eSpark-Backup/patrizio-moi-pcb-fixes/Design_Files/10 - Manley VS-MU - 21-June-2025/Deliverables/Renderings/2D_Top_Vieew.PNG

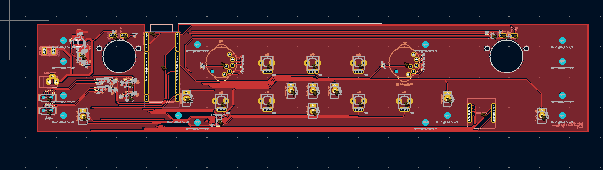
Design_Files/10 - Manley VS-MU - 21-June-2025/Deliverables/Renderings/2D_Top_Vieew.PNG
