eSpark-Backup/patrizio-moi-pcb-fixes/Client-Files/04 - UREI_V3 - 30-July-2025/Production Files/Bills of Materials/BOM.xlsx

Comment | Designator | Footprint | LCSC Part Number | Quantity
D1 | BAT54SW | Diode_SMD:D_SOD-323 | C27636114 | 1
AudioIn1 | AudioIn | Connector_Audio:Jack_3.5mm_PJ320D_Horizontal | C22459515 | 1
MUX1 | CD4067BMT/TR | Package_SO:TSSOP-24_4.4x7.8mm_P0.65mm | C7432333 | 1
U1 | MP2307DN-LF-Z | Package_SO:SOIC-8-1EP_3.9x4.9mm_P1.27mm_EP2.29x3mm_ThermalVias | C2928813 | 1
R19 | 43â€¯kÎ© | Resistor_SMD:R_0402_1005Metric | C2906943 | 1
C6,C10,C11 | 22uF | Capacitor_SMD:C_0603_1608Metric | C59461 | 3
L1 | 10ÂµH | Inductor_SMD:L_Bourns-SRN8040_8x8.15mm | C37429 | 1
R1 | 4.7KÎ© | Resistor_SMD:R_0402_1005Metric | C25900 | 1
R23 | 3.3KÎ© | Resistor_SMD:R_0402_1005Metric | C25890 | 1
R3,R4,R5,R6,R7,R8,R10,R11,R12,R13,R14,R15 | 2.2KÎ© | Resistor_SMD:R_0402_1005Metric | C25879 | 12
R25 | 47KÎ© | Resistor_SMD:R_0402_1005Metric | C25792 | 1
R21,R22,R24 | 10KÎ© | Resistor_SMD:R_0402_1005Metric | C25744 | 3
R20 | 10â€¯kÎ© | Resistor_SMD:R_0402_1005Metric | C25744 | 1
R17 | 10K | Resistor_SMD:R_0603_1608Metric | C25744 | 1
R2,R9 | 100Î© | Resistor_SMD:R_0402_1005Metric | C25076 | 2
C12,C13,C14,C16 | 4.7uF | Capacitor_SMD:C_0402_1005Metric | C23733 | 4
C8 | 4.7â€¯ÂµF | Capacitor_SMD:C_0402_1005Metric | C23733 | 1
C1 | 0.1uF | Capacitor_SMD:C_0402_1005Metric | C14663 | 1
C2,C3 | 2.2uF | Capacitor_SMD:C_0402_1005Metric | C12530 | 2
R16 | 1kÎ© | Resistor_SMD:R_0402_1005Metric | C11702 | 1
OpAmp1 | MCP6002- | Package_SO:SOIC-8_3.9x4.9mm_P1.27mm | C7377 | 1
NPN_Transistor1 | 2N2219 | Package_TO_SOT_SMD:SOT-23 | C2150 | 1
C5 | 2.2nF | Capacitor_SMD:C_0603_1608Metric | C1604 | 1
C17 | 0.1uF | Capacitor_SMD:C_0402_1005Metric | C1525 | 1
C4,C7,C9 | 0.1â€¯ÂµF | Capacitor_SMD:C_0402_1005Metric | C1525 | 3
VU73_Lamp-1 | VU73_Lamp | Connector_PinSocket_2.54mm:PinSocket_1x02_P2.54mm_Vertical | NILL | 1
VU73-1 | VU73 | Connector_PinSocket_2.54mm:PinSocket_1x02_P2.54mm_Vertical | NILL | 1
USR-ES1 | USR-ES1 | RF:USRES1 | NILL | 1
toggle_sw1,toggle_sw2,toggle_sw3,toggle_sw4,toggle_sw5,toggle_sw6,toggle_sw7,toggle_sw8 | button | Button_Switch_THT:SW_PB21E09471-465 | NILL | 8
SW1,SW2 | SW_Rotary_1x7_MP | SW_Rotary:SW_Rotary_RS25-7P | NILL | 2
R26 | 92R | Resistor_SMD:R_0402_1005Metric | NILL | 1
R18 | 100kÎ© | Resistor_SMD:R_0603_1608Metric | NILL | 1
Power_jack1 | Jack-DC | Connector_BarrelJack:BarrelJack_Horizontal | NILL | 1
pot1,pot2 | b10k | Potentiometer_THT:Potentiometer_Alps_RK09K_Single_Vertical | NILL | 2
JST_XH-1,JST_XH-2 | JST_XH_2_Pin | Connector_JST:JST_XH_B2B-XH-A_1x02_P2.50mm_Vertical | NILL | 2
ESP32-S3-1 | ESP32-S3-DevKitC | Espressif:ESP32-S3-DEVKITC-1-N8R2-2 | NILL | 1
C15 | 0.1uF | Capacitor_SMD:C_0402_1005Metric | NILL | 1
