eSpark-Backup/patrizio-moi-pcb-fixes/Client-Files/17 - Summit EQP200B 30-JUL-2025/Production Files/Bills of Materials/BOM.xlsx

Comment | Designator | Footprint | LCSC Part Number | Quantity
CD4067BMT/TR | MUX1,MUX2 | Package_SO:TSSOP-24_4.4x7.8mm_P0.65mm | C7432333 | 2
MP2307DN-LF-Z | U1 | Package_SO:SOIC-8-1EP_3.9x4.9mm_P1.27mm_EP2.29x3mm_ThermalVias | C2928813 | 1
43â€¯kÎ© | R36 | Resistor_SMD:R_0402_1005Metric | C2906943 | 1
22uF | C11,C15,C16 | Capacitor_SMD:C_0603_1608Metric | C59461 | 3
10ÂµH | L1 | Inductor_SMD:L_Bourns-SRN8040_8x8.15mm | C37429 | 1
2.2KÎ© | R3,R4,R5,R6,R9,R10,R11,R12,R13,R14,R15,R16,R19,R20,R21,R22,R23,R24,R25,R26,R27,R28,R29,R30,R31,R32 | Resistor_SMD:R_0402_1005Metric | C25879 | 26
10â€¯kÎ© | R37 | Resistor_SMD:R_0402_1005Metric | C25744 | 1
10KÎ© | R34 | Resistor_SMD:R_0603_1608Metric | C25744 | 1
100Î© | R1,R2,R7,R8,R17,R18 | Resistor_SMD:R_0402_1005Metric | C25076 | 6
4.7â€¯ÂµF | C13 | Capacitor_SMD:C_0402_1005Metric | C23733 | 1
100kÎ© | R35 | Resistor_SMD:R_0603_1608Metric | C23212 | 1
2.2uF | C3,C4,C5,C6,C7,C8 | Capacitor_SMD:C_0402_1005Metric | C12530 | 6
1kÎ© | R33 | Resistor_SMD:R_0402_1005Metric | C11702 | 1
2N2219 | NPN_Transistor1 | Package_TO_SOT_SMD:SOT-23 | C2150 | 1
2.2nF | C10 | Capacitor_SMD:C_0603_1608Metric | C1604 | 1
0.1â€¯ÂµF | C9,C12,C14 | Capacitor_SMD:C_0402_1005Metric | C1525 | 3
0.1uF | C1,C2 | Capacitor_SMD:C_0402_1005Metric | C1525 | 2
USR-ES1 | USR-ES1 | RF:USRES1 | NILL | 1
toggle_sw_3p | toggle_sw_3p-1,toggle_sw_3p-2 | digikey-footprints:Toggle_Switch-3-pins | NILL | 2
toggle_sw_2p | toggle_sw_2p-1 | digikey-footprints:Toggle_Switch-2-pins | NILL | 1
SW_Rotary_1x8_MP | SW5,SW6 | SW_Rotary:SW_Rotary_RS25-8P | NILL | 2
SW_Rotary_1x5_MP | SW3,SW4 | SW_Rotary:SW_Rotary_RS25-5P | NILL | 2
SW_Rotary_1x3_MP | SW1,SW2 | SW_Rotary:SW_Rotary_RS25-3P | NILL | 2
Jack-DC | Power_jack1 | Connector_BarrelJack:BarrelJack_Horizontal | NILL | 1
b10k | pot1,pot2,pot3,pot4,pot5,pot6,pot7,pot8,pot9,pot10 | Potentiometer_THT:Potentiometer_Alps_RK09K_Single_Vertical | NILL | 10
JST_XH_2_Pin | JST_XH-1,JST_XH-2 | Connector_JST:JST_XH_B2B-XH-A_1x02_P2.50mm_Vertical | NILL | 2
ESP32-S3-DevKitC | ESP32-S3-1 | Espressif:ESP32-S3-DEVKITC-1-N8R2-2 | NILL | 1
LED_Pultec EQP1A | D1 | LED_THT:LED_Pultech_1 | NILL | 1
