eSpark-Backup/patrizio-moi-pcb-fixes/Client-Files/04 - UREI_V3 - 30-July-2025/Design Files/DXF/S4 For PCB Adeel (2).dxf

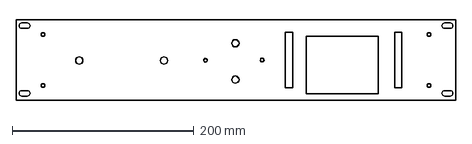
[picture p2: CAD file, 2025-07-31]
Client-Files/04 - UREI_V3 - 30-July-2025/Design Files/DXF/S4 For PCB Adeel (2).dxf
482.6 x 88.9 mm
