eSpark-Backup/patrizio-moi-pcb-fixes/Client-Files/04 - UREI_V3 - 30-July-2025/Production Files/Step/Step.step

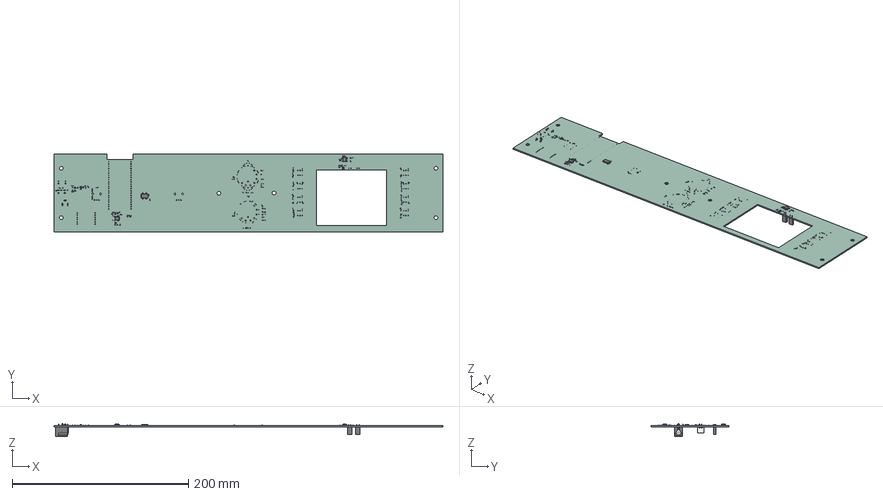
[picture p4: CAD file, 2025-07-31]
Client-Files/04 - UREI_V3 - 30-July-2025/Production Files/Step/Step.step
440.9 x 88.8 x 14.6 mm
SOT-23
R_0402_1005Metric x 24
C_0402_1005Metric x 13
SOIC-8_3.9x4.9mm_P1.27mm
C_0603_1608Metric x 4
R_0603_1608Metric x 2
TSSOP-24_4.4x7.8mm_P0.65mm
SOIC-8-1EP_3.9x4.9mm_P1.27mm_EP2.29x3mm
D_SOD-323
JST_XH_B2B-XH-A_1x02_P2.50mm_Vertical x 2
PinSocket_1x02_P2.54mm_Vertical x 2
BarrelJack_Horizontal
UREI 1176_silkscreen
UREI 1176_PCB
