eSpark-Backup/patrizio-moi-pcb-fixes/Client-Files/06  - TubeTech CL1B - 3-July-2025/DXF/S6 For PCB Adeel (1).dxf

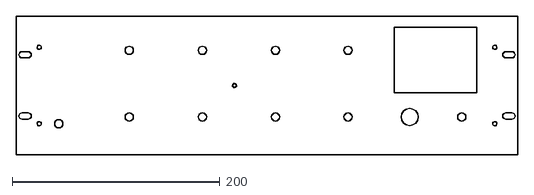
[picture p5: CAD file, 2025-07-31]
Client-Files/06 - TubeTech CL1B - 3-July-2025/DXF/S6 For PCB Adeel (1).dxf
482.6 x 133.3
