eSpark-Backup/patrizio-moi-pcb-fixes/Client-Files/06  - TubeTech CL1B - 3-July-2025/Graphics/6  - TubeTech CL1B.dxf

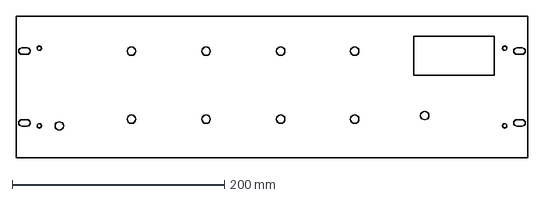
[picture p6: CAD file, 2025-07-31]
Client-Files/06 - TubeTech CL1B - 3-July-2025/Graphics/6 - TubeTech CL1B.dxf
482.6 x 133.4 mm
