eSpark-Backup/patrizio-moi-pcb-fixes/Client-Files/06  - TubeTech CL1B - 3-July-2025/Step/TubeTech_CL1.step

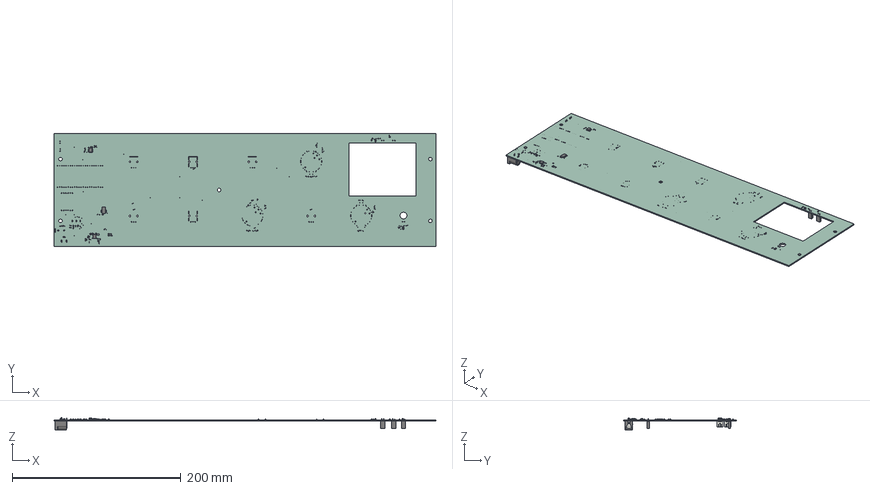
[picture p7: CAD file, 2025-07-31]
Client-Files/06 - TubeTech CL1B - 3-July-2025/Step/TubeTech_CL1.step
452.9 x 133.4 x 14.6 mm
R_0603_1608Metric x 3
C_0402_1005Metric x 14
R_0402_1005Metric x 18
C_0603_1608Metric x 4
TSSOP-24_4.4x7.8mm_P0.65mm
SOIC-8-1EP_3.9x4.9mm_P1.27mm_EP2.29x3mm
D_SOD-323
SOT-23 x 2
SOIC-8_3.9x4.9mm_P1.27mm
BarrelJack_Horizontal
JST_XH_B2B-XH-A_1x02_P2.50mm_Vertical x 2
PinSocket_1x02_P2.54mm_Vertical x 3
TubeTech_CL1_silkscreen
TubeTech_CL1_PCB
