eSpark-Backup/patrizio-moi-pcb-fixes/Client-Files/16 - Fairchild - 22-June-2025/DXF/S16 For PCB Adeel.DXF

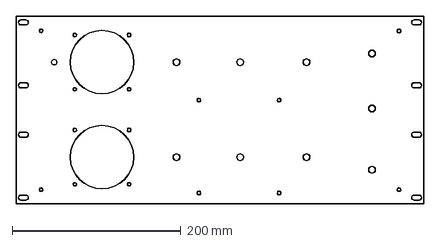
[picture p8: CAD file, 2025-07-31]
Client-Files/16 - Fairchild - 22-June-2025/DXF/S16 For PCB Adeel.DXF
482.6 x 222.5 mm
