eSpark-Backup/patrizio-moi-pcb-fixes/Client-Files/16 - Fairchild - 22-June-2025/Graphics/16 - Fairchild 670 -2.dxf

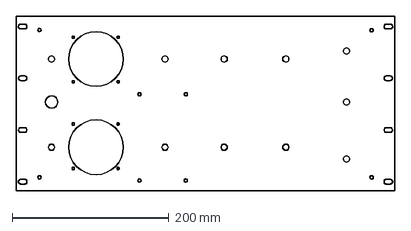
[picture p9: CAD file, 2025-07-31]
Client-Files/16 - Fairchild - 22-June-2025/Graphics/16 - Fairchild 670 -2.dxf
482.6 x 222.2 mm
