eSpark-Backup/patrizio-moi-pcb-fixes/Client-Files/17 - Summit EQP200B 30-JUL-2025/Design Files/Graphics/17 - Summit EQP 200B.dxf

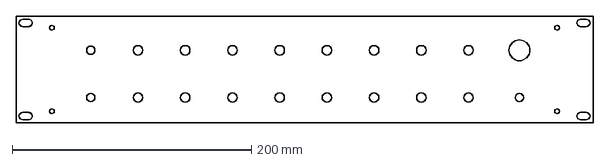
[picture p11: CAD file, 2025-07-31]
Client-Files/17 - Summit EQP200B 30-JUL-2025/Design Files/Graphics/17 - Summit EQP 200B.dxf
482.6 x 88.9 mm
