eSpark-Backup/patrizio-moi-pcb-fixes/Client-Files/17 - Summit EQP200B 30-JUL-2025/Production Files/Step/step.step

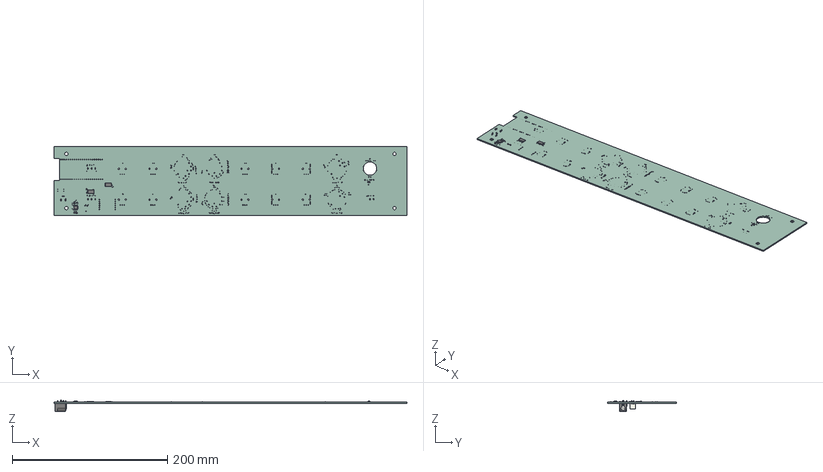
[picture p12: CAD file, 2025-07-31]
Client-Files/17 - Summit EQP200B 30-JUL-2025/Production Files/Step/step.step
454.6 x 88.7 x 14.6 mm
C_0402_1005Metric x 12
R_0402_1005Metric x 35
R_0603_1608Metric x 2
SOT-23
C_0603_1608Metric x 4
TSSOP-24_4.4x7.8mm_P0.65mm x 2
SOIC-8-1EP_3.9x4.9mm_P1.27mm_EP2.29x3mm
JST_XH_B2B-XH-A_1x02_P2.50mm_Vertical x 2
BarrelJack_Horizontal
Summit-EQP200B_silkscreen
Summit-EQP200B_PCB
