eSpark-Backup/patrizio-moi-pcb-fixes/Client-Files/19 - SSL FXG384 - 19-June-2025/DXF/S19 for PCB Adeel.DXF

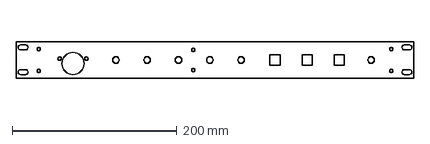
[picture p13: CAD file, 2025-07-31]
Client-Files/19 - SSL FXG384 - 19-June-2025/DXF/S19 for PCB Adeel.DXF
482.6 x 44.4 mm
