eSpark-Backup/patrizio-moi-pcb-fixes/Client-Files/19 - SSL FXG384 - 19-June-2025/Graphics/19 - SSL FXG384.dxf

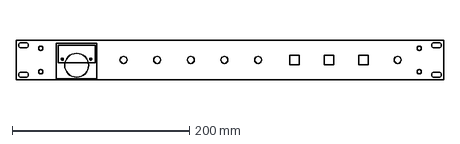
[picture p14: CAD file, 2025-07-31]
Client-Files/19 - SSL FXG384 - 19-June-2025/Graphics/19 - SSL FXG384.dxf
482.6 x 44.4 mm
