eSpark-Backup/patrizio-moi-pcb-fixes/Client-Files/20 - Telektronix LA3A - 3-July-2025/Graphics/Teletronix-LA-2A-2.dxf

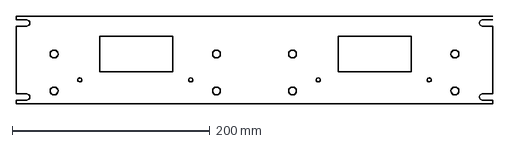
[picture p16: CAD file, 2025-07-31]
Client-Files/20 - Telektronix LA3A - 3-July-2025/Graphics/Teletronix-LA-2A-2.dxf
482.6 x 88.8 mm
