eSpark-Backup/patrizio-moi-pcb-fixes/Client-Files/20 - Telektronix LA3A - 3-July-2025/Step/Teletronix_LA3A.step

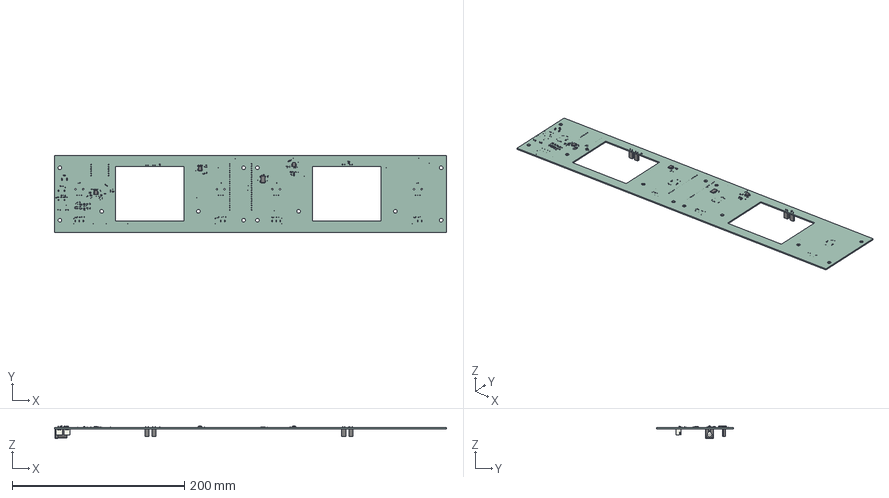
[picture p17: CAD file, 2025-07-31]
Client-Files/20 - Telektronix LA3A - 3-July-2025/Step/Teletronix_LA3A.step
455.0 x 88.8 x 14.6 mm
C_0402_1005Metric x 17
R_0603_1608Metric x 4
SOIC-8-1EP_3.9x4.9mm_P1.27mm_EP2.29x3mm
R_0402_1005Metric x 15
SOIC-8_3.9x4.9mm_P1.27mm x 2
SOT-23
C_0603_1608Metric x 4
TSSOP-24_4.4x7.8mm_P0.65mm
D_SOD-323 x 2
PinSocket_1x02_P2.54mm_Vertical x 4
JST_XH_B2B-XH-A_1x02_P2.50mm_Vertical x 2
BarrelJack_Horizontal
Teletronix_LA3A_silkscreen
Teletronix_LA3A_PCB
