eSpark-Backup/patrizio-moi-pcb-fixes/Design_Files/10 - Manley VS-MU - 21-June-2025/Deliverables/Step/Manley-VS-MU.step

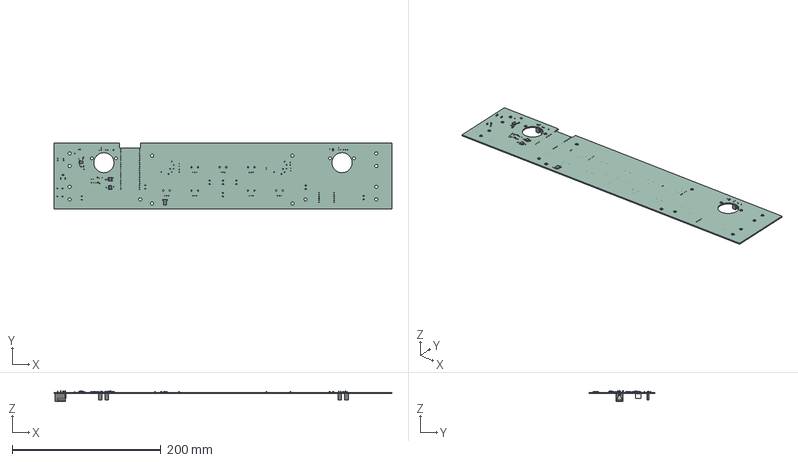
[picture p18: CAD file, 2025-08-05]
Design_Files/10 - Manley VS-MU - 21-June-2025/Deliverables/Step/Manley-VS-MU.step
455.0 x 89.1 x 14.6 mm
R_0402_1005Metric x 27
C_0402_1005Metric x 19
R_0603_1608Metric x 4
SOT-23
D_SOD-323 x 2
C_0603_1608Metric x 4
SOIC-8-1EP_3.9x4.9mm_P1.27mm_EP2.29x3mm
TSSOP-24_4.4x7.8mm_P0.65mm
SOIC-8_3.9x4.9mm_P1.27mm x 2
JST_XH_B2B-XH-A_1x02_P2.50mm_Vertical x 2
PinSocket_1x02_P2.54mm_Vertical x 4
BarrelJack_Horizontal
Manley-VS-MU_PCB
