eSpark-Backup/patrizio-moi-pcb-fixes/Design_Files/14 - Drawmer DS-201 - 7-June-2025/Graphics/14 - Drawmer DS-201.dxf

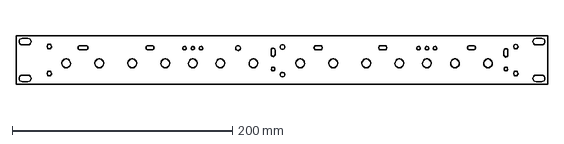
[picture p19: CAD file, 2025-07-31]
Design_Files/14 - Drawmer DS-201 - 7-June-2025/Graphics/14 - Drawmer DS-201.dxf
482.6 x 44.5 mm
