eSpark-Backup/patrizio-moi-pcb-fixes/Design_Files/16 - Fairchild - 22-June-2025/Step/Fairchild.step

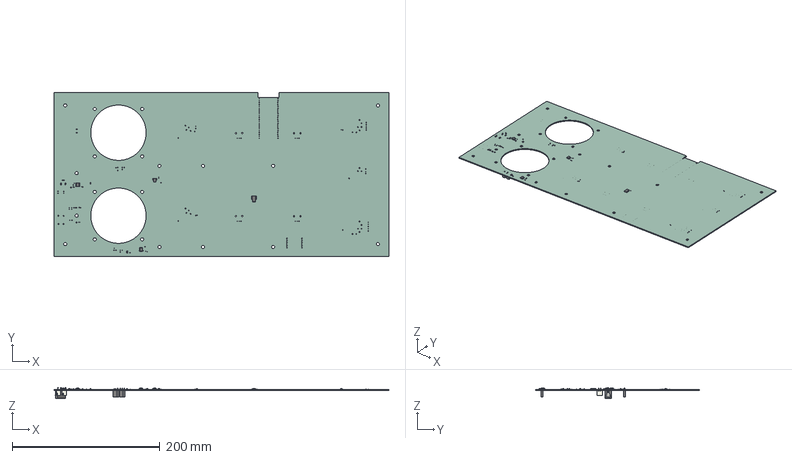
[picture p20: CAD file, 2025-08-06]
Design_Files/16 - Fairchild - 22-June-2025/Step/Fairchild.step
454.1 x 222.2 x 14.6 mm
C_0603_1608Metric x 4
C_0402_1005Metric x 34
TSSOP-24_4.4x7.8mm_P0.65mm
R_0402_1005Metric x 27
SOIC-8_3.9x4.9mm_P1.27mm x 2
D_SOD-323 x 2
R_0603_1608Metric x 2
SOIC-8-1EP_3.9x4.9mm_P1.27mm_EP2.29x3mm
SOT-23
BarrelJack_Horizontal
PinSocket_1x02_P2.54mm_Vertical x 4
JST_XH_B2B-XH-A_1x02_P2.50mm_Vertical x 2
Fairchild_PCB
