eSpark-Backup/patrizio-moi-pcb-fixes/Design_Files/24 - SSL EQ Rack - 6-June-2025/SSL-EQ-Rack.step

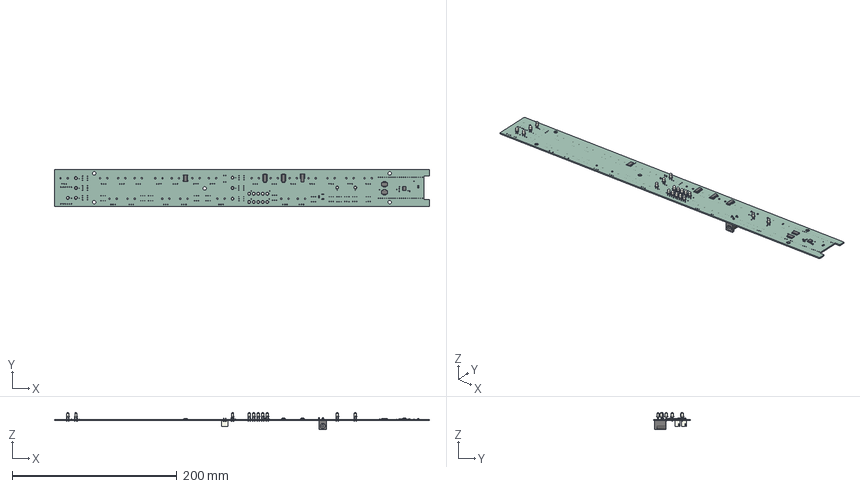
[picture p21: CAD file, 2025-08-07]
Design_Files/24 - SSL EQ Rack - 6-June-2025/SSL-EQ-Rack.step
455.1 x 44.4 x 20.7 mm
LED_D3.0mm_Clear x 19
R_0402_1005Metric x 21
SOIC-16_3.9x9.9mm_P1.27mm x 3
C_0603_1608Metric x 4
C_0402_1005Metric x 7
R_0603_1608Metric x 2
TSSOP-24_4.4x7.8mm_P0.65mm x 3
SOIC-8-1EP_3.9x4.9mm_P1.27mm_EP2.29x3mm
JST_XH_B2B-XH-A_1x02_P2.50mm_Vertical x 2
BarrelJack_Horizontal
SSL-EQ-Rack_PCB
