eSpark-Backup/patrizio-moi-pcb-fixes/Client-Files/04 - UREI_V3 - 30-July-2025/PDF/Schematic.pdf

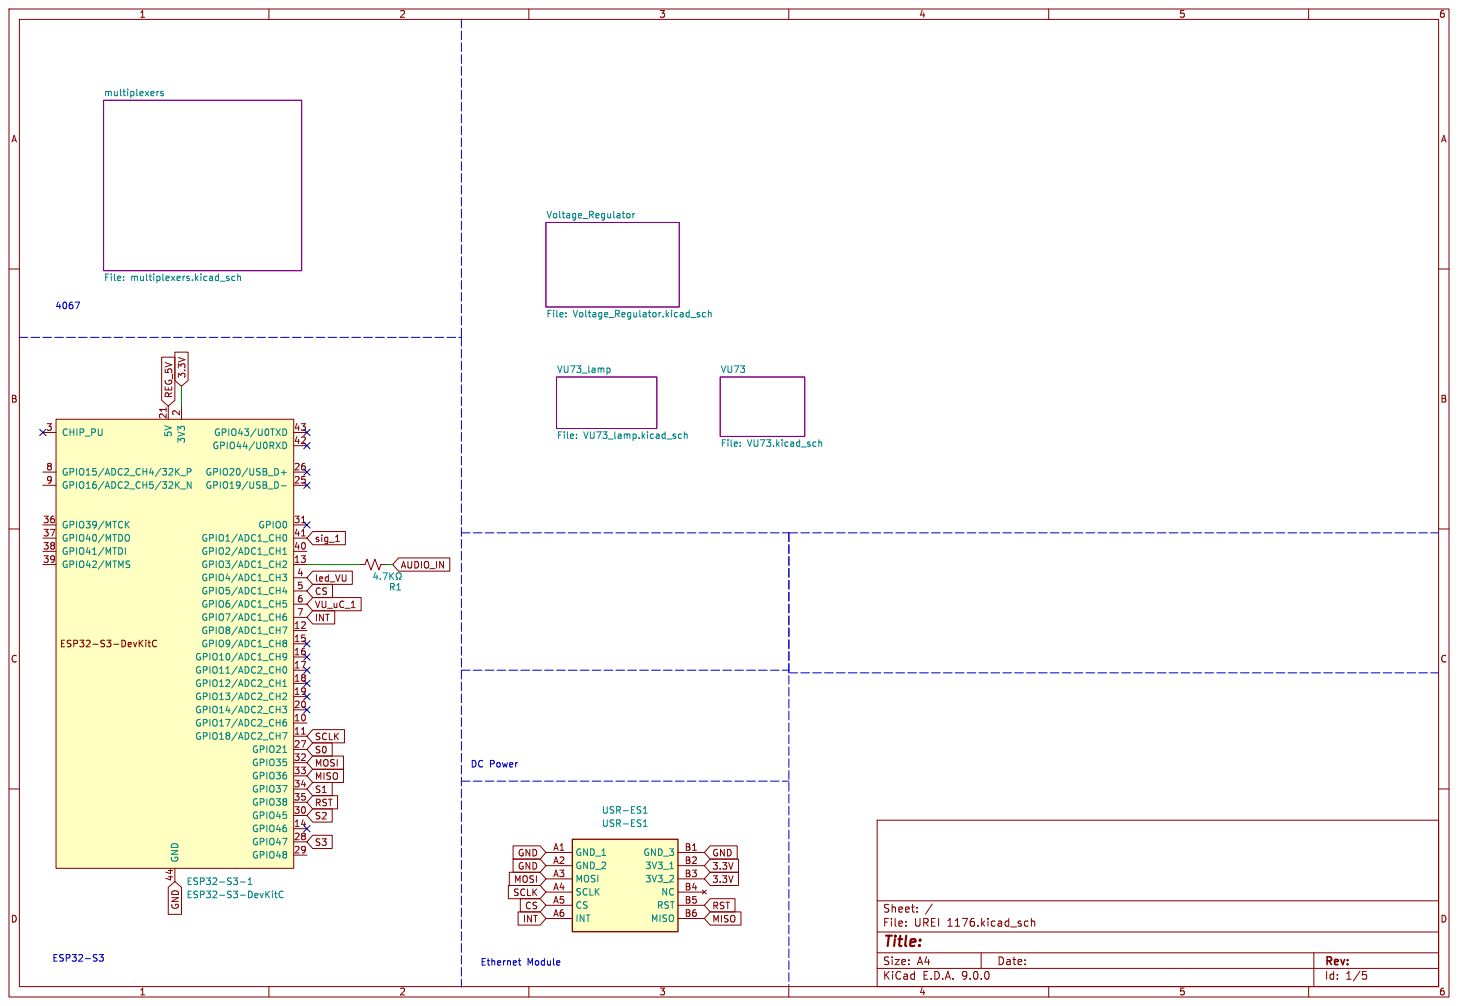
[picture p27: page 1]

led_VU
3V3_2 B3 NC B4 RST B5 MISO B6 USR-ES1 USR-ES1 CS
Ethernet Module DC Power

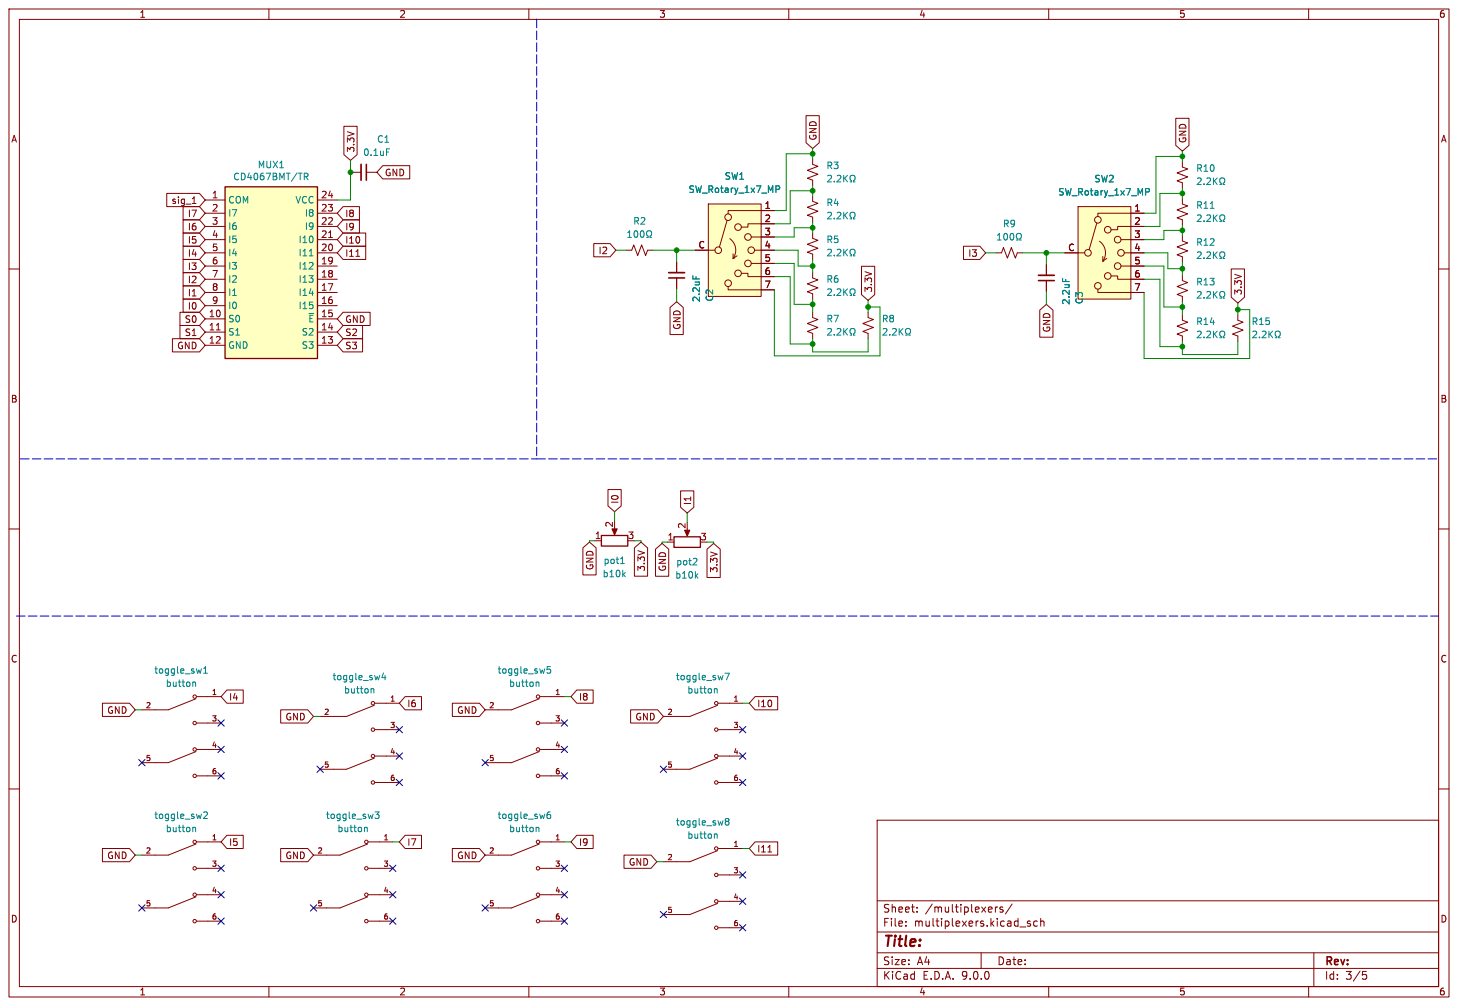
[picture p28: page 2]

Id: 3/5 Title: File: multiplexers.kicad_sch Sheet: /multiplexers/

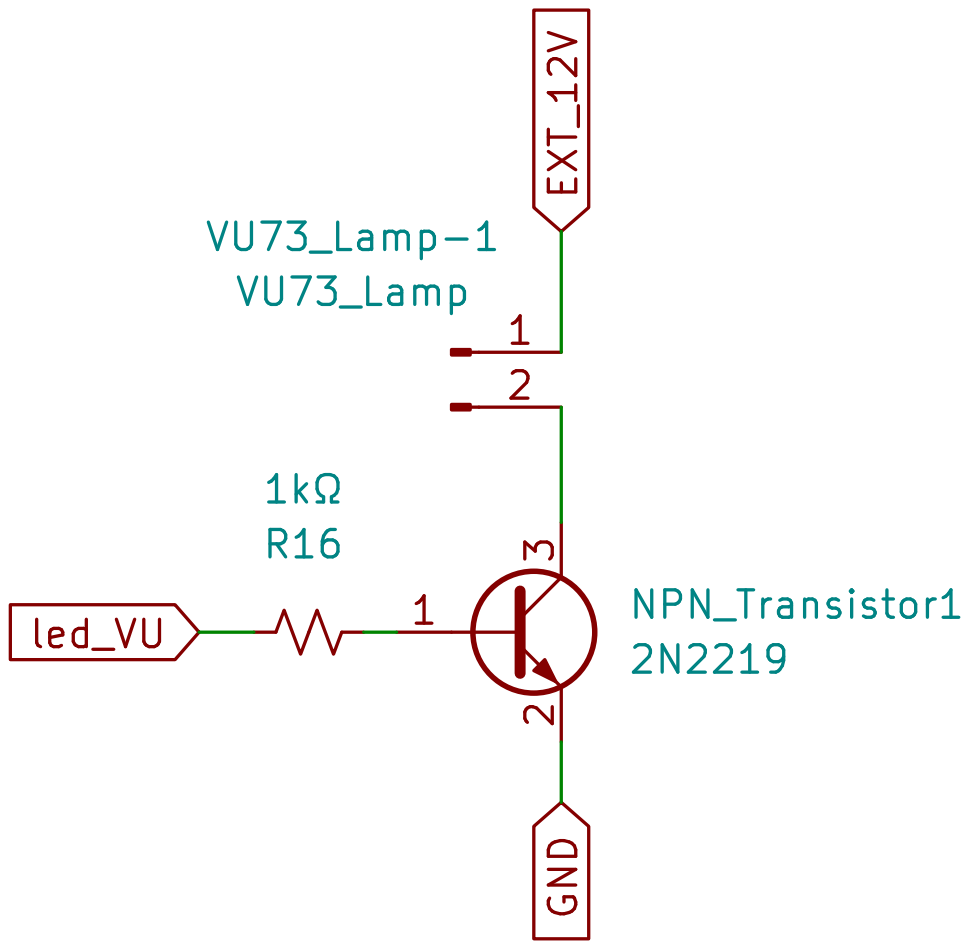
[picture p29: page 3]

Id: 4/5 Title: File: VU73_lamp.kicad_sch Sheet: /VU73_lamp/

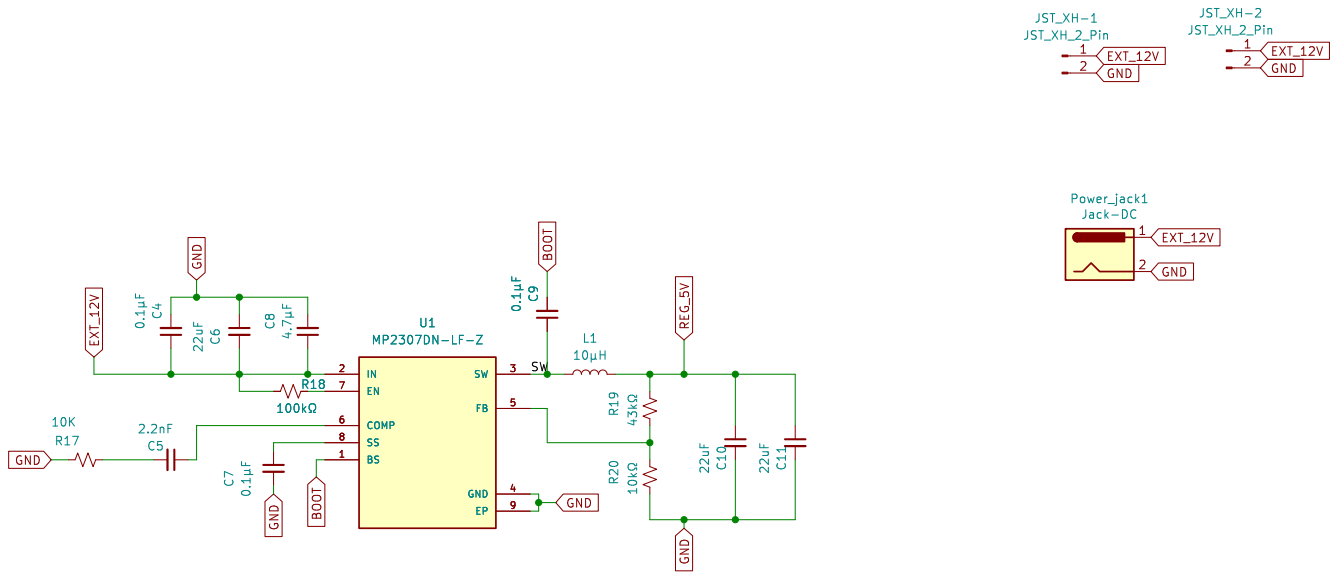
[picture p30: page 4]

Id: 5/5 Title: File: Voltage_Regulator.kicad_sch Sheet: /Voltage_Regulator/ R18

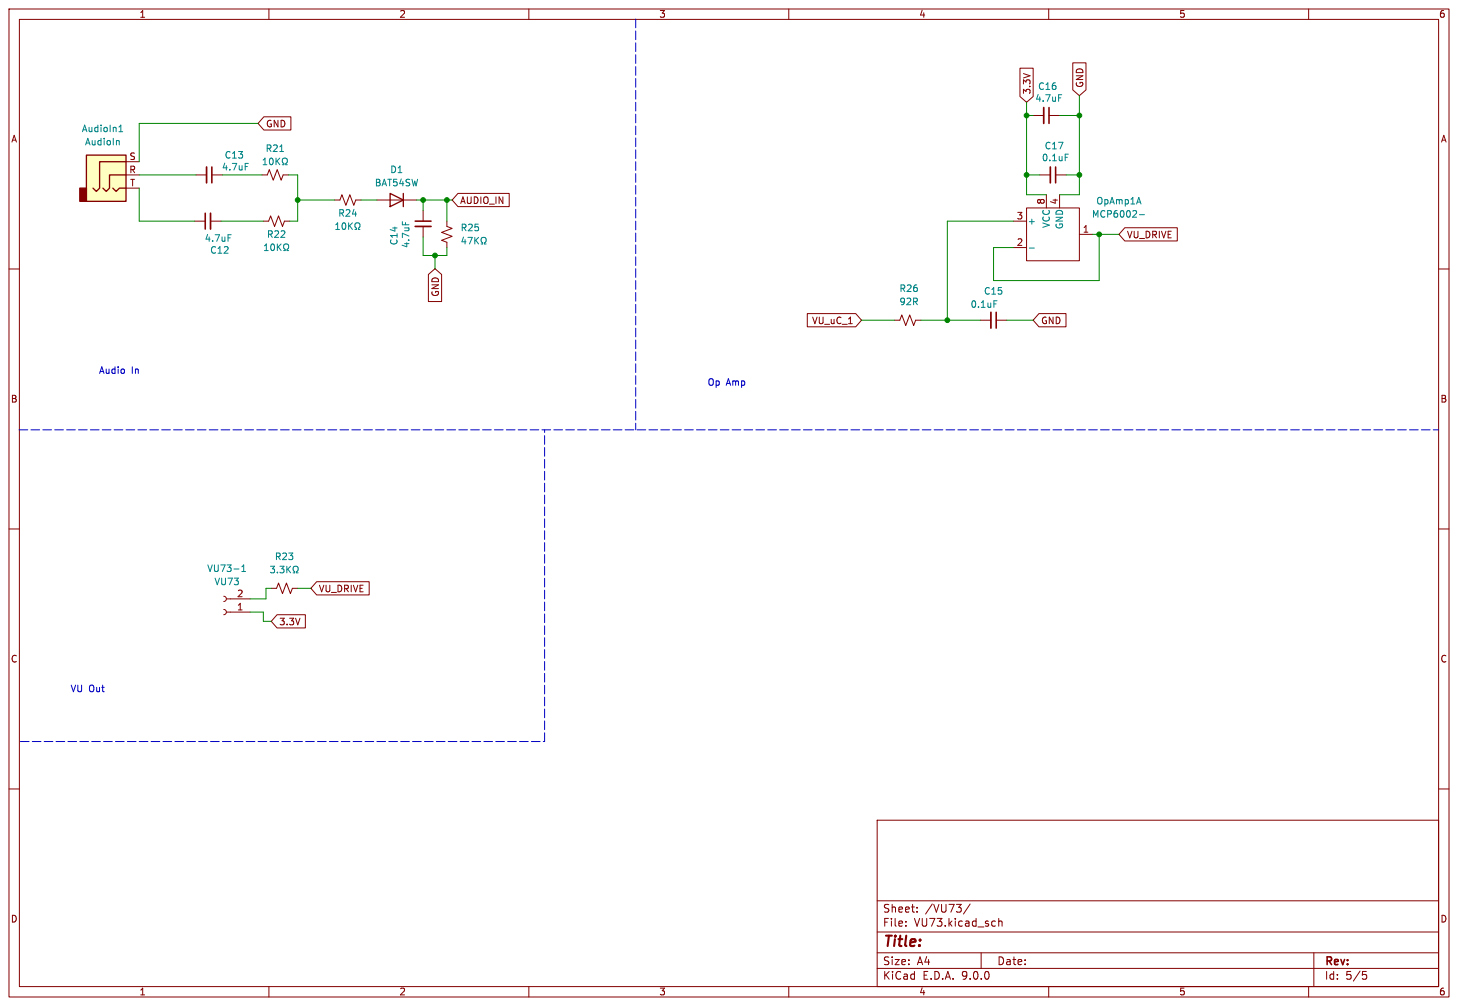
[picture p31: page 5]

Id: 5/5 Title: File: VU73.kicad_sch Sheet: /VU73/
