eSpark-Backup/patrizio-moi-pcb-fixes/Design_Files/10 - Manley VS-MU - 21-June-2025/Deliverables/Schematic/Manley-VS-MU.pdf

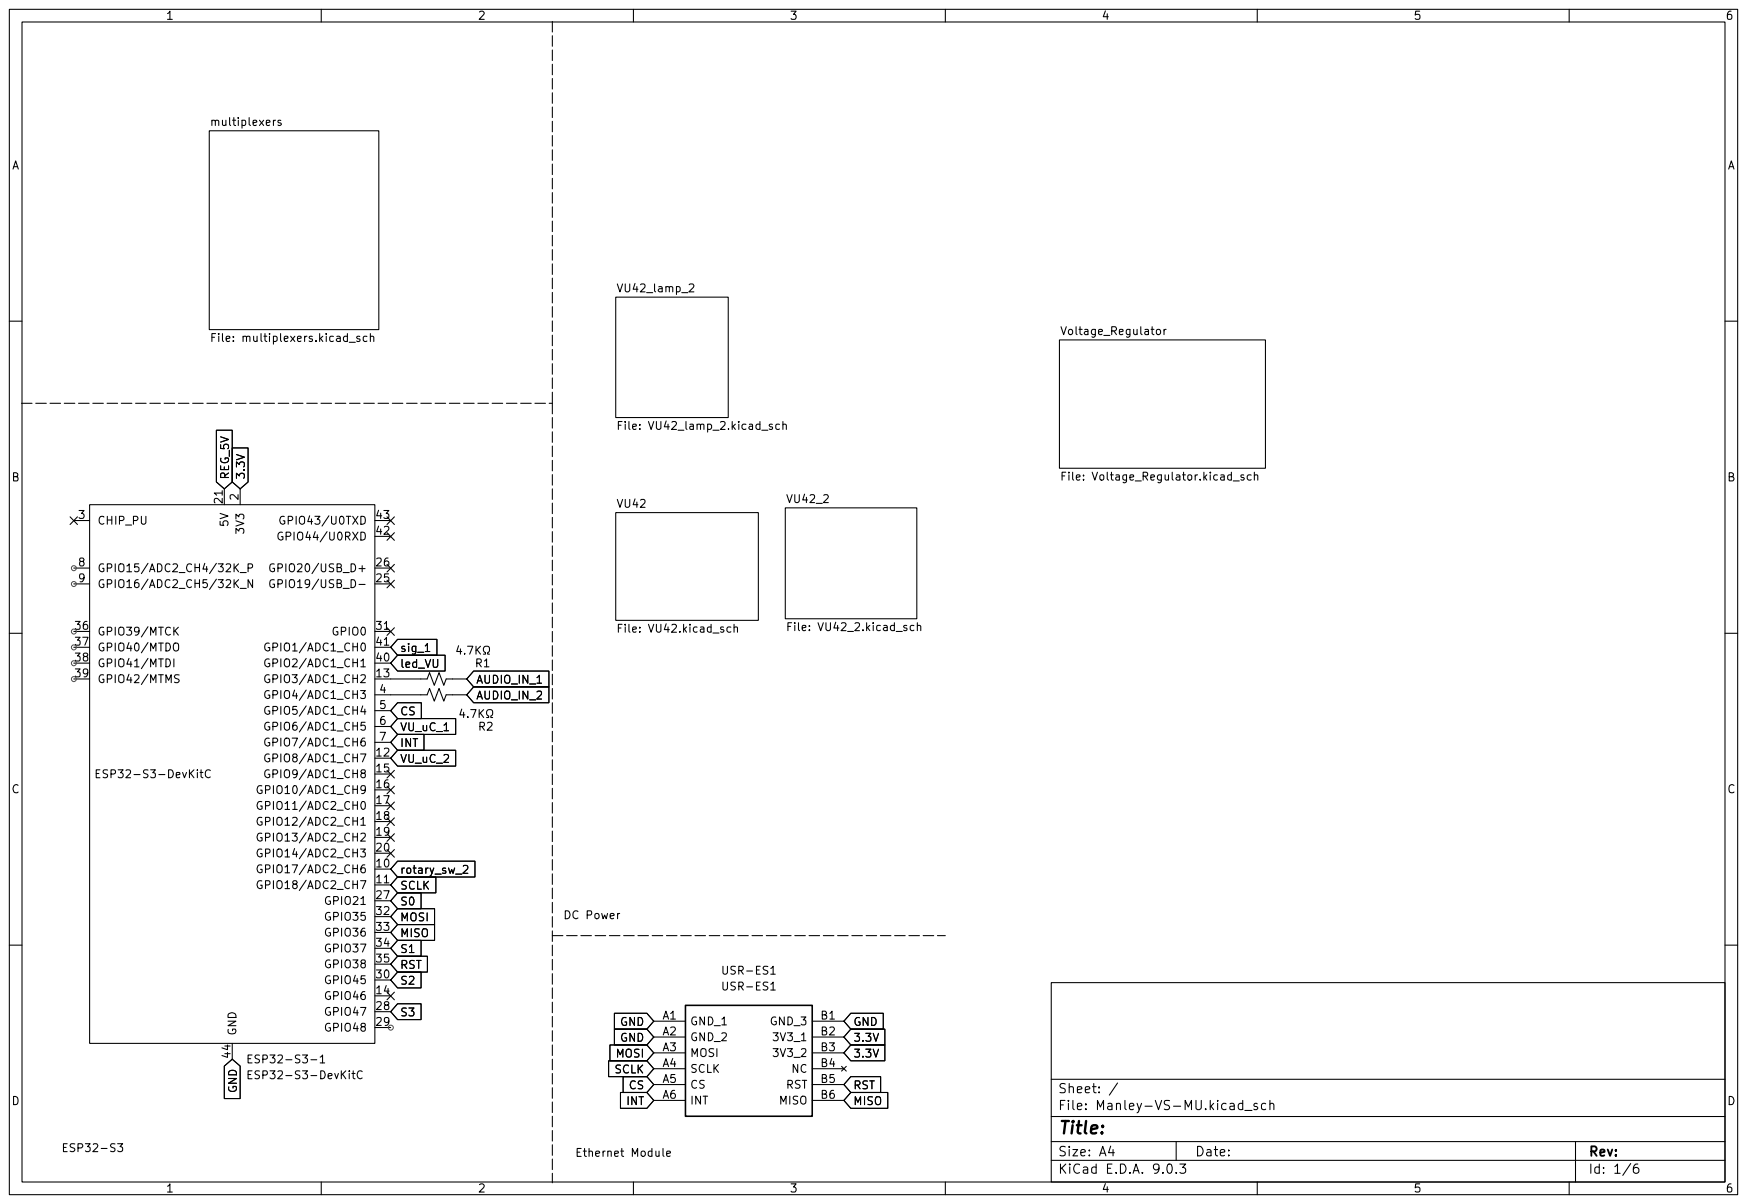
[picture p32: page 1]

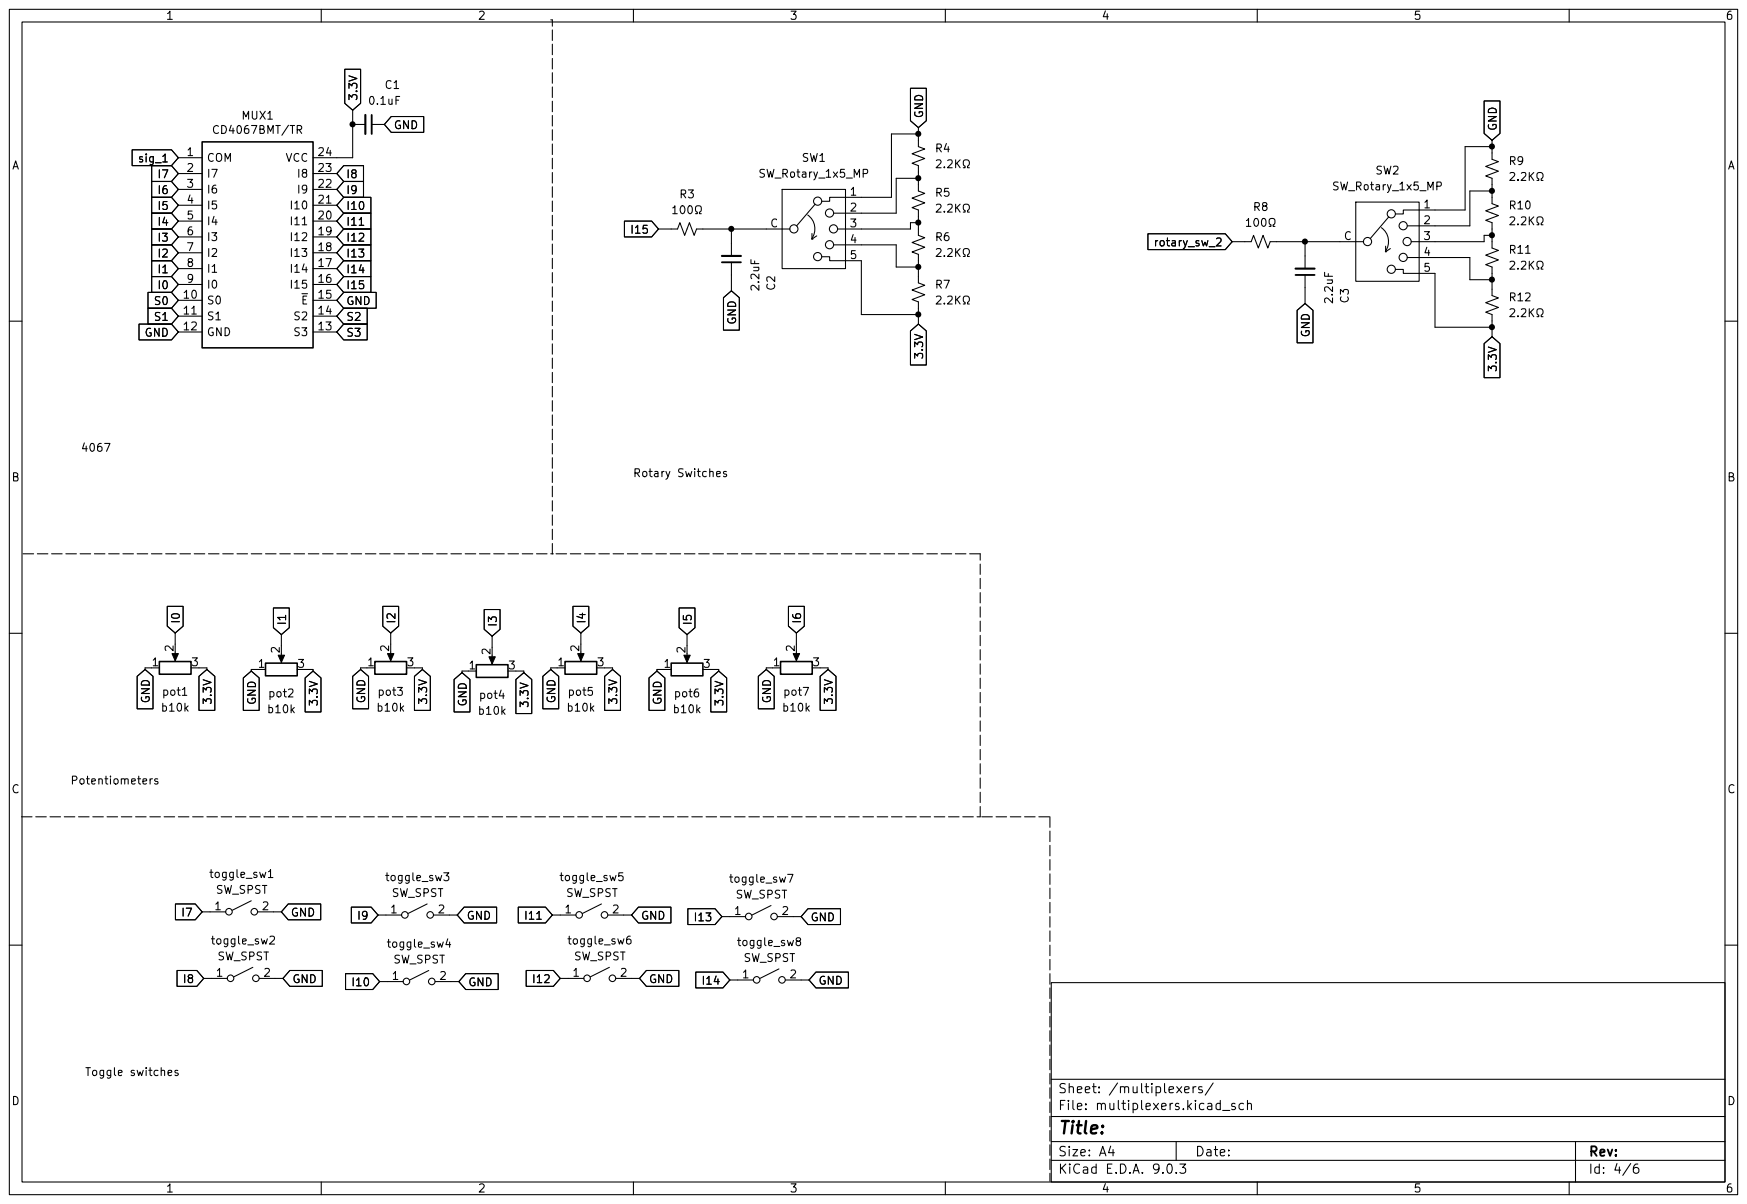
[picture p33: page 2]

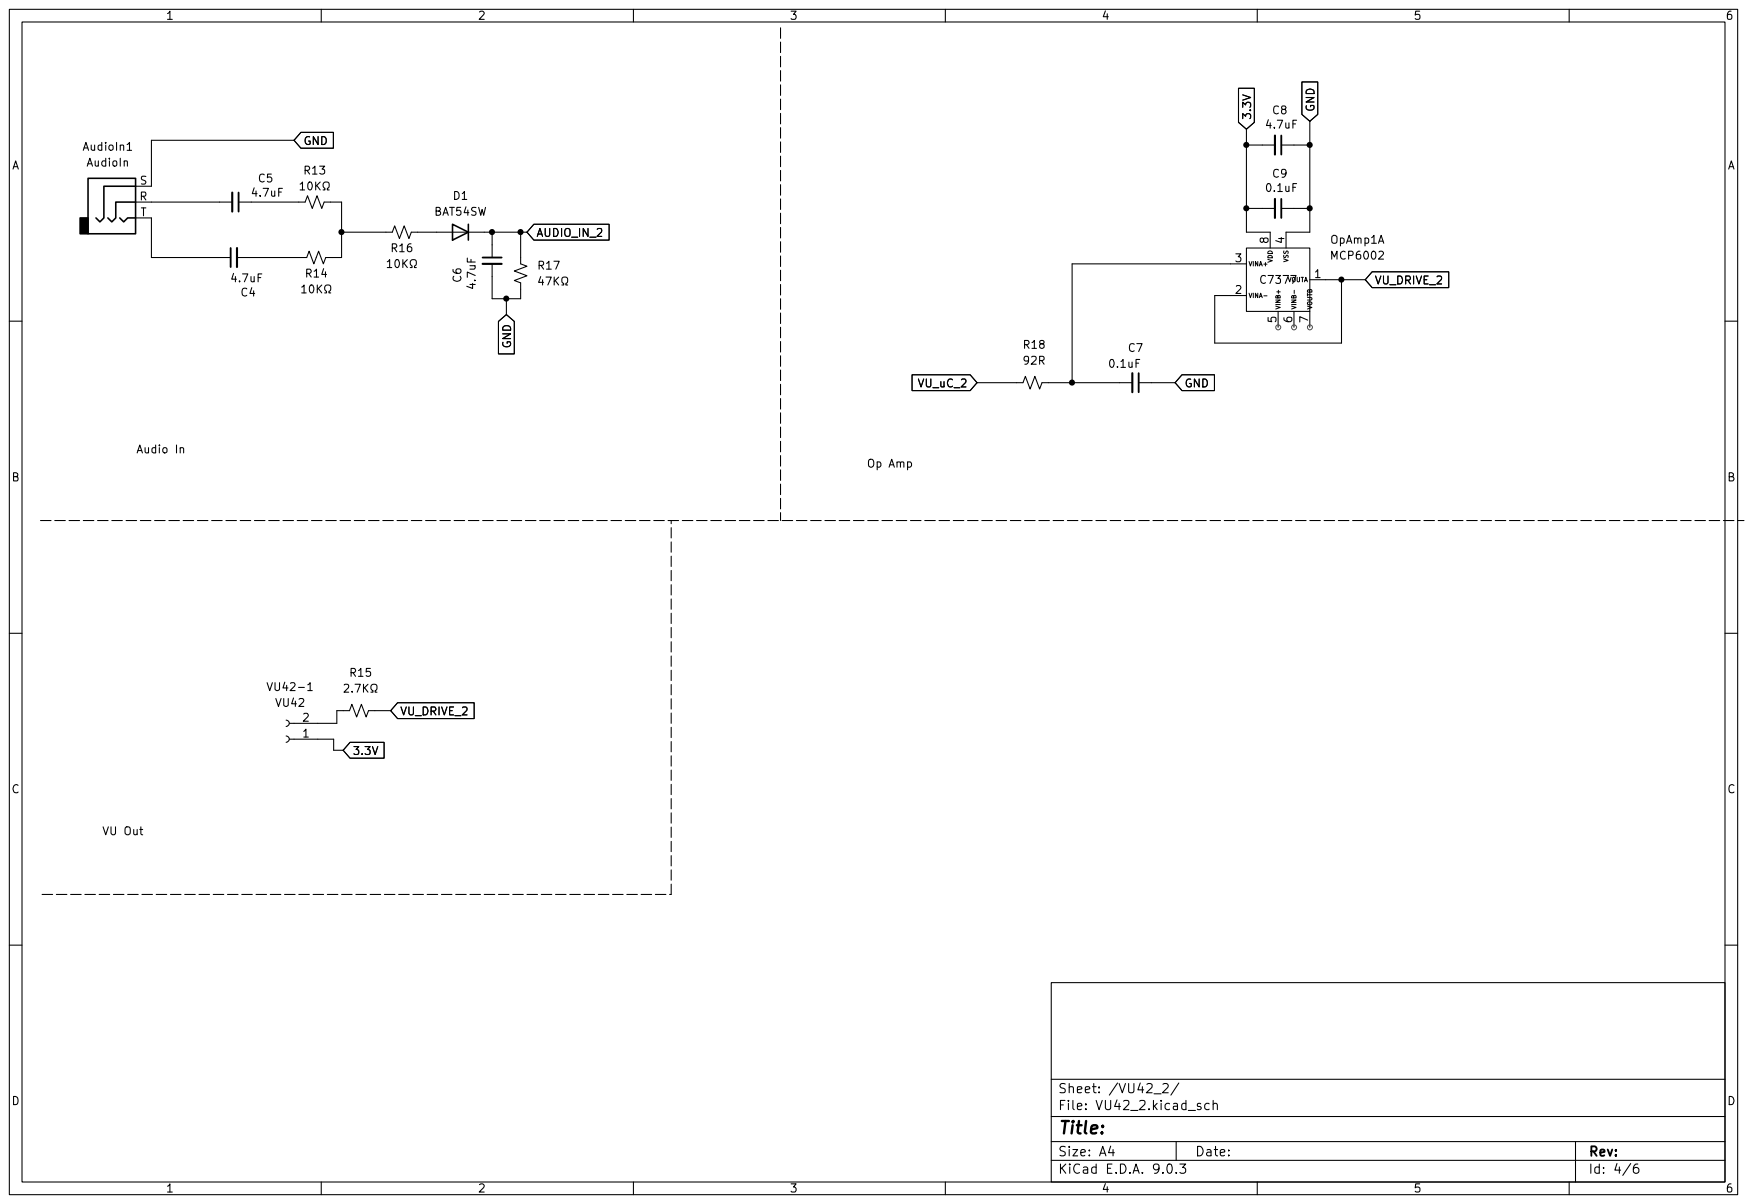
[picture p34: page 3]

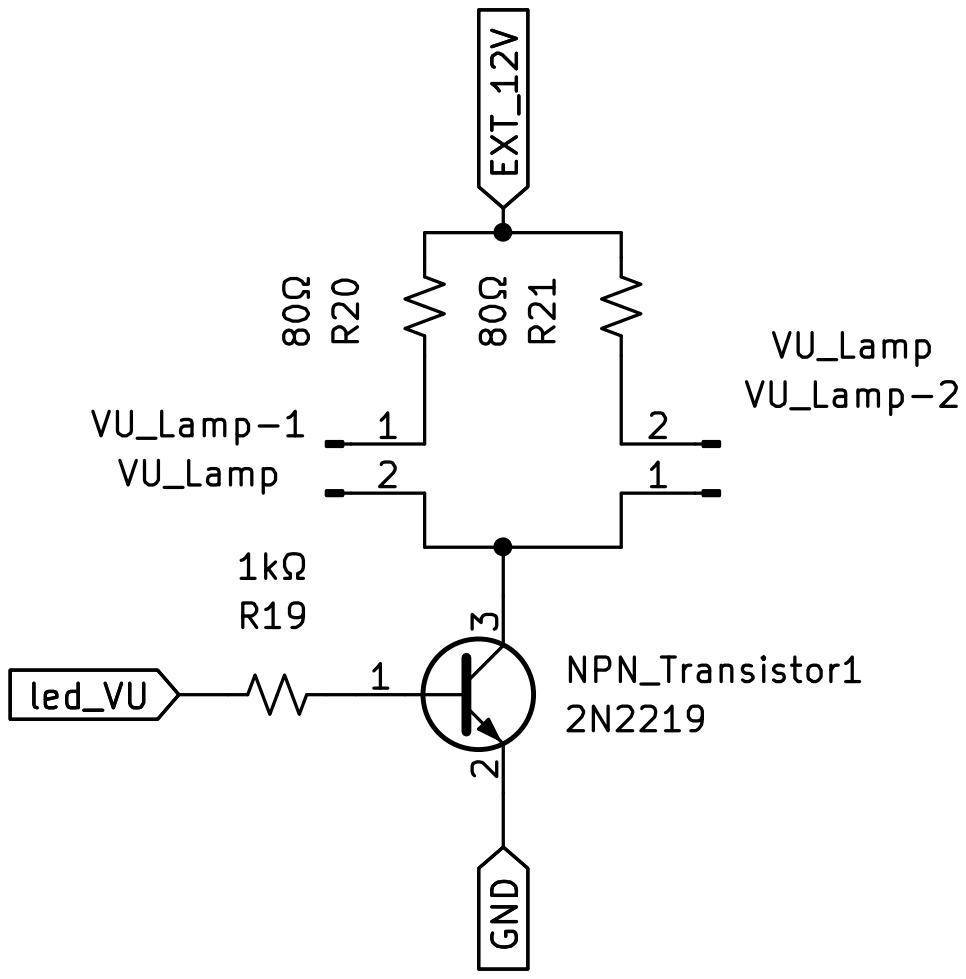
[picture p35: page 4]

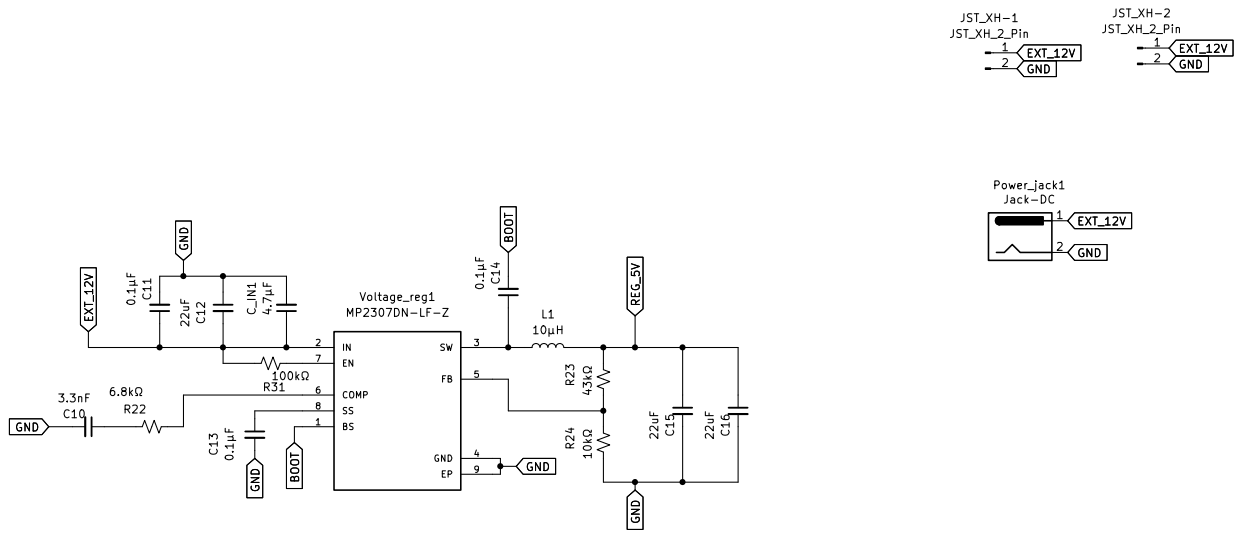
[picture p36: page 5]

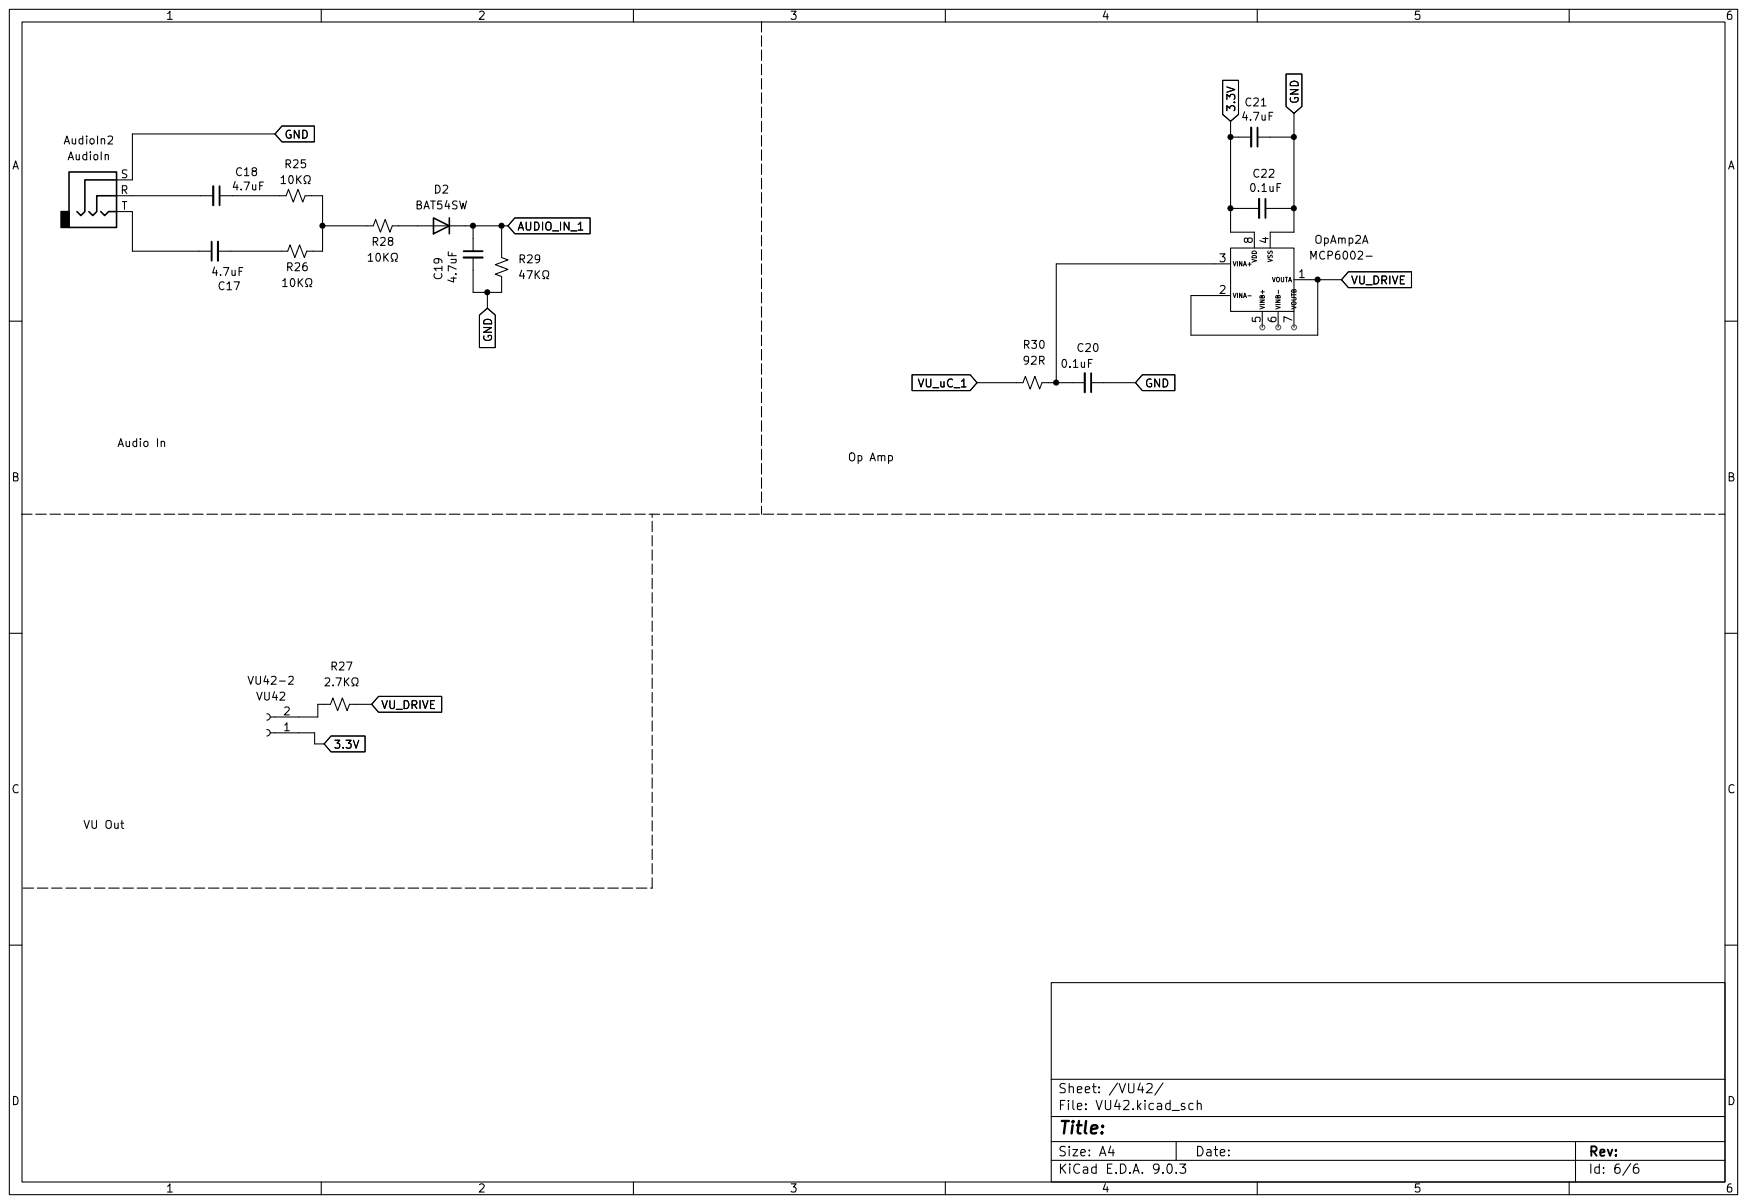
[picture p37: page 6]
