eSpark-Backup/patrizio-moi-pcb-fixes/Client-Files/04 - UREI_V3 - 30-July-2025/PDF/PCB Layout.pdf

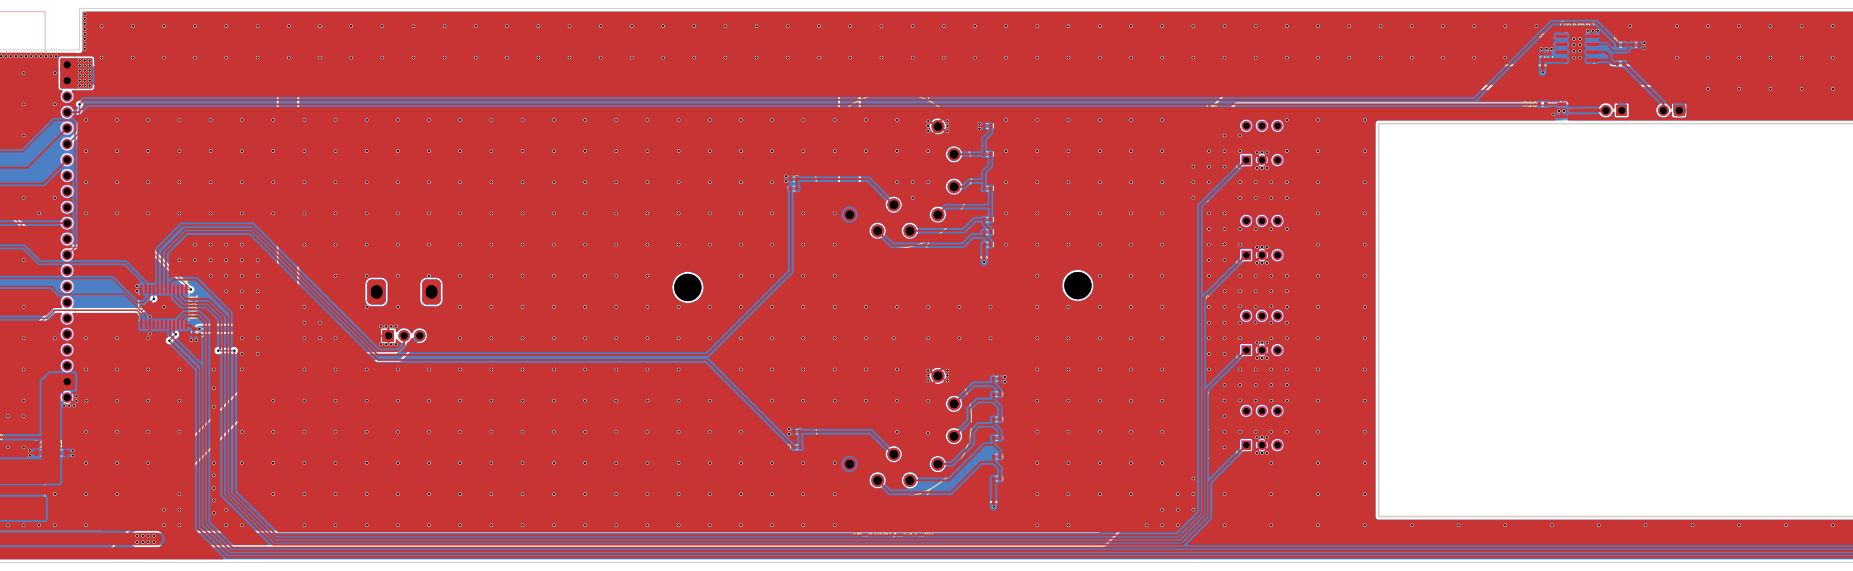
[picture p38: page 1]
