eSpark-Backup/patrizio-moi-pcb-fixes/Client-Files/17 - Summit EQP200B 30-JUL-2025/PDF/PCB Layout.pdf

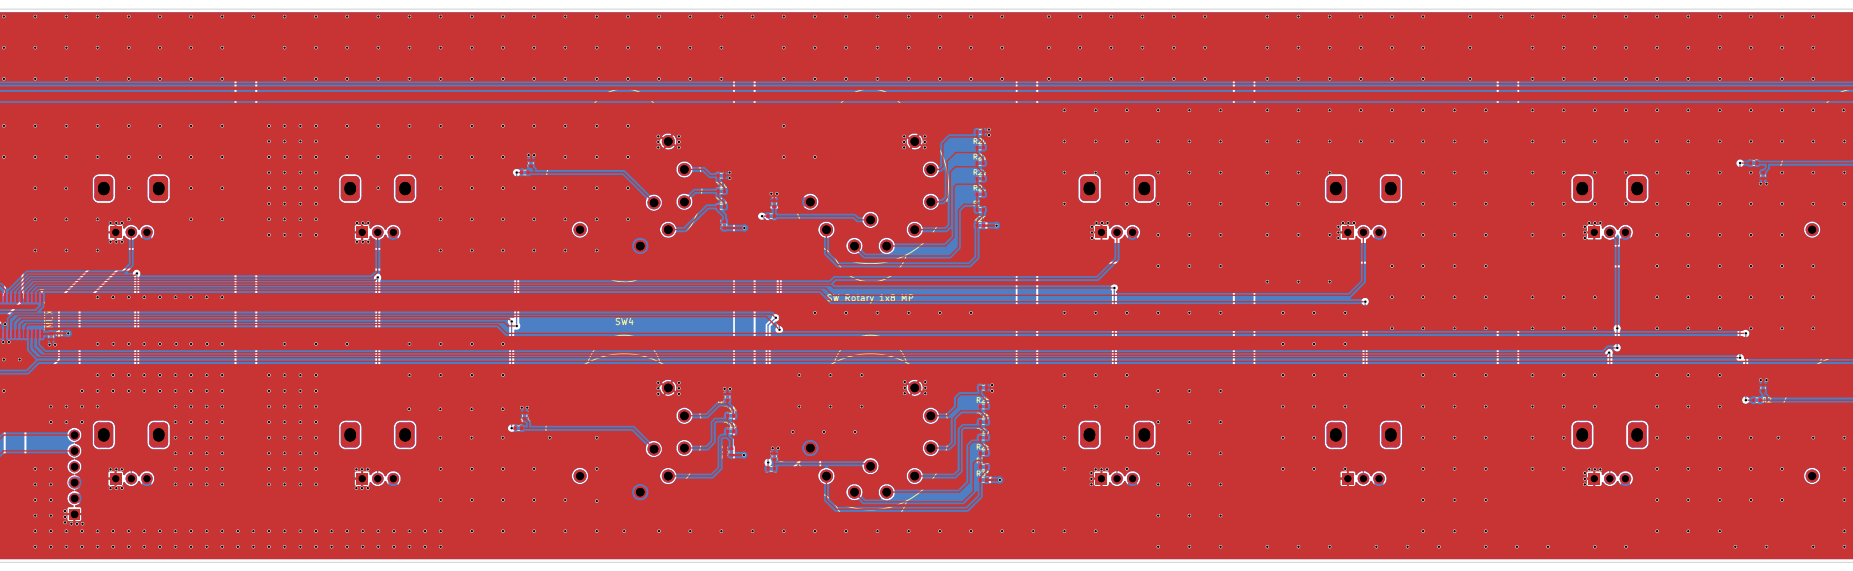
[picture p39: page 1]
