eSpark-Backup/patrizio-moi-pcb-fixes/Design_Files/24 - SSL EQ Rack - 6-June-2025/SSL-EQ-Rack.kicad_pcb

## KiCad design Design_Files/24 - SSL EQ Rack - 6-June-2025/SSL-EQ-Rack.kicad_pcb (2025-08-07)

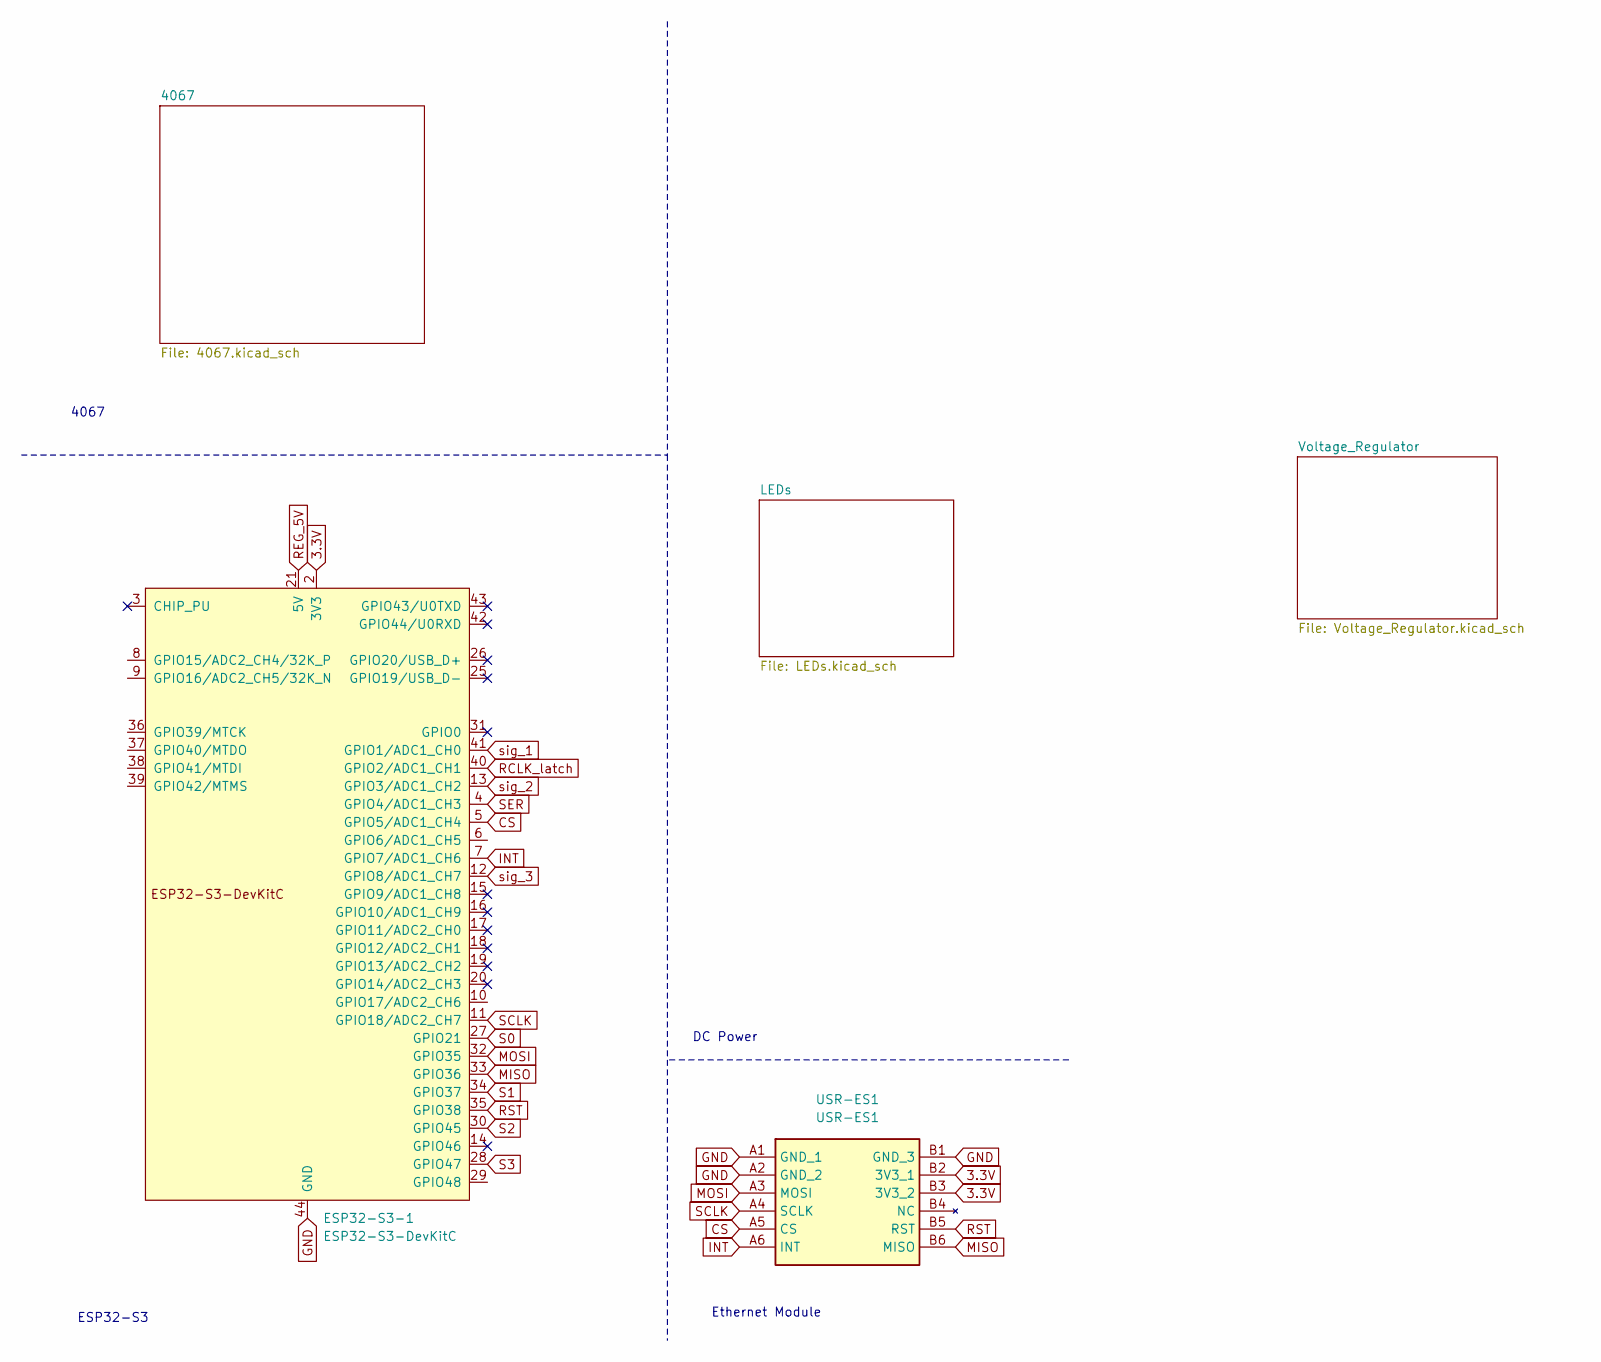
[picture p40: schematic SSL-EQ-Rack.kicad_sch]

Parts:
ESP32-S3-1: ESP32-S3-DevKitC; ESP32-S3-DEVKITC-1-N8R2-2
USR-ES1: USR-ES1; USRES1; Manufacturer_Part_Number USR-ES1

Connections:
3.3V: ESP32-S3-1.1 (3V3), ESP32-S3-1.2 (3V3), USR-ES1.B2 (3V3_1), USR-ES1.B3 (3V3_2); also elsewhere on the board
CS: ESP32-S3-1.5 (GPIO5/ADC1_CH4), USR-ES1.A5 (CS)
GND: ESP32-S3-1.22 (GND), ESP32-S3-1.23 (GND), ESP32-S3-1.24 (GND), ESP32-S3-1.44 (GND), USR-ES1.A1 (GND_1), USR-ES1.A2 (GND_2), USR-ES1.B1 (GND_3); also elsewhere on the board
INT: ESP32-S3-1.7 (GPIO7/ADC1_CH6), USR-ES1.A6 (INT)
MISO: ESP32-S3-1.33 (GPIO36), USR-ES1.B6 (MISO)
MOSI: ESP32-S3-1.32 (GPIO35), USR-ES1.A3 (MOSI)
RCLK_latch: ESP32-S3-1.40 (GPIO2/ADC1_CH1); also elsewhere on the board
REG_5V: ESP32-S3-1.21 (5V); also elsewhere on the board
RST: ESP32-S3-1.35 (GPIO38), USR-ES1.B5 (RST)
S0: ESP32-S3-1.27 (GPIO21); also elsewhere on the board
S1: ESP32-S3-1.34 (GPIO37); also elsewhere on the board
S2: ESP32-S3-1.30 (GPIO45); also elsewhere on the board
S3: ESP32-S3-1.28 (GPIO47); also elsewhere on the board
SCLK: ESP32-S3-1.11 (GPIO18/ADC2_CH7), USR-ES1.A4 (SCLK); also elsewhere on the board
SER: ESP32-S3-1.4 (GPIO4/ADC1_CH3); also elsewhere on the board
sig_1: ESP32-S3-1.41 (GPIO1/ADC1_CH0); also elsewhere on the board
sig_2: ESP32-S3-1.13 (GPIO3/ADC1_CH2); also elsewhere on the board
sig_3: ESP32-S3-1.12 (GPIO8/ADC1_CH7); also elsewhere on the board

Notes on the sheet:
Ethernet Module
ESP32-S3
DC Power
4067

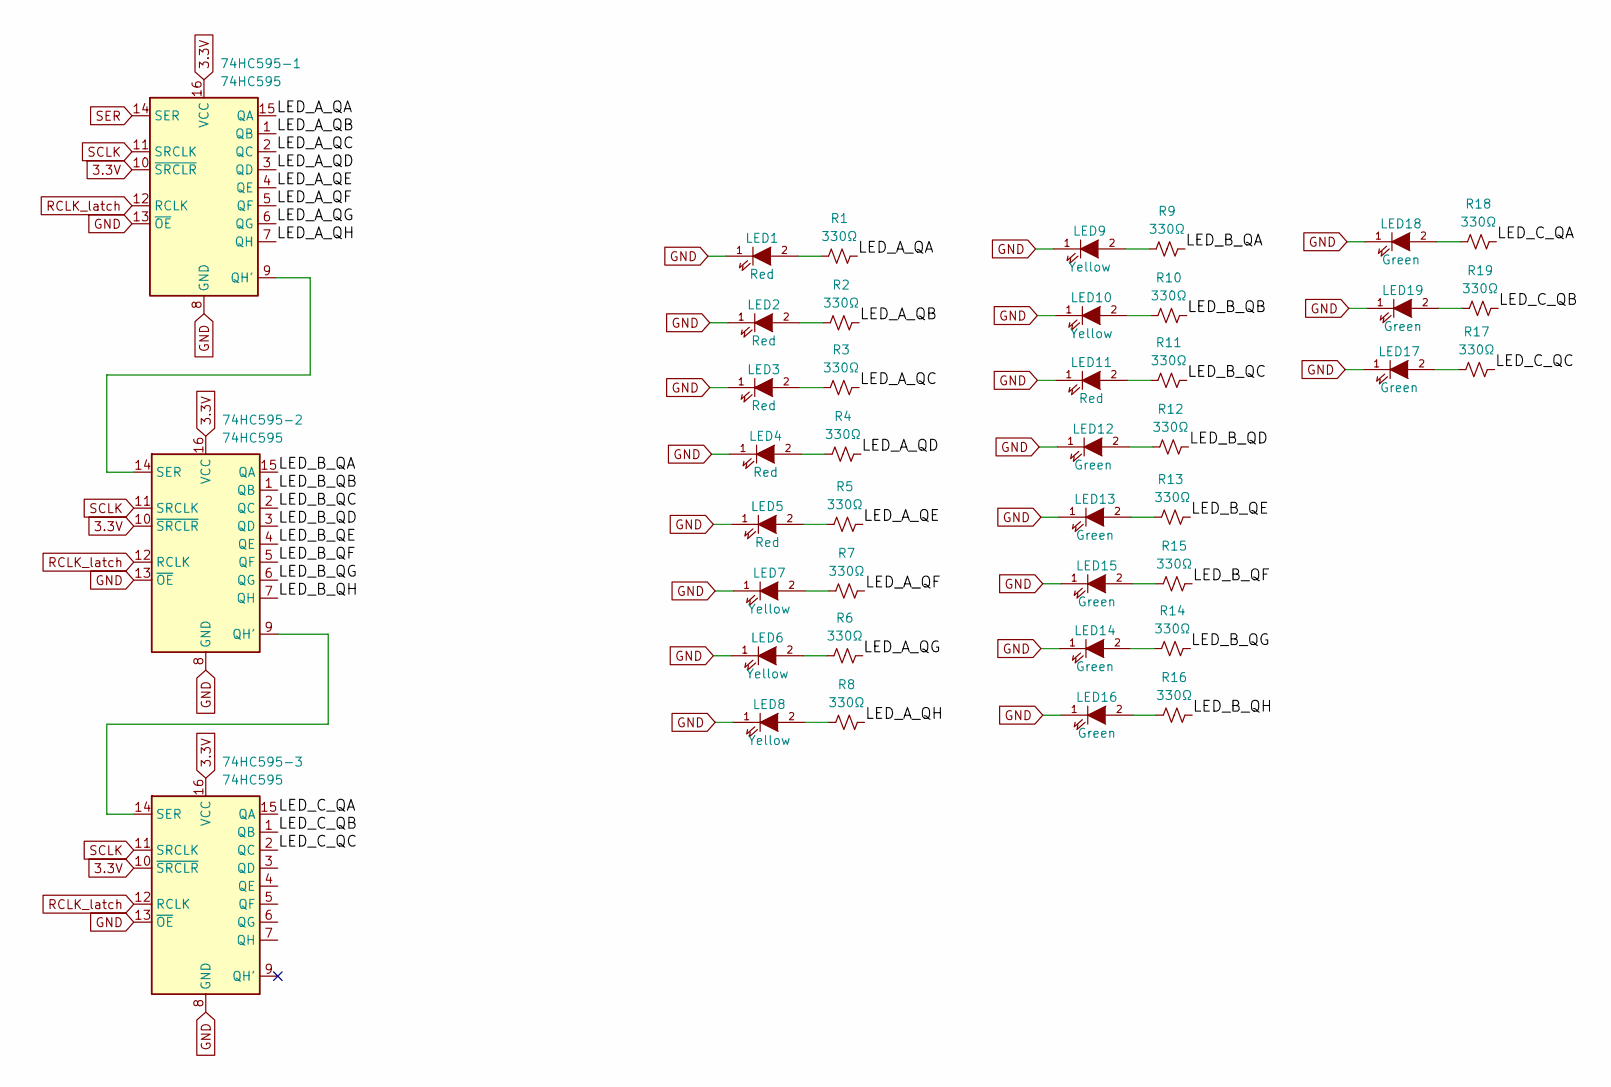
[picture p41: schematic LEDs.kicad_sch]

Parts:
74HC595-1, 74HC595-2, 74HC595-3: 74HC595; SOIC-16_3.9x9.9mm_P1.27mm; LCSC Part Number C5947
LED1, LED2, LED3, LED4, LED5, LED11: Red; LED_D3.0mm_Clear-2
LED6, LED7, LED8, LED9, LED10: Yellow; LED_D3.0mm_Clear-2
LED12, LED13, LED14, LED15, LED16, LED17, LED18, LED19: Green; LED_D3.0mm_Clear-2
R1, R2, R3, R4, R5, R6, R7, R8, R9, R10, R11, R12, R13, R14, R15, R16, R17, R18, R19: 330Ω; R_0402_1005Metric; LCSC Part Number C25104

Connections:
3.3V: 74HC595-1.10 (~SRCLR), 74HC595-1.16 (VCC), 74HC595-2.10 (~SRCLR), 74HC595-2.16 (VCC), 74HC595-3.10 (~SRCLR), 74HC595-3.16 (VCC); also elsewhere on the board
/LEDs/LED_A_QA: 74HC595-1.15 (QA), R1.2
/LEDs/LED_A_QB: 74HC595-1.1 (QB), R2.2
/LEDs/LED_A_QC: 74HC595-1.2 (QC), R3.2
/LEDs/LED_A_QD: 74HC595-1.3 (QD), R4.2
/LEDs/LED_A_QE: 74HC595-1.4 (QE), R5.2
/LEDs/LED_A_QF: 74HC595-1.5 (QF), R7.2
/LEDs/LED_A_QG: 74HC595-1.6 (QG), R6.2
/LEDs/LED_A_QH: 74HC595-1.7 (QH), R8.2
/LEDs/LED_B_QA: 74HC595-2.15 (QA), R9.2
/LEDs/LED_B_QB: 74HC595-2.1 (QB), R10.2
/LEDs/LED_B_QC: 74HC595-2.2 (QC), R11.2
/LEDs/LED_B_QD: 74HC595-2.3 (QD), R12.2
/LEDs/LED_B_QE: 74HC595-2.4 (QE), R13.2
/LEDs/LED_B_QF: 74HC595-2.5 (QF), R15.2
/LEDs/LED_B_QG: 74HC595-2.6 (QG), R14.2
/LEDs/LED_B_QH: 74HC595-2.7 (QH), R16.2
/LEDs/LED_C_QA: 74HC595-3.15 (QA), R18.2
/LEDs/LED_C_QB: 74HC595-3.1 (QB), R19.2
/LEDs/LED_C_QC: 74HC595-3.2 (QC), R17.2
GND: 74HC595-1.8 (GND), 74HC595-1.13 (~OE), 74HC595-2.8 (GND), 74HC595-2.13 (~OE), 74HC595-3.8 (GND), 74HC595-3.13 (~OE), LED1.1 (K), LED2.1 (K), LED3.1 (K), LED4.1 (K), LED5.1 (K), LED6.1 (K), LED7.1 (K), LED8.1 (K), LED9.1 (K), LED10.1 (K), LED11.1 (K), LED12.1 (K), LED13.1 (K), LED14.1 (K), LED15.1 (K), LED16.1 (K), LED17.1 (K), LED18.1 (K), LED19.1 (K); also elsewhere on the board
unnamed: 74HC595-1.9 (QH'), 74HC595-2.14 (SER)
unnamed: 74HC595-2.9 (QH'), 74HC595-3.14 (SER)
unnamed: LED1.2 (A), R1.1
unnamed: LED2.2 (A), R2.1
unnamed: LED3.2 (A), R3.1
unnamed: LED4.2 (A), R4.1
unnamed: LED5.2 (A), R5.1
unnamed: LED6.2 (A), R6.1
unnamed: LED7.2 (A), R7.1
unnamed: LED8.2 (A), R8.1
unnamed: LED9.2 (A), R9.1
unnamed: LED10.2 (A), R10.1
unnamed: LED11.2 (A), R11.1
unnamed: LED12.2 (A), R12.1
unnamed: LED13.2 (A), R13.1
unnamed: LED14.2 (A), R14.1
unnamed: LED15.2 (A), R15.1
unnamed: LED16.2 (A), R16.1
unnamed: LED17.2 (A), R17.1
unnamed: LED18.2 (A), R18.1
unnamed: LED19.2 (A), R19.1
RCLK_latch: 74HC595-1.12 (RCLK), 74HC595-2.12 (RCLK), 74HC595-3.12 (RCLK); also elsewhere on the board
SCLK: 74HC595-1.11 (SRCLK), 74HC595-2.11 (SRCLK), 74HC595-3.11 (SRCLK); also elsewhere on the board
SER: 74HC595-1.14 (SER); also elsewhere on the board

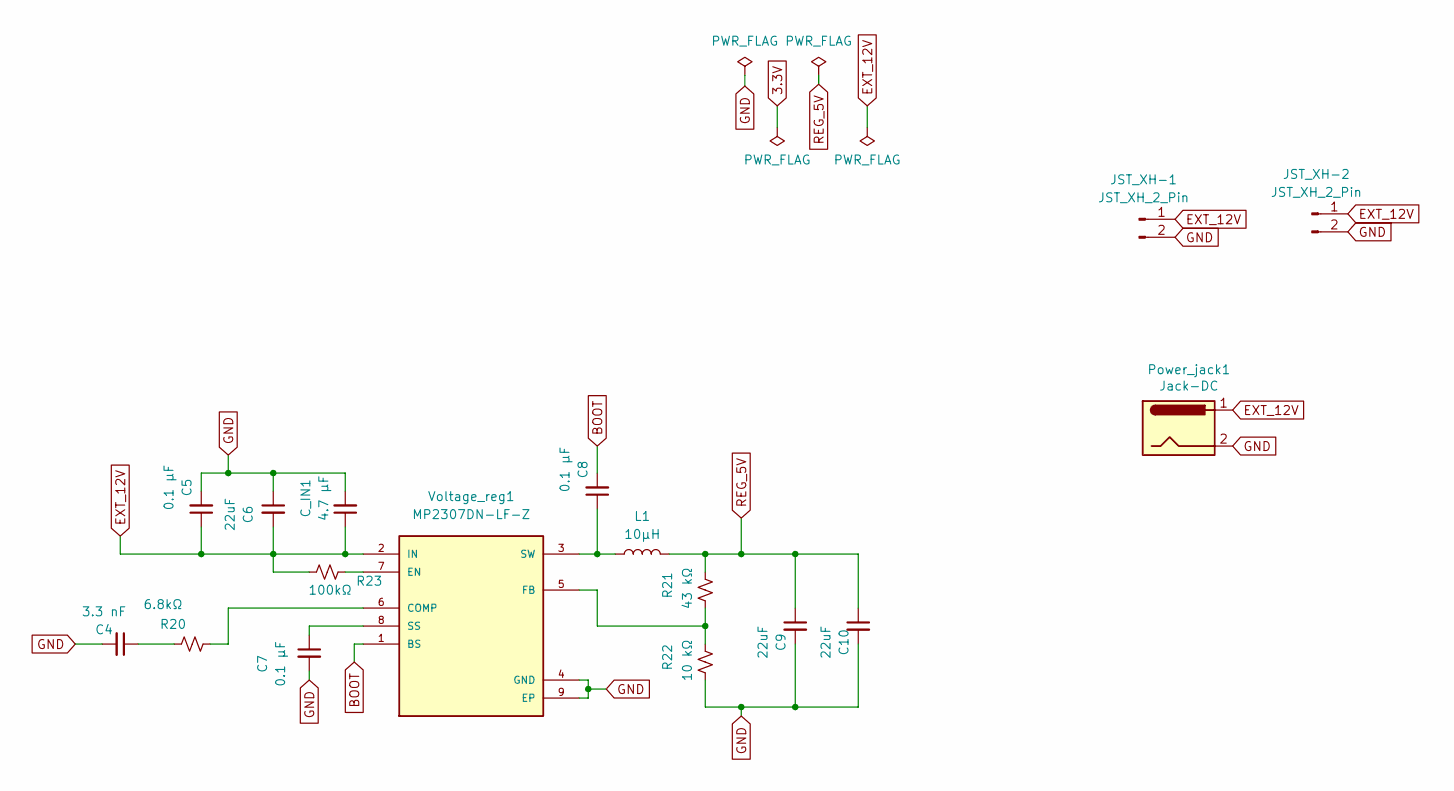
[picture p42: schematic Voltage_Regulator.kicad_sch]

Parts:
C4: 3.3 nF; C_0603_1608Metric; LCSC Part Number C1613
C5, C7, C8: 0.1 µF; C_0402_1005Metric; LCSC Part Number C1525
C6, C9, C10: 22uF; C_0603_1608Metric; LCSC Part Number C59461
C_IN1: 4.7 µF; C_0402_1005Metric; LCSC Part Number C23733
JST_XH-1, JST_XH-2: JST_XH_2_Pin; JST_XH_B2B-XH-A_1x02_P2.50mm_Vertical
L1: 10µH; L_Bourns-SRN8040_8x8.15mm; LCSC Part Number C37429
Power_jack1: Jack-DC; BarrelJack_Horizontal
R20: 6.8kΩ; R_0603_1608Metric; LCSC Part Number C23212
R21: 43 kΩ; R_0402_1005Metric; LCSC Part Number C2906943
R22: 10 kΩ; R_0402_1005Metric; LCSC Part Number C25744
R23: 100kΩ; R_0603_1608Metric; LCSC Part Number C23212
Voltage_reg1: MP2307DN-LF-Z; SOIC-8-1EP_3.9x4.9mm_P1.27mm_EP2.29x3mm_ThermalVias; PARTREV 1.9; LCSC Part Number C2928813

Connections:
BOOT: C8.2, Voltage_reg1.1 (BS)
EXT_12V: C5.1, C6.2, C_IN1.1, JST_XH-1.1, JST_XH-2.1, Power_jack1.1, R23.1, Voltage_reg1.2 (IN)
GND: C4.2, C5.2, C6.1, C7.2, C9.2, C10.2, C_IN1.2, JST_XH-1.2, JST_XH-2.2, Power_jack1.2, R22.2, Voltage_reg1.4 (GND), Voltage_reg1.9 (EP); also elsewhere on the board
unnamed: C4.1, R20.1
unnamed: R20.2, Voltage_reg1.6 (COMP)
unnamed: R23.2, Voltage_reg1.7 (EN)
unnamed: R21.2, R22.1, Voltage_reg1.5 (FB)
unnamed: C7.1, Voltage_reg1.8 (SS)
unnamed: C8.1, L1.1, Voltage_reg1.3 (SW)
REG_5V: C9.1, C10.1, L1.2, R21.1; also elsewhere on the board

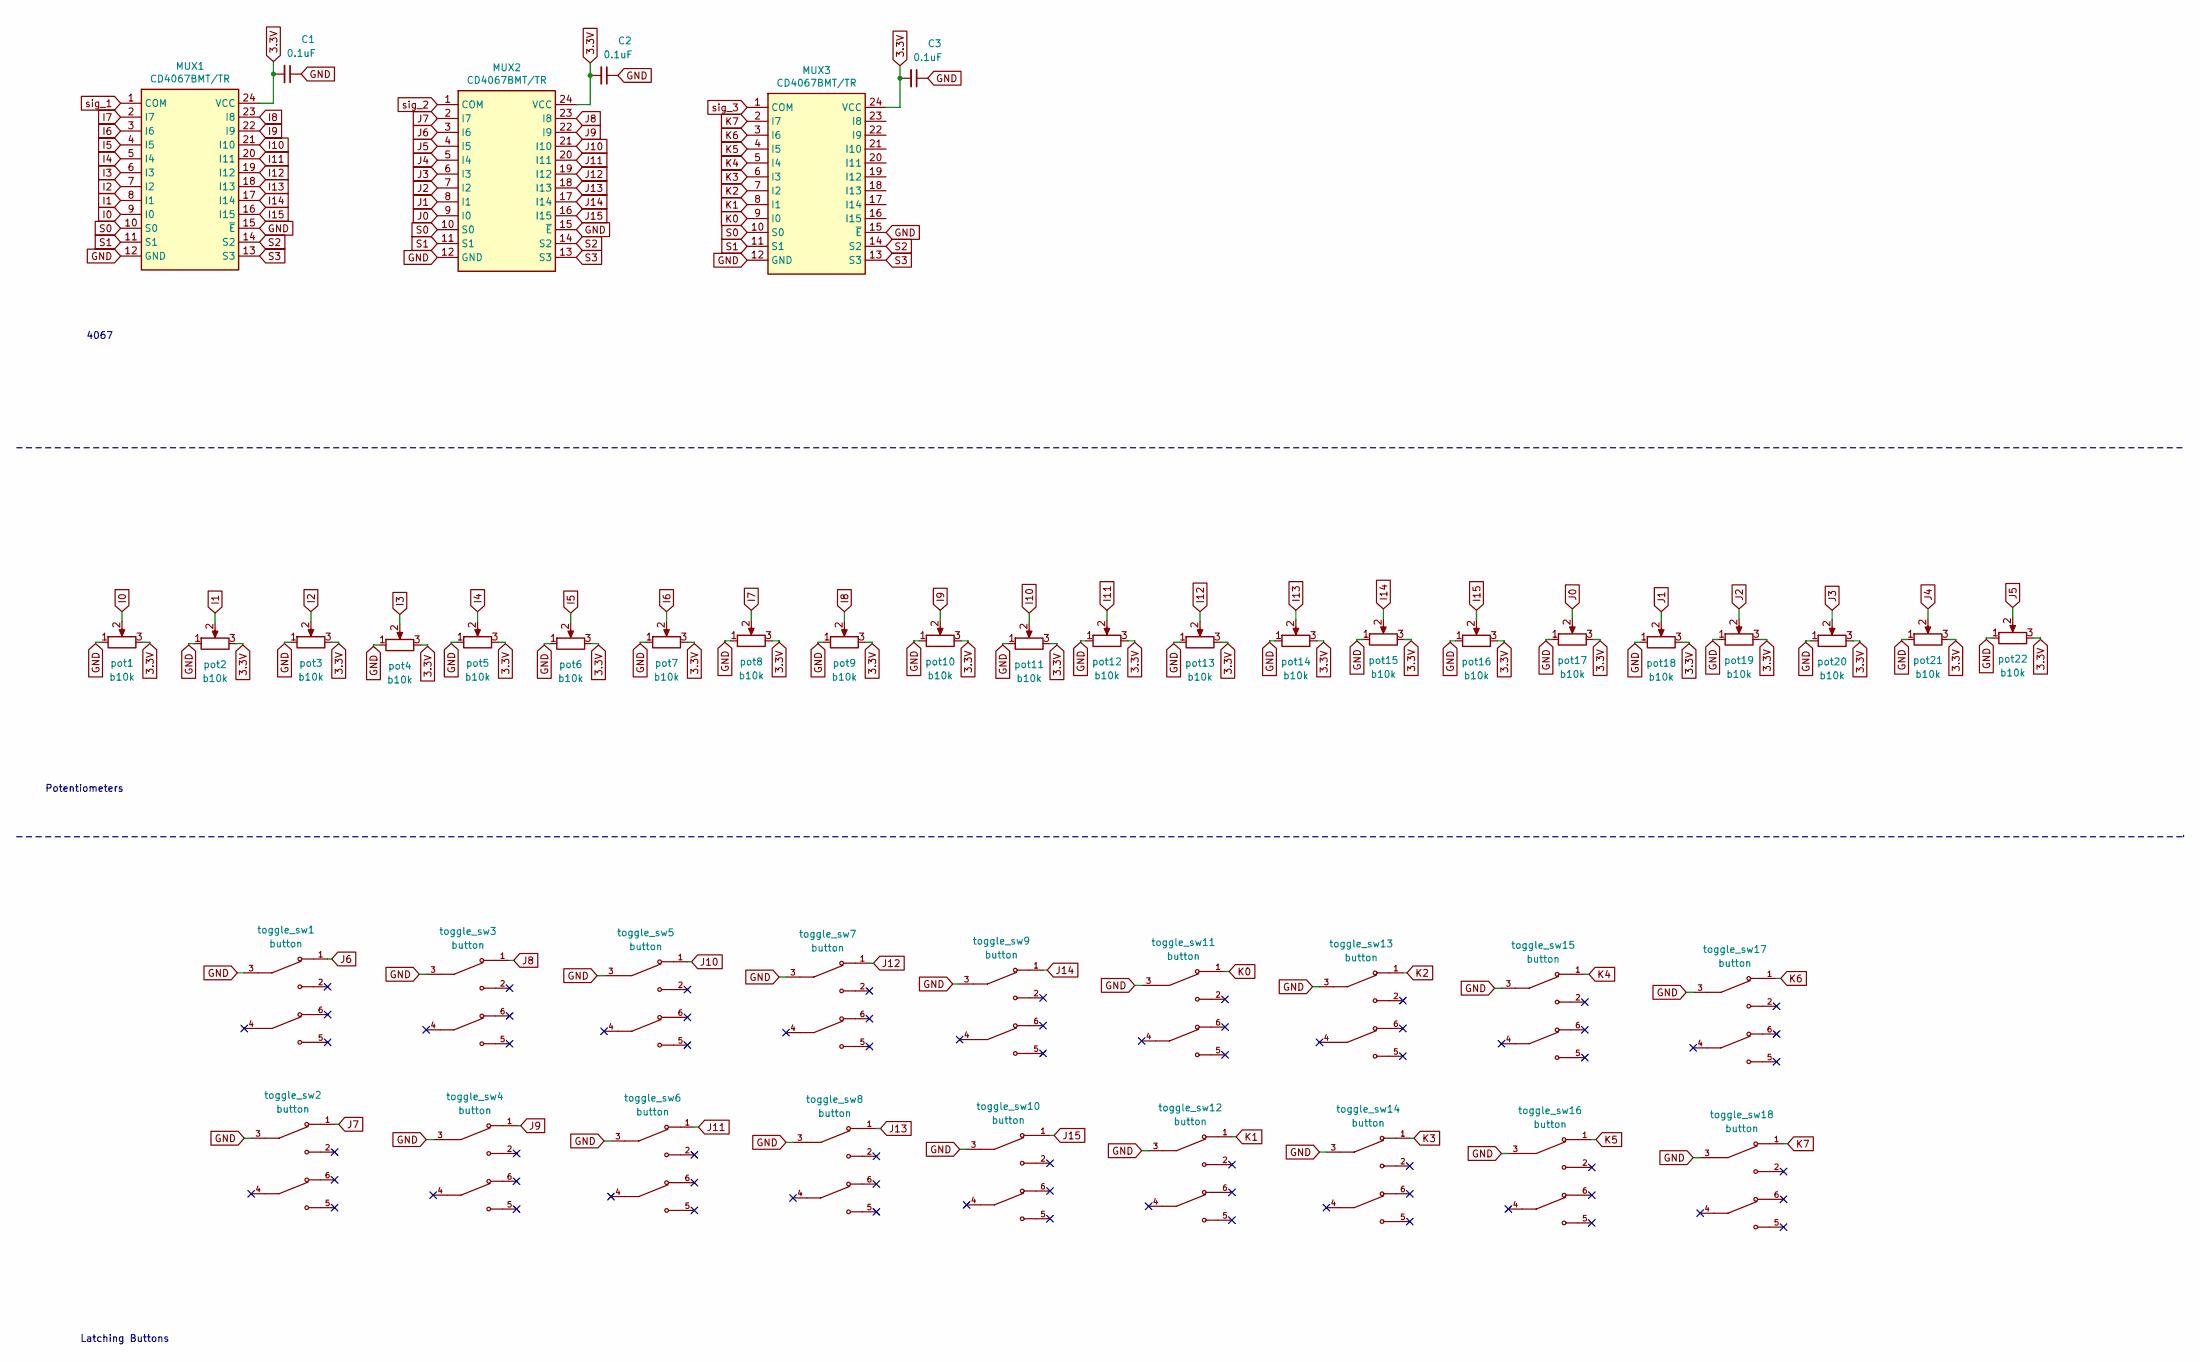
[picture p43: schematic 4067.kicad_sch]

Parts:
C1, C2, C3: 0.1uF; C_0402_1005Metric; LCSC Part Number C1525
MUX1, MUX2, MUX3: CD4067BMT/TR; TSSOP-24_4.4x7.8mm_P0.65mm; LCSC Part Number C7432333
pot1, pot2, pot3, pot4, pot5, pot6, pot7, pot8, pot9, pot10, pot11, pot12, pot13, pot14, pot15, pot16, pot17, pot18, pot19, pot20, pot21, pot22: b10k; Potentiometer_Alps_RK09K_Single_Vertical
toggle_sw1, toggle_sw2, toggle_sw3, toggle_sw4, toggle_sw5, toggle_sw6, toggle_sw7, toggle_sw8, toggle_sw9, toggle_sw10, toggle_sw11, toggle_sw12, toggle_sw13, toggle_sw14, toggle_sw15, toggle_sw16, toggle_sw17, toggle_sw18: button; SW_TL2285EE; PARTREV B

Connections:
3.3V: C1.2, C2.2, C3.2, MUX1.24 (VCC), MUX2.24 (VCC), MUX3.24 (VCC), pot1.3, pot2.3, pot3.3, pot4.3, pot5.3, pot6.3, pot7.3, pot8.3, pot9.3, pot10.3, pot11.3, pot12.3, pot13.3, pot14.3, pot15.3, pot16.3, pot17.3, pot18.3, pot19.3, pot20.3, pot21.3, pot22.3; also elsewhere on the board
GND: C1.1, C2.1, C3.1, MUX1.12 (GND), MUX1.15 (~E), MUX2.12 (GND), MUX2.15 (~E), MUX3.12 (GND), MUX3.15 (~E), pot1.1, pot2.1, pot3.1, pot4.1, pot5.1, pot6.1, pot7.1, pot8.1, pot9.1, pot10.1, pot11.1, pot12.1, pot13.1, pot14.1, pot15.1, pot16.1, pot17.1, pot18.1, pot19.1, pot20.1, pot21.1, pot22.1, toggle_sw1.3, toggle_sw2.3, toggle_sw3.3, toggle_sw4.3, toggle_sw5.3, toggle_sw6.3, toggle_sw7.3, toggle_sw8.3, toggle_sw9.3, toggle_sw10.3, toggle_sw11.3, toggle_sw12.3, toggle_sw13.3, toggle_sw14.3, toggle_sw15.3, toggle_sw16.3, toggle_sw17.3, toggle_sw18.3; also elsewhere on the board
I0: MUX1.9 (I0), pot1.2
I1: MUX1.8 (I1), pot2.2
I2: MUX1.7 (I2), pot3.2
I3: MUX1.6 (I3), pot4.2
I4: MUX1.5 (I4), pot5.2
I5: MUX1.4 (I5), pot6.2
I6: MUX1.3 (I6), pot7.2
I7: MUX1.2 (I7), pot8.2
I8: MUX1.23 (I8), pot9.2
I9: MUX1.22 (I9), pot10.2
I10: MUX1.21 (I10), pot11.2
I11: MUX1.20 (I11), pot12.2
I12: MUX1.19 (I12), pot13.2
I13: MUX1.18 (I13), pot14.2
I14: MUX1.17 (I14), pot15.2
I15: MUX1.16 (I15), pot16.2
J0: MUX2.9 (I0), pot17.2
J1: MUX2.8 (I1), pot18.2
J2: MUX2.7 (I2), pot19.2
J3: MUX2.6 (I3), pot20.2
J4: MUX2.5 (I4), pot21.2
J5: MUX2.4 (I5), pot22.2
J6: MUX2.3 (I6), toggle_sw1.1
J7: MUX2.2 (I7), toggle_sw2.1
J8: MUX2.23 (I8), toggle_sw3.1
J9: MUX2.22 (I9), toggle_sw4.1
J10: MUX2.21 (I10), toggle_sw5.1
J11: MUX2.20 (I11), toggle_sw6.1
J12: MUX2.19 (I12), toggle_sw7.1
J13: MUX2.18 (I13), toggle_sw8.1
J14: MUX2.17 (I14), toggle_sw9.1
J15: MUX2.16 (I15), toggle_sw10.1
K0: MUX3.9 (I0), toggle_sw11.1
K1: MUX3.8 (I1), toggle_sw12.1
K2: MUX3.7 (I2), toggle_sw13.1
K3: MUX3.6 (I3), toggle_sw14.1
K4: MUX3.5 (I4), toggle_sw15.1
K5: MUX3.4 (I5), toggle_sw16.1
K6: MUX3.3 (I6), toggle_sw17.1
K7: MUX3.2 (I7), toggle_sw18.1
S0: MUX1.10 (S0), MUX2.10 (S0), MUX3.10 (S0); also elsewhere on the board
S1: MUX1.11 (S1), MUX2.11 (S1), MUX3.11 (S1); also elsewhere on the board
S2: MUX1.14 (S2), MUX2.14 (S2), MUX3.14 (S2); also elsewhere on the board
S3: MUX1.13 (S3), MUX2.13 (S3), MUX3.13 (S3); also elsewhere on the board
sig_1: MUX1.1 (COM); also elsewhere on the board
sig_2: MUX2.1 (COM); also elsewhere on the board
sig_3: MUX3.1 (COM); also elsewhere on the board

Notes on the sheet:
Latching Buttons
Potentiometers
4067

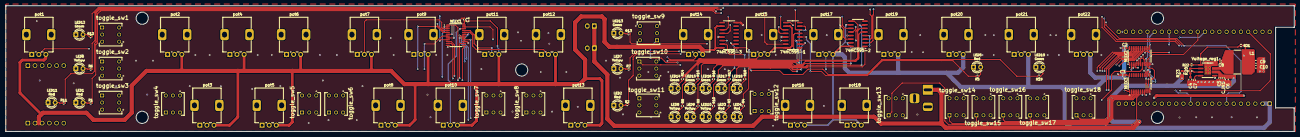
[picture p44: board SSL-EQ-Rack.kicad_pcb from above]

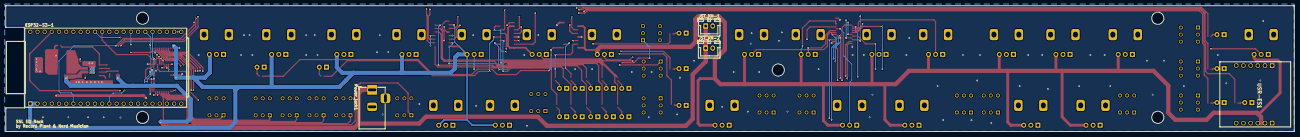
[picture p45: board SSL-EQ-Rack.kicad_pcb from below]

Board: 4 copper layers, 455.1 x 44.4 mm, 106 parts (5 on the bottom side), 106 nets.
