eSpark-Backup/patrizio-moi-pcb-fixes/Design_Files/14 - Drawmer DS-201 - 7-June-2025/Drawmer-DS-201.kicad_pcb

## KiCad design Design_Files/14 - Drawmer DS-201 - 7-June-2025/Drawmer-DS-201.kicad_pcb (2025-08-06)

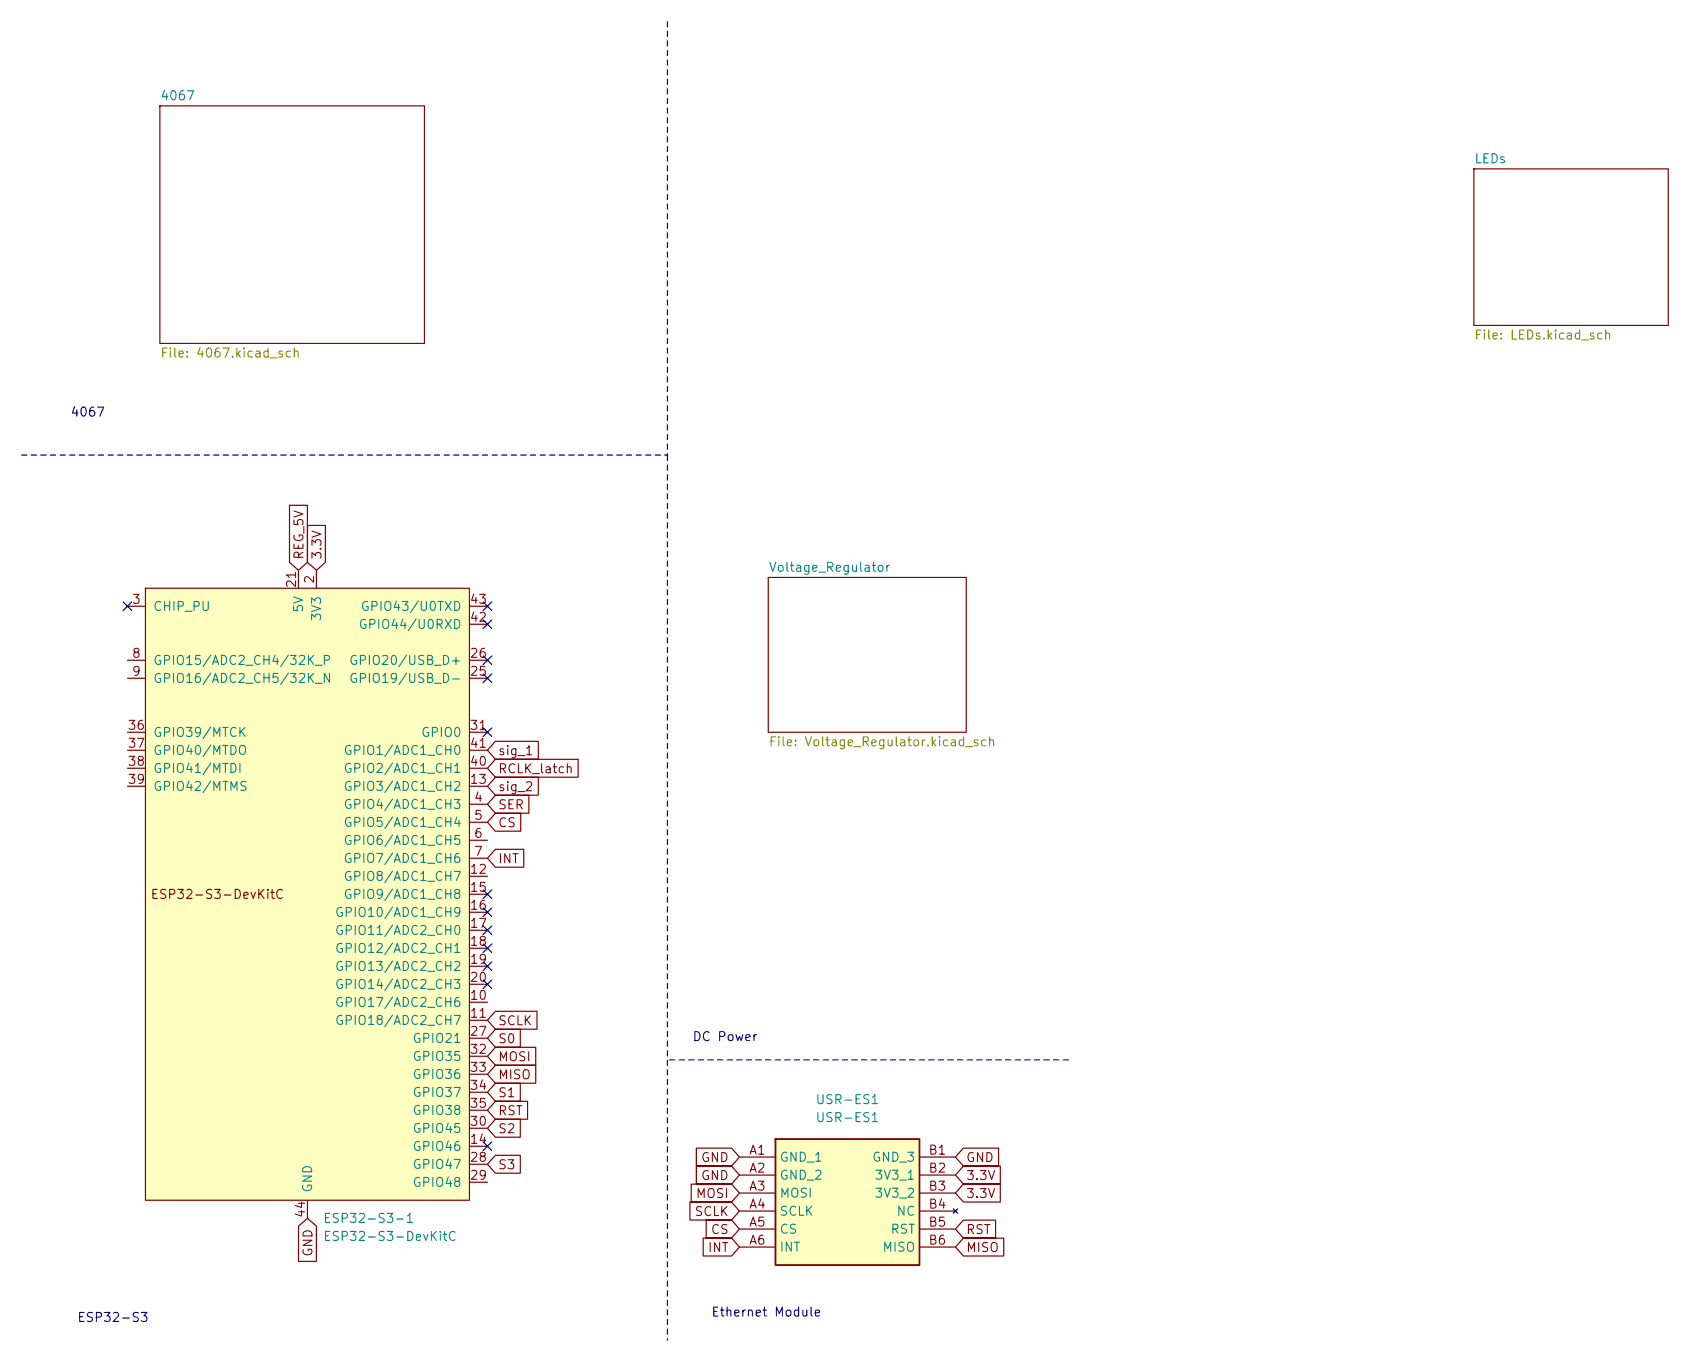
[picture p46: schematic Drawmer-DS-201.kicad_sch]

Parts:
ESP32-S3-1: ESP32-S3-DevKitC; ESP32-S3-DEVKITC-1-N8R2-2
USR-ES1: USR-ES1; USRES1; Manufacturer_Part_Number USR-ES1

Connections:
3.3V: ESP32-S3-1.1 (3V3), ESP32-S3-1.2 (3V3), USR-ES1.B2 (3V3_1), USR-ES1.B3 (3V3_2); also elsewhere on the board
CS: ESP32-S3-1.5 (GPIO5/ADC1_CH4), USR-ES1.A5 (CS)
GND: ESP32-S3-1.22 (GND), ESP32-S3-1.23 (GND), ESP32-S3-1.24 (GND), ESP32-S3-1.44 (GND), USR-ES1.A1 (GND_1), USR-ES1.A2 (GND_2), USR-ES1.B1 (GND_3); also elsewhere on the board
INT: ESP32-S3-1.7 (GPIO7/ADC1_CH6), USR-ES1.A6 (INT)
MISO: ESP32-S3-1.33 (GPIO36), USR-ES1.B6 (MISO)
MOSI: ESP32-S3-1.32 (GPIO35), USR-ES1.A3 (MOSI)
RCLK_latch: ESP32-S3-1.40 (GPIO2/ADC1_CH1); also elsewhere on the board
REG_5V: ESP32-S3-1.21 (5V); also elsewhere on the board
RST: ESP32-S3-1.35 (GPIO38), USR-ES1.B5 (RST)
S0: ESP32-S3-1.27 (GPIO21); also elsewhere on the board
S1: ESP32-S3-1.34 (GPIO37); also elsewhere on the board
S2: ESP32-S3-1.30 (GPIO45); also elsewhere on the board
S3: ESP32-S3-1.28 (GPIO47); also elsewhere on the board
SCLK: ESP32-S3-1.11 (GPIO18/ADC2_CH7), USR-ES1.A4 (SCLK); also elsewhere on the board
SER: ESP32-S3-1.4 (GPIO4/ADC1_CH3); also elsewhere on the board
sig_1: ESP32-S3-1.41 (GPIO1/ADC1_CH0); also elsewhere on the board
sig_2: ESP32-S3-1.13 (GPIO3/ADC1_CH2); also elsewhere on the board

Notes on the sheet:
Ethernet Module
ESP32-S3
DC Power
4067

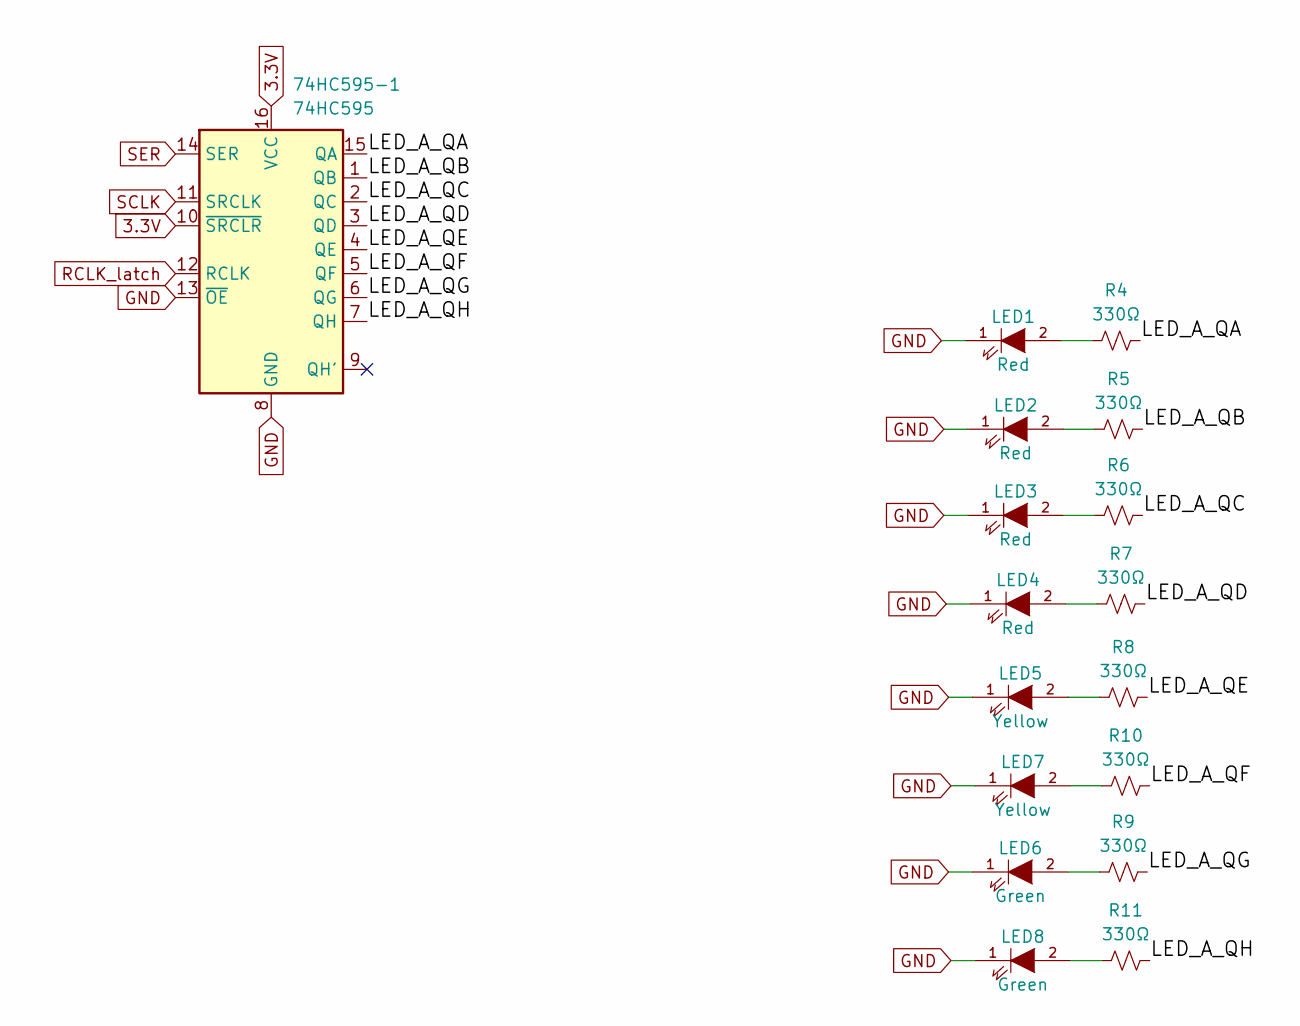
[picture p47: schematic LEDs.kicad_sch]

Parts:
74HC595-1: 74HC595; SOIC-16_3.9x9.9mm_P1.27mm; LCSC Part Number C5947
LED1, LED2, LED3, LED4: Red; LED_D3.0mm_Clear-2
LED5, LED7: Yellow; LED_D3.0mm_Clear-2
LED6, LED8: Green; LED_D3.0mm_Clear-2
R4, R5, R6, R7, R8, R9, R10, R11: 330Ω; R_0402_1005Metric; LCSC Part Number C25104

Connections:
3.3V: 74HC595-1.10 (~SRCLR), 74HC595-1.16 (VCC); also elsewhere on the board
/LEDs/LED_A_QA: 74HC595-1.15 (QA), R4.2
/LEDs/LED_A_QB: 74HC595-1.1 (QB), R5.2
/LEDs/LED_A_QC: 74HC595-1.2 (QC), R6.2
/LEDs/LED_A_QD: 74HC595-1.3 (QD), R7.2
/LEDs/LED_A_QE: 74HC595-1.4 (QE), R8.2
/LEDs/LED_A_QF: 74HC595-1.5 (QF), R10.2
/LEDs/LED_A_QG: 74HC595-1.6 (QG), R9.2
/LEDs/LED_A_QH: 74HC595-1.7 (QH), R11.2
GND: 74HC595-1.8 (GND), 74HC595-1.13 (~OE), LED1.1 (K), LED2.1 (K), LED3.1 (K), LED4.1 (K), LED5.1 (K), LED6.1 (K), LED7.1 (K), LED8.1 (K); also elsewhere on the board
unnamed: LED1.2 (A), R4.1
unnamed: LED2.2 (A), R5.1
unnamed: LED3.2 (A), R6.1
unnamed: LED4.2 (A), R7.1
unnamed: LED5.2 (A), R8.1
unnamed: LED6.2 (A), R9.1
unnamed: LED7.2 (A), R10.1
unnamed: LED8.2 (A), R11.1
RCLK_latch: 74HC595-1.12 (RCLK); also elsewhere on the board
SCLK: 74HC595-1.11 (SRCLK); also elsewhere on the board
SER: 74HC595-1.14 (SER); also elsewhere on the board
