eSpark-Backup/patrizio-moi-pcb-fixes/Design_Files/14 - Drawmer DS-201 - 7-June-2025/Drawmer-DS-201.kicad_pcb

## KiCad design Design_Files/14 - Drawmer DS-201 - 7-June-2025/Drawmer-DS-201.kicad_pcb (continued)

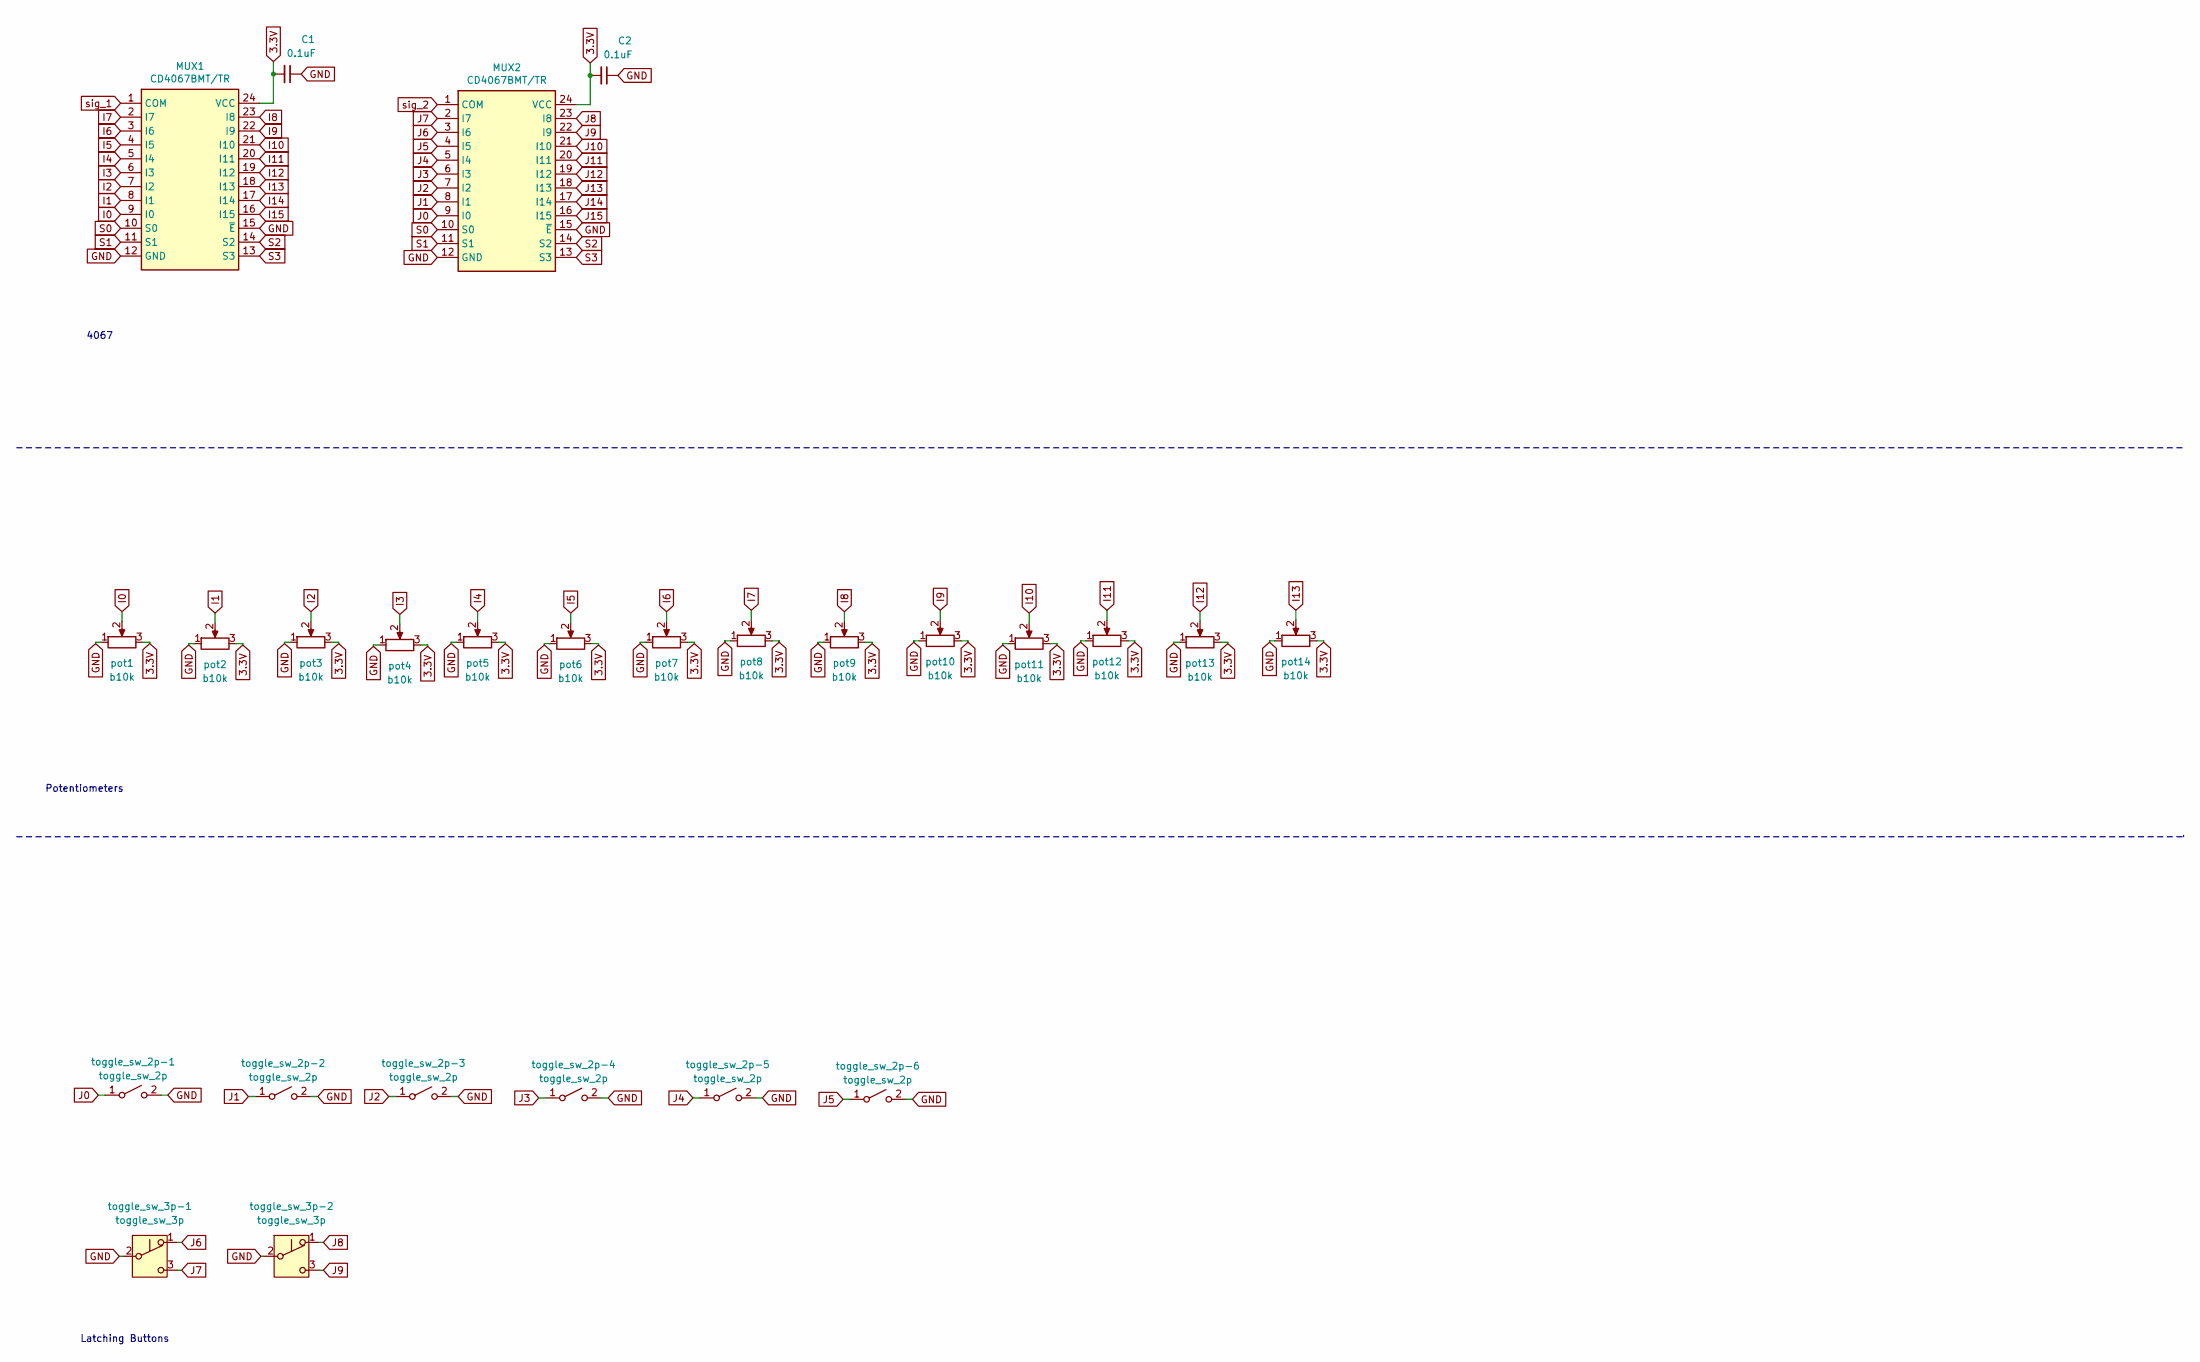
[picture p48: schematic 4067.kicad_sch]

Parts:
C1, C2: 0.1uF; C_0402_1005Metric; LCSC Part Number C1525
MUX1, MUX2: CD4067BMT/TR; TSSOP-24_4.4x7.8mm_P0.65mm; LCSC Part Number C7432333
pot1, pot2, pot3, pot4, pot5, pot6, pot7, pot8, pot9, pot10, pot11, pot12, pot13, pot14: b10k; Potentiometer_Alps_RK09K_Single_Vertical
toggle_sw_2p-1, toggle_sw_2p-2, toggle_sw_2p-3, toggle_sw_2p-4, toggle_sw_2p-5, toggle_sw_2p-6: toggle_sw_2p; Toggle_Switch-2-pins
toggle_sw_3p-1, toggle_sw_3p-2: toggle_sw_3p; Toggle_Switch-3-pins

Connections:
3.3V: C1.2, C2.2, MUX1.24 (VCC), MUX2.24 (VCC), pot1.3, pot2.3, pot3.3, pot4.3, pot5.3, pot6.3, pot7.3, pot8.3, pot9.3, pot10.3, pot11.3, pot12.3, pot13.3, pot14.3; also elsewhere on the board
GND: C1.1, C2.1, MUX1.12 (GND), MUX1.15 (~E), MUX2.12 (GND), MUX2.15 (~E), pot1.1, pot2.1, pot3.1, pot4.1, pot5.1, pot6.1, pot7.1, pot8.1, pot9.1, pot10.1, pot11.1, pot12.1, pot13.1, pot14.1, toggle_sw_2p-1.2 (B), toggle_sw_2p-2.2 (B), toggle_sw_2p-3.2 (B), toggle_sw_2p-4.2 (B), toggle_sw_2p-5.2 (B), toggle_sw_2p-6.2 (B), toggle_sw_3p-1.2 (B), toggle_sw_3p-2.2 (B); also elsewhere on the board
I0: MUX1.9 (I0), pot1.2
I1: MUX1.8 (I1), pot2.2
I2: MUX1.7 (I2), pot3.2
I3: MUX1.6 (I3), pot4.2
I4: MUX1.5 (I4), pot5.2
I5: MUX1.4 (I5), pot6.2
I6: MUX1.3 (I6), pot7.2
I7: MUX1.2 (I7), pot8.2
I8: MUX1.23 (I8), pot9.2
I9: MUX1.22 (I9), pot10.2
I10: MUX1.21 (I10), pot11.2
I11: MUX1.20 (I11), pot12.2
I12: MUX1.19 (I12), pot13.2
I13: MUX1.18 (I13), pot14.2
I14: MUX1.17 (I14)
I15: MUX1.16 (I15)
J0: MUX2.9 (I0), toggle_sw_2p-1.1 (A)
J1: MUX2.8 (I1), toggle_sw_2p-2.1 (A)
J2: MUX2.7 (I2), toggle_sw_2p-3.1 (A)
J3: MUX2.6 (I3), toggle_sw_2p-4.1 (A)
J4: MUX2.5 (I4), toggle_sw_2p-5.1 (A)
J5: MUX2.4 (I5), toggle_sw_2p-6.1 (A)
J6: MUX2.3 (I6), toggle_sw_3p-1.1 (A)
J7: MUX2.2 (I7), toggle_sw_3p-1.3 (C)
J8: MUX2.23 (I8), toggle_sw_3p-2.1 (A)
J9: MUX2.22 (I9), toggle_sw_3p-2.3 (C)
J10: MUX2.21 (I10)
J11: MUX2.20 (I11)
J12: MUX2.19 (I12)
J13: MUX2.18 (I13)
J14: MUX2.17 (I14)
J15: MUX2.16 (I15)
S0: MUX1.10 (S0), MUX2.10 (S0); also elsewhere on the board
S1: MUX1.11 (S1), MUX2.11 (S1); also elsewhere on the board
S2: MUX1.14 (S2), MUX2.14 (S2); also elsewhere on the board
S3: MUX1.13 (S3), MUX2.13 (S3); also elsewhere on the board
sig_1: MUX1.1 (COM); also elsewhere on the board
sig_2: MUX2.1 (COM); also elsewhere on the board

Notes on the sheet:
Latching Buttons
Potentiometers
4067

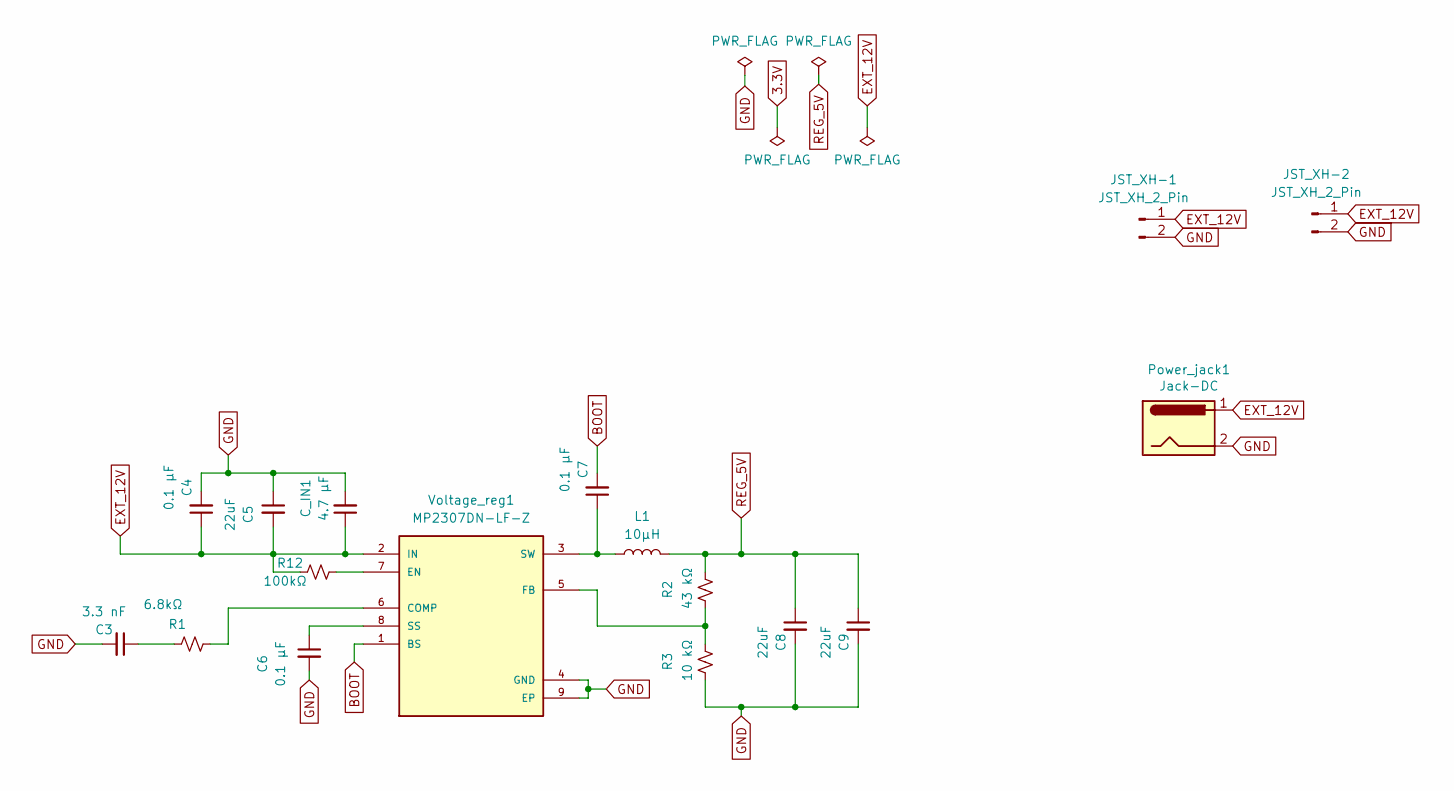
[picture p49: schematic Voltage_Regulator.kicad_sch]

Parts:
C3: 3.3 nF; C_0603_1608Metric; LCSC Part Number C1613
C4, C6, C7: 0.1 µF; C_0402_1005Metric; LCSC Part Number C1525
C5, C8, C9: 22uF; C_0603_1608Metric; LCSC Part Number C59461
C_IN1: 4.7 µF; C_0402_1005Metric; LCSC Part Number C23733
JST_XH-1, JST_XH-2: JST_XH_2_Pin; JST_XH_B2B-XH-A_1x02_P2.50mm_Vertical
L1: 10µH; L_Bourns-SRN8040_8x8.15mm; LCSC Part Number C37429
Power_jack1: Jack-DC; BarrelJack_Horizontal
R1: 6.8kΩ; R_0603_1608Metric; LCSC Part Number C23212
R2: 43 kΩ; R_0402_1005Metric; LCSC Part Number C2906943
R3: 10 kΩ; R_0402_1005Metric; LCSC Part Number C25744
R12: 100kΩ; R_0603_1608Metric; LCSC Part Number C23212
Voltage_reg1: MP2307DN-LF-Z; SOIC-8-1EP_3.9x4.9mm_P1.27mm_EP2.29x3mm_ThermalVias; PARTREV 1.9; LCSC Part Number C2928813

Connections:
BOOT: C7.2, Voltage_reg1.1 (BS)
EXT_12V: C4.1, C5.2, C_IN1.1, JST_XH-1.1, JST_XH-2.1, Power_jack1.1, R12.1, Voltage_reg1.2 (IN)
GND: C3.2, C4.2, C5.1, C6.2, C8.2, C9.2, C_IN1.2, JST_XH-1.2, JST_XH-2.2, Power_jack1.2, R3.2, Voltage_reg1.4 (GND), Voltage_reg1.9 (EP); also elsewhere on the board
unnamed: C3.1, R1.1
unnamed: R1.2, Voltage_reg1.6 (COMP)
unnamed: R12.2, Voltage_reg1.7 (EN)
unnamed: R2.2, R3.1, Voltage_reg1.5 (FB)
unnamed: C6.1, Voltage_reg1.8 (SS)
unnamed: C7.1, L1.1, Voltage_reg1.3 (SW)
REG_5V: C8.1, C9.1, L1.2, R2.1; also elsewhere on the board

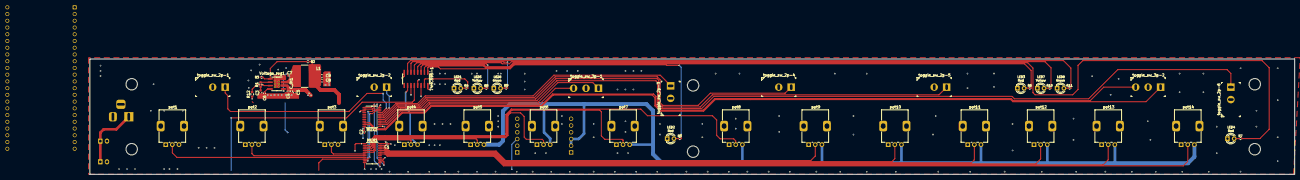
[picture p50: board Drawmer-DS-201.kicad_pcb from above]

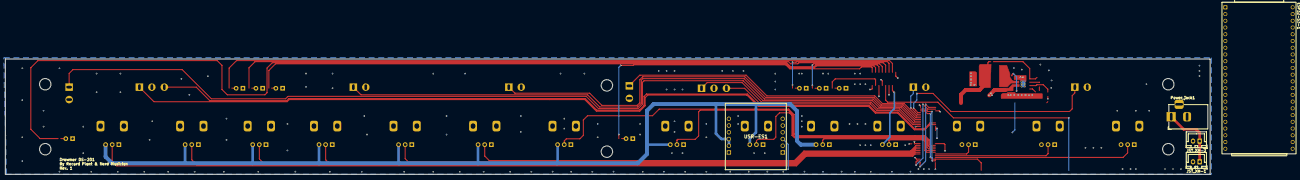
[picture p51: board Drawmer-DS-201.kicad_pcb from below]

Board: 4 copper layers, 454.4 x 43.5 mm, 62 parts (5 on the bottom side), 65 nets.
