eSpark-Backup/patrizio-moi-pcb-fixes/Design_Files/16 - Fairchild - 22-June-2025/Fairchild.kicad_pcb

## KiCad design Design_Files/16 - Fairchild - 22-June-2025/Fairchild.kicad_pcb (2025-08-06)

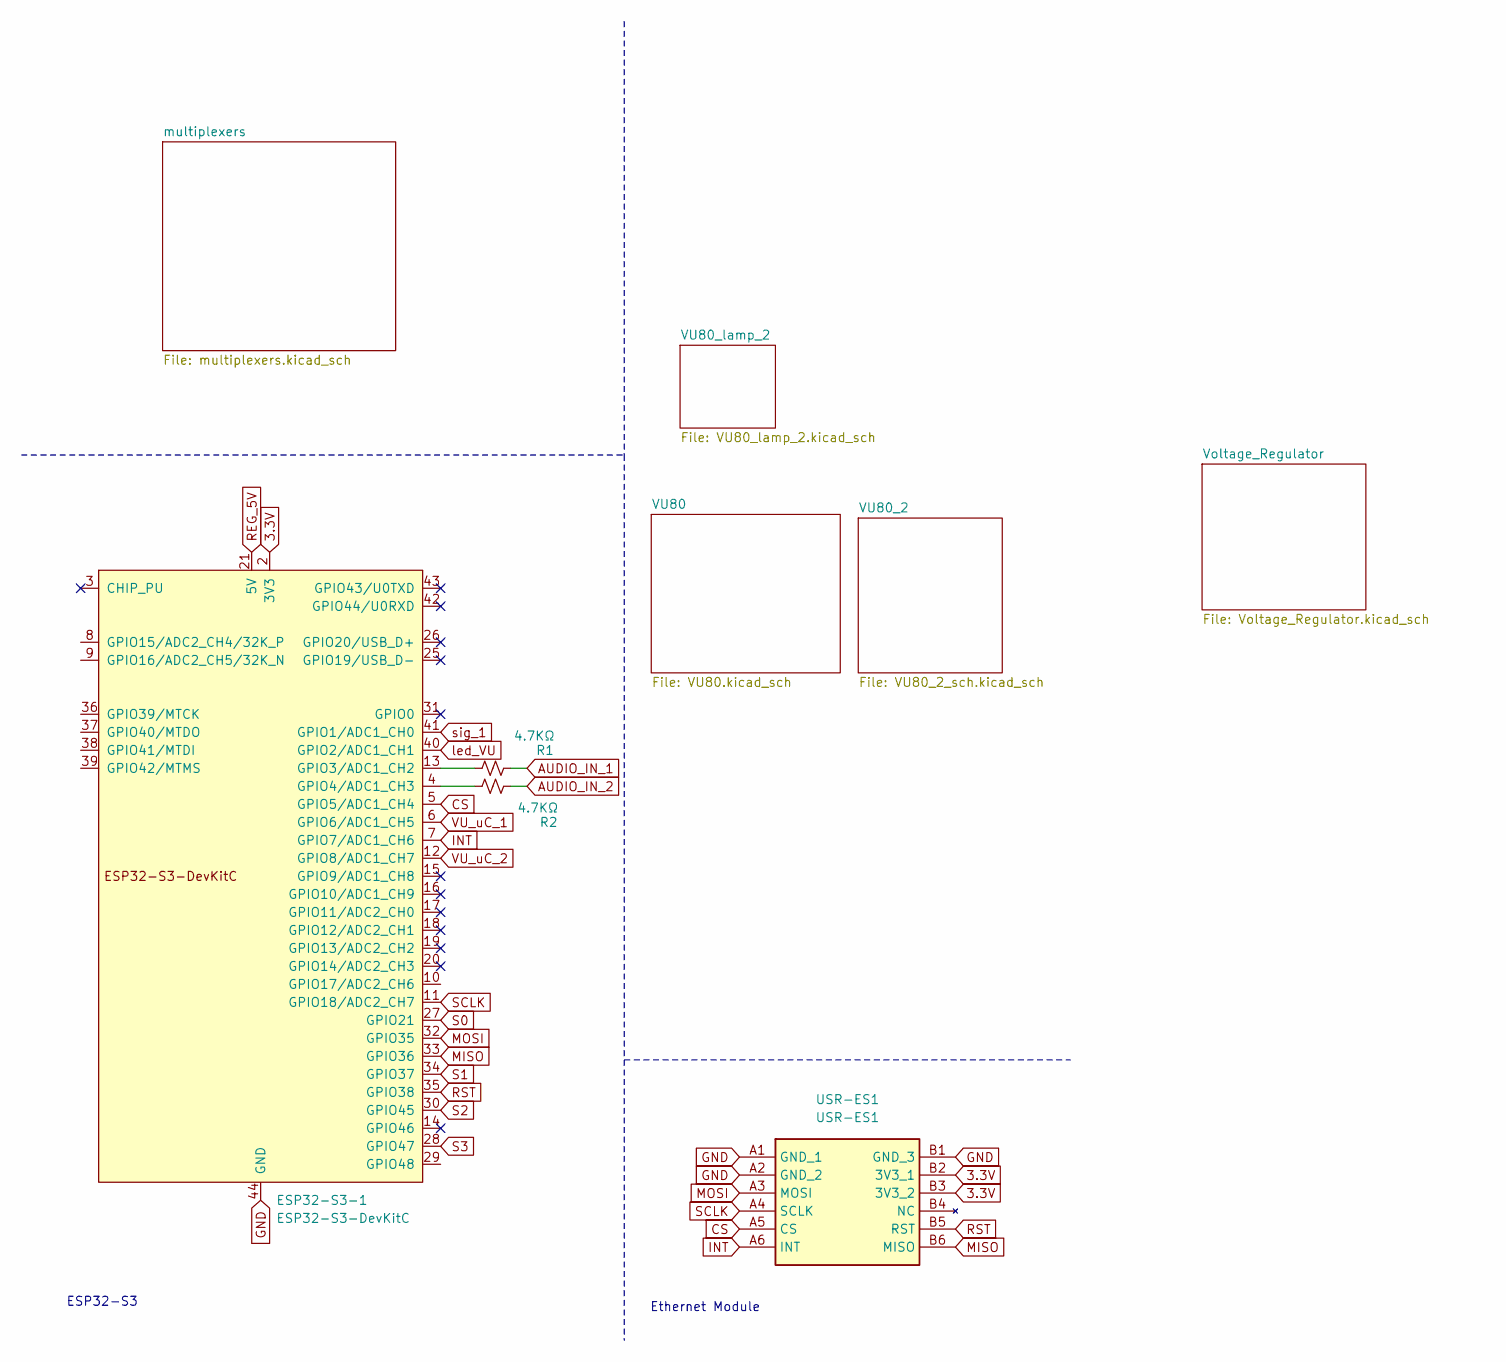
[picture p52: schematic Fairchild.kicad_sch]

Parts:
ESP32-S3-1: ESP32-S3-DevKitC; ESP32-S3-DEVKITC-1-N8R2-2
R1, R2: 4.7KΩ; R_0402_1005Metric; LCSC Part Number C25900
USR-ES1: USR-ES1; USRES1; Manufacturer_Part_Number USR-ES1

Connections:
3.3V: ESP32-S3-1.1 (3V3), ESP32-S3-1.2 (3V3), USR-ES1.B2 (3V3_1), USR-ES1.B3 (3V3_2); also elsewhere on the board
AUDIO_IN_1: R1.1; also elsewhere on the board
AUDIO_IN_2: R2.1; also elsewhere on the board
CS: ESP32-S3-1.5 (GPIO5/ADC1_CH4), USR-ES1.A5 (CS)
GND: ESP32-S3-1.22 (GND), ESP32-S3-1.23 (GND), ESP32-S3-1.24 (GND), ESP32-S3-1.44 (GND), USR-ES1.A1 (GND_1), USR-ES1.A2 (GND_2), USR-ES1.B1 (GND_3); also elsewhere on the board
INT: ESP32-S3-1.7 (GPIO7/ADC1_CH6), USR-ES1.A6 (INT)
MISO: ESP32-S3-1.33 (GPIO36), USR-ES1.B6 (MISO)
MOSI: ESP32-S3-1.32 (GPIO35), USR-ES1.A3 (MOSI)
unnamed: ESP32-S3-1.13 (GPIO3/ADC1_CH2), R1.2
unnamed: ESP32-S3-1.4 (GPIO4/ADC1_CH3), R2.2
REG_5V: ESP32-S3-1.21 (5V); also elsewhere on the board
RST: ESP32-S3-1.35 (GPIO38), USR-ES1.B5 (RST)
S0: ESP32-S3-1.27 (GPIO21); also elsewhere on the board
S1: ESP32-S3-1.34 (GPIO37); also elsewhere on the board
S2: ESP32-S3-1.30 (GPIO45); also elsewhere on the board
S3: ESP32-S3-1.28 (GPIO47); also elsewhere on the board
SCLK: ESP32-S3-1.11 (GPIO18/ADC2_CH7), USR-ES1.A4 (SCLK)
VU_uC_1: ESP32-S3-1.6 (GPIO6/ADC1_CH5); also elsewhere on the board
VU_uC_2: ESP32-S3-1.12 (GPIO8/ADC1_CH7); also elsewhere on the board
led_VU: ESP32-S3-1.40 (GPIO2/ADC1_CH1); also elsewhere on the board
sig_1: ESP32-S3-1.41 (GPIO1/ADC1_CH0); also elsewhere on the board

Notes on the sheet:
Ethernet Module
ESP32-S3

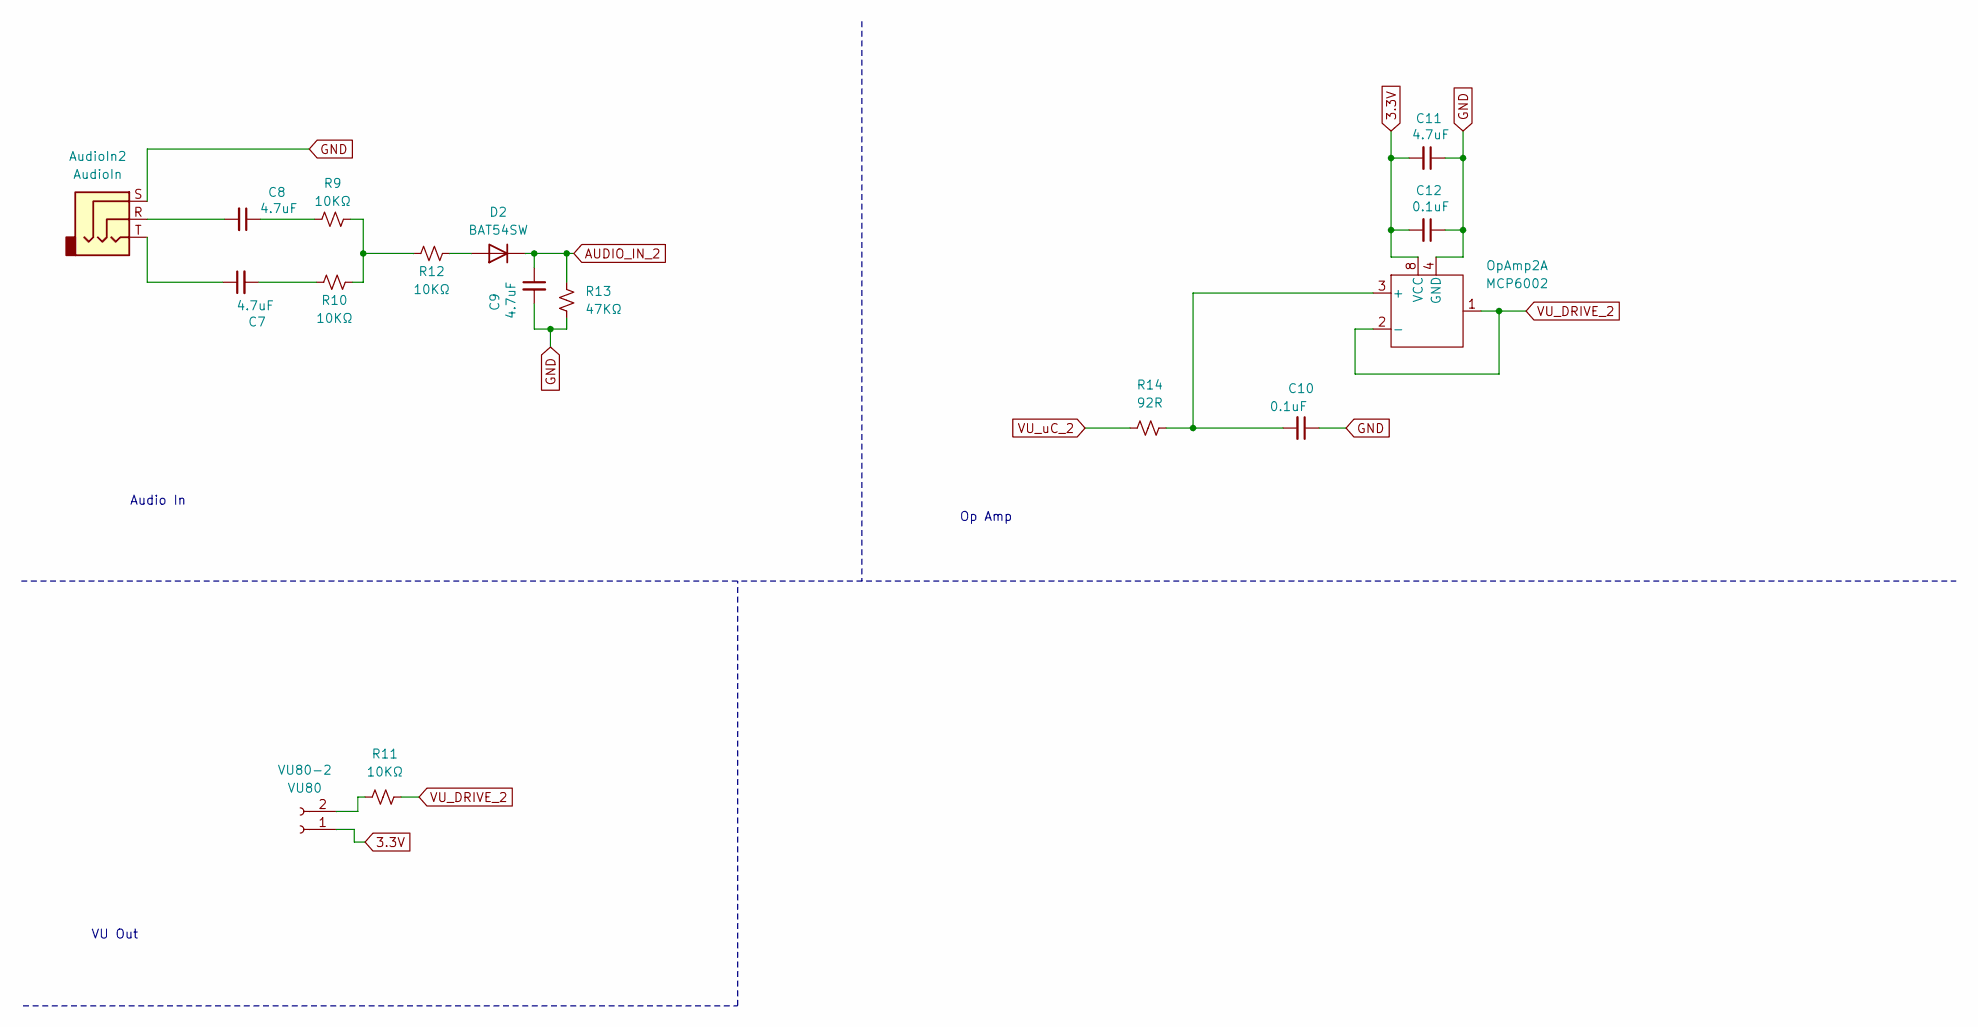
[picture p53: schematic VU80_2_sch.kicad_sch]

Parts:
AudioIn2: AudioIn; Jack_3.5mm_PJ320D_Horizontal
C7, C8, C9, C11: 4.7uF; C_0402_1005Metric; LCSC Part Number C23733
C10: 0.1uF; C_0402_1005Metric
C12: 0.1uF; C_0402_1005Metric; LCSC Part Number C1525
D2: BAT54SW; D_SOD-323; LCSC Part Number C27636114
OpAmp2: MCP6002; SOIC-8_3.9x4.9mm_P1.27mm
R9, R10, R11, R12: 10KΩ; C_0402_1005Metric; LCSC Part Number C25744
R13: 47KΩ; C_0402_1005Metric; LCSC Part Number C25792
R14: 92R; C_0402_1005Metric
VU80-2: VU80; PinSocket_1x02_P2.54mm_Vertical

Connections:
3.3V: C11.2, C12.2, OpAmp2.8 (VCC), VU80-2.1; also elsewhere on the board
AUDIO_IN_2: C9.1, D2.1 (K), R13.2; also elsewhere on the board
GND: AudioIn2.S, C9.2, C10.1, C11.1, C12.1, OpAmp2.4 (GND), R13.1; also elsewhere on the board
unnamed: AudioIn2.R, C8.2
unnamed: AudioIn2.T, C7.1
unnamed: C7.2, R10.2
unnamed: C8.1, R9.2
unnamed: D2.2 (A), R12.1
unnamed: C10.2, OpAmp2.3 (+), R14.1
unnamed: R9.1, R10.1, R12.2
unnamed: R11.2, VU80-2.2
VU_DRIVE_2: OpAmp2.1, OpAmp2.2 (-), R11.1
VU_uC_2: R14.2; also elsewhere on the board

Notes on the sheet:
VU Out
Op Amp
Audio In

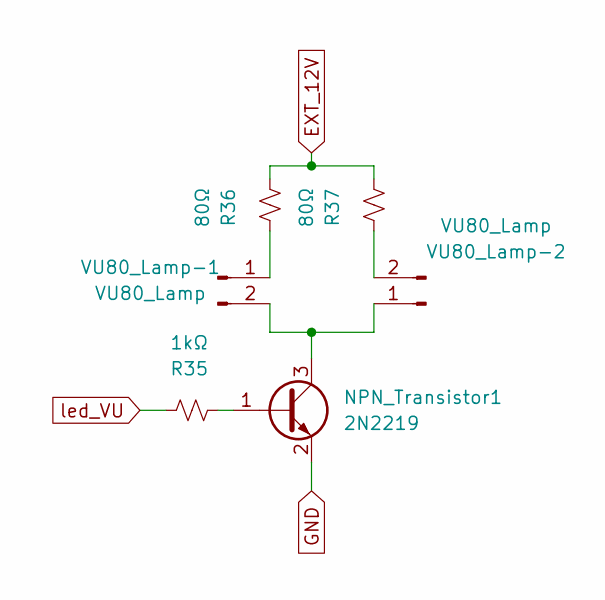
[picture p54: schematic VU80_lamp_2.kicad_sch]

Parts:
NPN_Transistor1: 2N2219; SOT-23; LCSC Part Number C2150
R35: 1kΩ; R_0402_1005Metric; Manufacturer_Part_Number 0402WGF3300TCE; LCSC Part Number C11702
R36, R37: 80Ω; R_0402_1005Metric; Manufacturer_Part_Number RT0402FRE0780RL; LCSC Part Number C854436
VU80_Lamp-1, VU80_Lamp-2: VU80_Lamp; PinSocket_1x02_P2.54mm_Vertical

Connections:
EXT_12V: R36.1, R37.1; also elsewhere on the board
GND: NPN_Transistor1.2 (E); also elsewhere on the board
unnamed: NPN_Transistor1.1 (B), R35.1
unnamed: NPN_Transistor1.3 (C), VU80_Lamp-1.2, VU80_Lamp-2.1
unnamed: R36.2, VU80_Lamp-1.1
unnamed: R37.2, VU80_Lamp-2.2
led_VU: R35.2; also elsewhere on the board

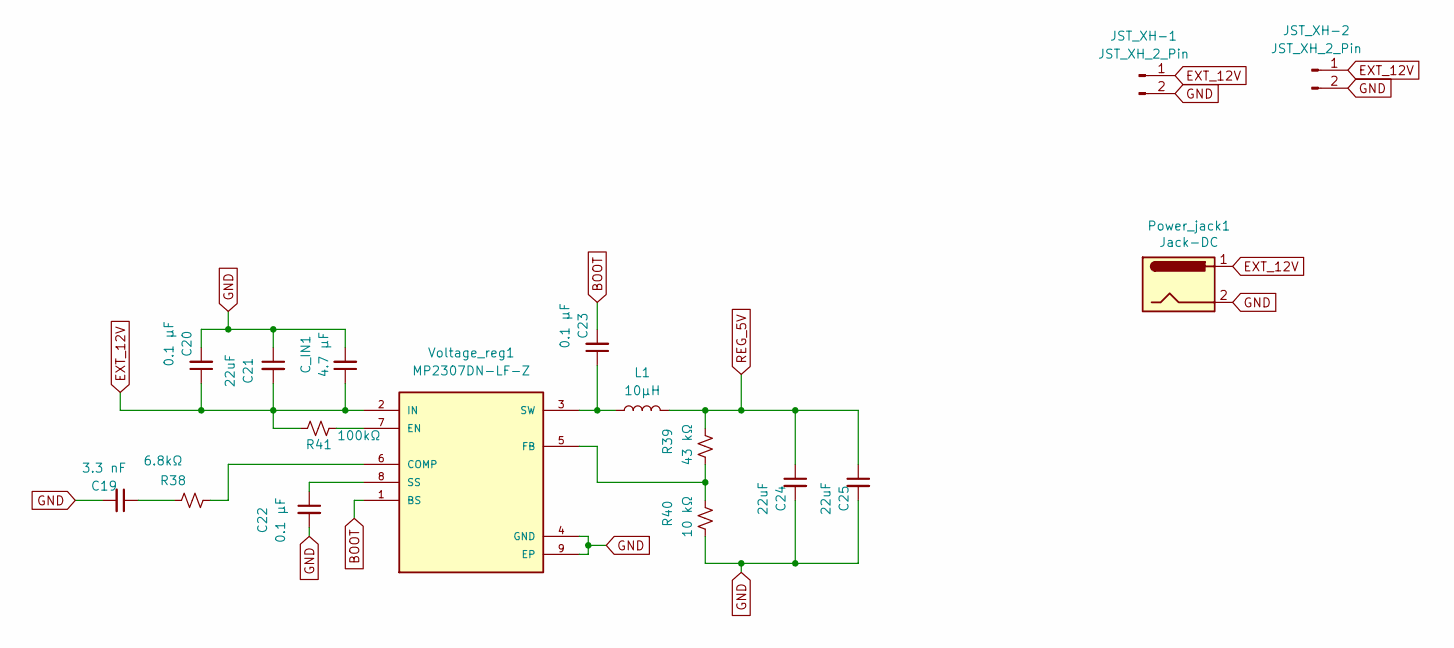
[picture p55: schematic Voltage_Regulator.kicad_sch]

Parts:
C19: 3.3 nF; C_0603_1608Metric; LCSC Part Number C1613
C20, C22, C23: 0.1 µF; C_0402_1005Metric; LCSC Part Number C1525
C21, C24, C25: 22uF; C_0603_1608Metric; LCSC Part Number C59461
C_IN1: 4.7 µF; C_0402_1005Metric; LCSC Part Number C23733
JST_XH-1, JST_XH-2: JST_XH_2_Pin; JST_XH_B2B-XH-A_1x02_P2.50mm_Vertical
L1: 10µH; L_Bourns-SRN8040_8x8.15mm; LCSC Part Number C37429
Power_jack1: Jack-DC; BarrelJack_Horizontal
R38: 6.8kΩ; R_0603_1608Metric; LCSC Part Number C23212
R39: 43 kΩ; R_0402_1005Metric; LCSC Part Number C2906943
R40: 10 kΩ; R_0402_1005Metric; LCSC Part Number C25744
R41: 100kΩ; R_0603_1608Metric
Voltage_reg1: MP2307DN-LF-Z; SOIC-8-1EP_3.9x4.9mm_P1.27mm_EP2.29x3mm_ThermalVias; PARTREV 1.9; LCSC Part Number C2928813

Connections:
BOOT: C23.2, Voltage_reg1.1 (BS)
EXT_12V: C20.1, C21.2, C_IN1.1, JST_XH-1.1, JST_XH-2.1, Power_jack1.1, R41.1, Voltage_reg1.2 (IN); also elsewhere on the board
GND: C19.2, C20.2, C21.1, C22.2, C24.2, C25.2, C_IN1.2, JST_XH-1.2, JST_XH-2.2, Power_jack1.2, R40.2, Voltage_reg1.4 (GND), Voltage_reg1.9 (EP); also elsewhere on the board
unnamed: C19.1, R38.1
unnamed: R38.2, Voltage_reg1.6 (COMP)
unnamed: R41.2, Voltage_reg1.7 (EN)
unnamed: R39.2, R40.1, Voltage_reg1.5 (FB)
unnamed: C22.1, Voltage_reg1.8 (SS)
unnamed: C23.1, L1.1, Voltage_reg1.3 (SW)
REG_5V: C24.1, C25.1, L1.2, R39.1; also elsewhere on the board

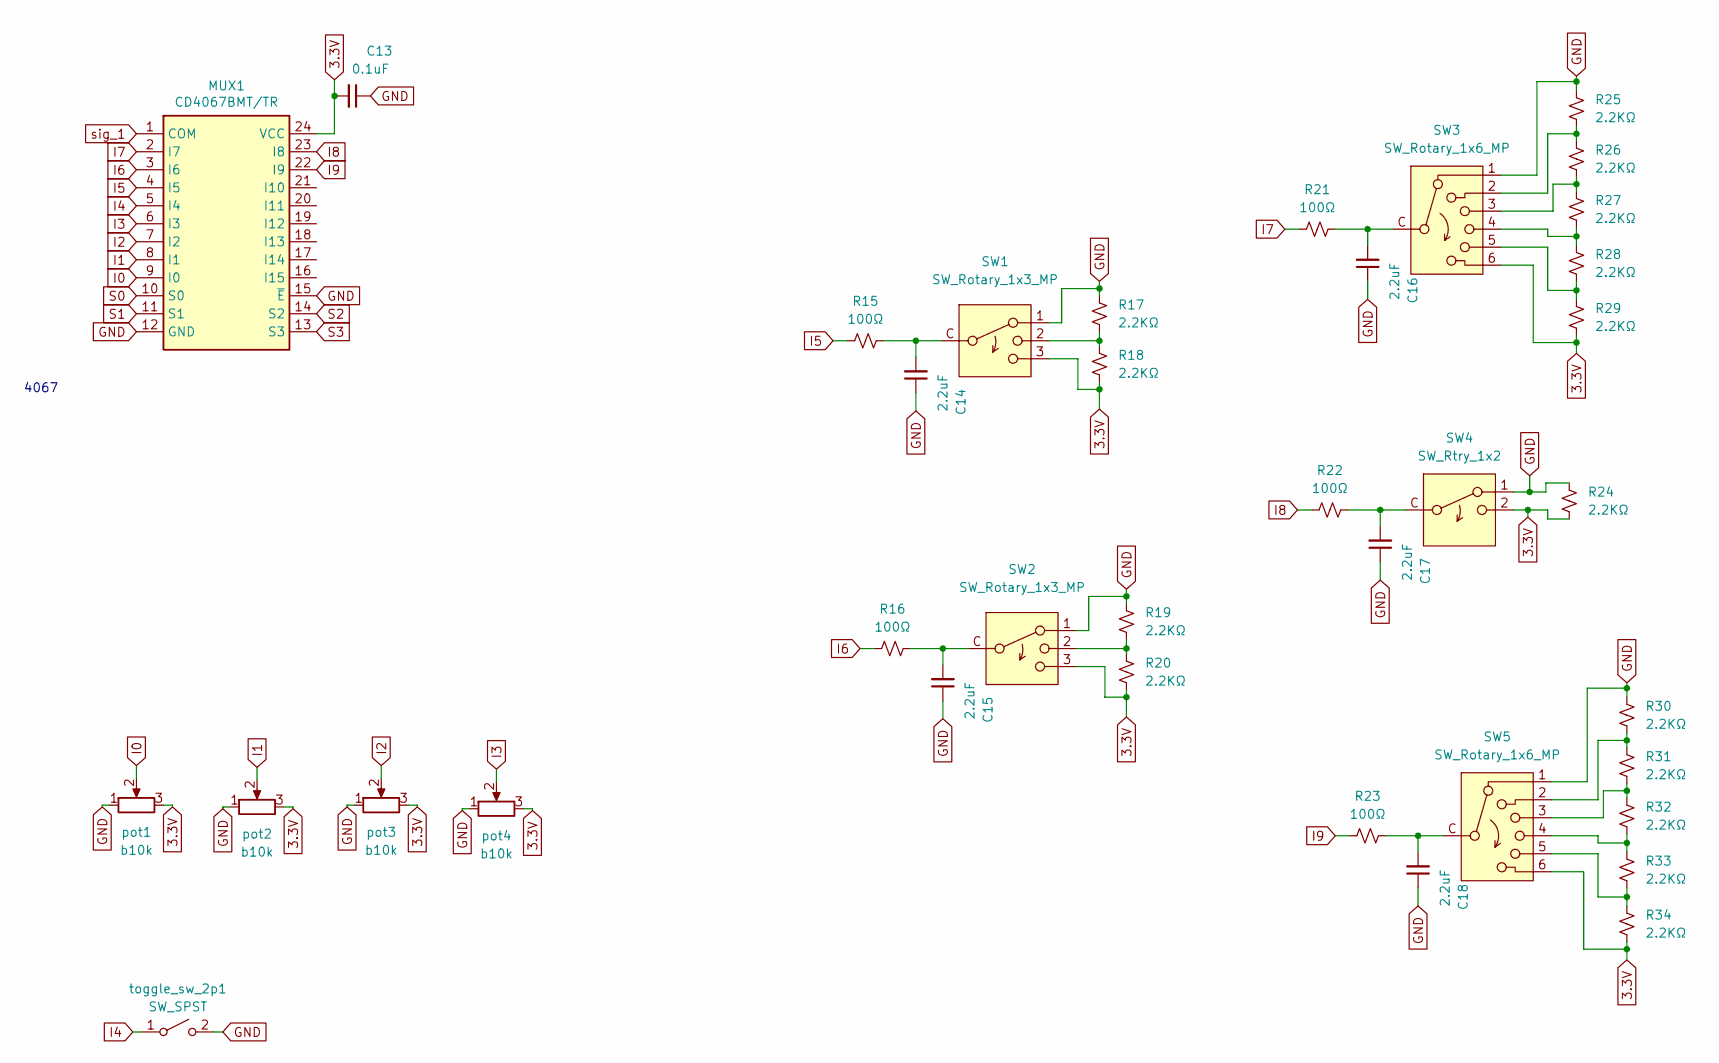
[picture p56: schematic multiplexers.kicad_sch]

Parts:
C13: 0.1uF; C_0402_1005Metric; LCSC Part Number C1525
C14, C15, C16, C17, C18: 2.2uF; C_0402_1005Metric; LCSC Part Number C12530
MUX1: CD4067BMT/TR; TSSOP-24_4.4x7.8mm_P0.65mm; LCSC Part Number C7432333
R15, R16, R21, R22, R23: 100Ω; R_0402_1005Metric; LCSC Part Number C25076
R17, R18, R19, R20, R24, R25, R26, R27, R28, R29, R30, R31, R32, R33, R34: 2.2KΩ; R_0402_1005Metric; LCSC Part Number C25879
SW1, SW2: SW_Rotary_1x3_MP; SW_Rotary_RS25-3P
SW3, SW5: SW_Rotary_1x6_MP; SW_Rotary_RS25-6P
SW4: SW_Rtry_1x2; SW_Rotary_RS25-2P
pot1, pot2, pot3, pot4: b10k; Potentiometer_Alps_RK09K_Single_Vertical
toggle_sw_2p1: SW_SPST; Toggle_Switch-2-pins

Connections:
3.3V: C13.2, MUX1.24 (VCC), R18.1, R20.1, R24.1, R29.1, R34.1, SW1.3, SW2.3, SW3.6, SW4.2, SW5.6, pot1.3, pot2.3, pot3.3, pot4.3; also elsewhere on the board
GND: C13.1, C14.1, C15.1, C16.1, C17.1, C18.1, MUX1.12 (GND), MUX1.15 (~E), R17.2, R19.2, R24.2, R25.2, R30.2, SW1.1, SW2.1, SW3.1, SW4.1, SW5.1, pot1.1, pot2.1, pot3.1, pot4.1, toggle_sw_2p1.2 (B); also elsewhere on the board
I0: MUX1.9 (I0), pot1.2
I1: MUX1.8 (I1), pot2.2
I2: MUX1.7 (I2), pot3.2
I3: MUX1.6 (I3), pot4.2
I4: MUX1.5 (I4), toggle_sw_2p1.1 (A)
I5: MUX1.4 (I5), R15.1
I6: MUX1.3 (I6), R16.1
I7: MUX1.2 (I7), R21.1
I8: MUX1.23 (I8), R22.1
I9: MUX1.22 (I9), R23.1
unnamed: C14.2, R15.2, SW1.C
unnamed: C15.2, R16.2, SW2.C
unnamed: C16.2, R21.2, SW3.C
unnamed: C17.2, R22.2, SW4.C
unnamed: C18.2, R23.2, SW5.C
unnamed: R17.1, R18.2, SW1.2
unnamed: R19.1, R20.2, SW2.2
unnamed: R25.1, R26.2, SW3.2
unnamed: R26.1, R27.2, SW3.3
unnamed: R27.1, R28.2, SW3.4
unnamed: R28.1, R29.2, SW3.5
unnamed: R30.1, R31.2, SW5.2
unnamed: R31.1, R32.2, SW5.3
unnamed: R32.1, R33.2, SW5.4
unnamed: R33.1, R34.2, SW5.5
S0: MUX1.10 (S0); also elsewhere on the board
S1: MUX1.11 (S1); also elsewhere on the board
S2: MUX1.14 (S2); also elsewhere on the board
S3: MUX1.13 (S3); also elsewhere on the board
sig_1: MUX1.1 (COM); also elsewhere on the board

Notes on the sheet:
4067

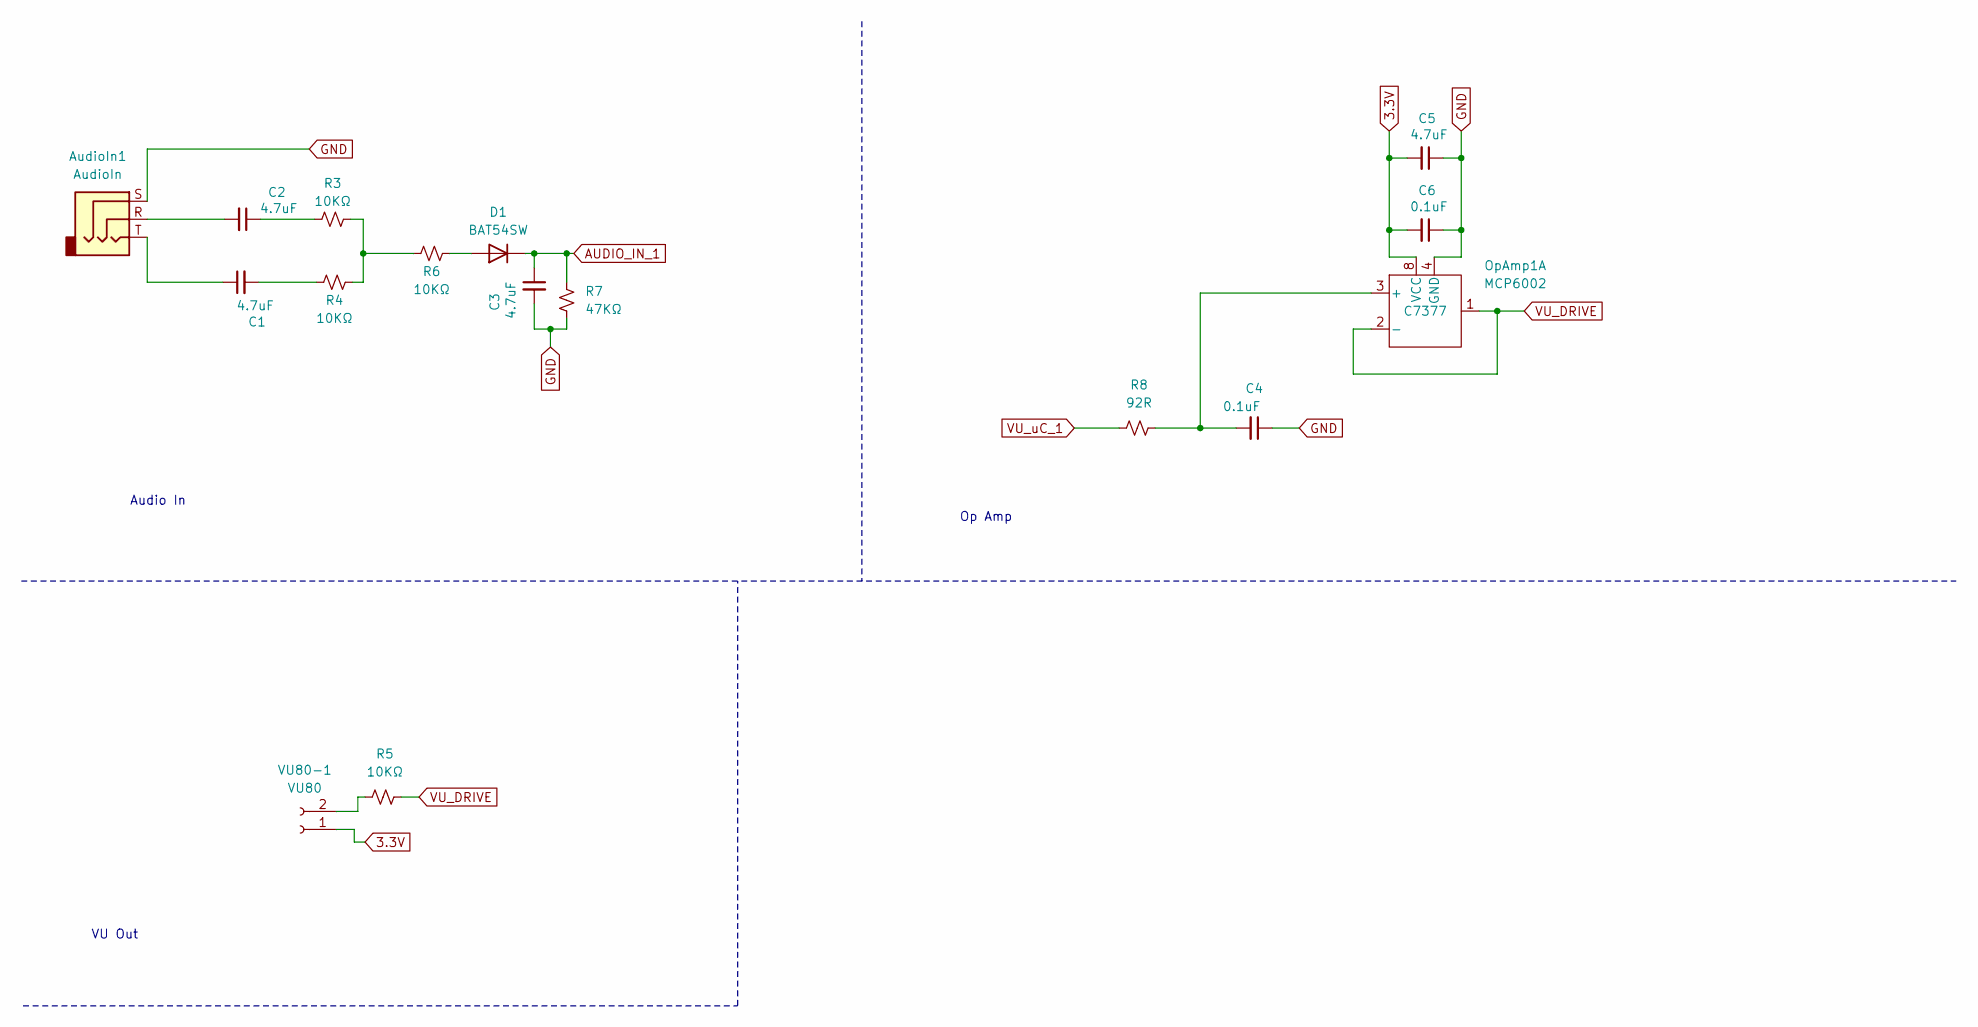
[picture p57: schematic VU80.kicad_sch]

Parts:
AudioIn1: AudioIn; Jack_3.5mm_PJ320D_Horizontal; LCSC Part Number C22459515
C1, C2, C3, C5: 4.7uF; C_0402_1005Metric; LCSC Part Number C23733
C4: 0.1uF; C_0402_1005Metric
C6: 0.1uF; C_0402_1005Metric; LCSC Part Number C1525
D1: BAT54SW; D_SOD-323; LCSC Part Number C27636114
OpAmp1: MCP6002; SOIC-8_3.9x4.9mm_P1.27mm; LCSC Part Number C7377
R3, R4, R5, R6: 10KΩ; C_0402_1005Metric; LCSC Part Number C25744
R7: 47KΩ; C_0402_1005Metric; LCSC Part Number C25792
R8: 92R; C_0402_1005Metric
VU80-1: VU80; PinSocket_1x02_P2.54mm_Vertical

Connections:
3.3V: C5.2, C6.2, OpAmp1.8 (VCC), VU80-1.1; also elsewhere on the board
AUDIO_IN_1: C3.1, D1.1 (K), R7.2; also elsewhere on the board
GND: AudioIn1.S, C3.2, C4.1, C5.1, C6.1, OpAmp1.4 (GND), R7.1; also elsewhere on the board
unnamed: AudioIn1.R, C2.2
unnamed: AudioIn1.T, C1.1
unnamed: C1.2, R4.2
unnamed: C2.1, R3.2
unnamed: D1.2 (A), R6.1
unnamed: C4.2, OpAmp1.3 (+), R8.1
unnamed: R3.1, R4.1, R6.2
unnamed: R5.2, VU80-1.2
VU_DRIVE: OpAmp1.1, OpAmp1.2 (-), R5.1
VU_uC_1: R8.2; also elsewhere on the board

Notes on the sheet:
VU Out
Op Amp
Audio In

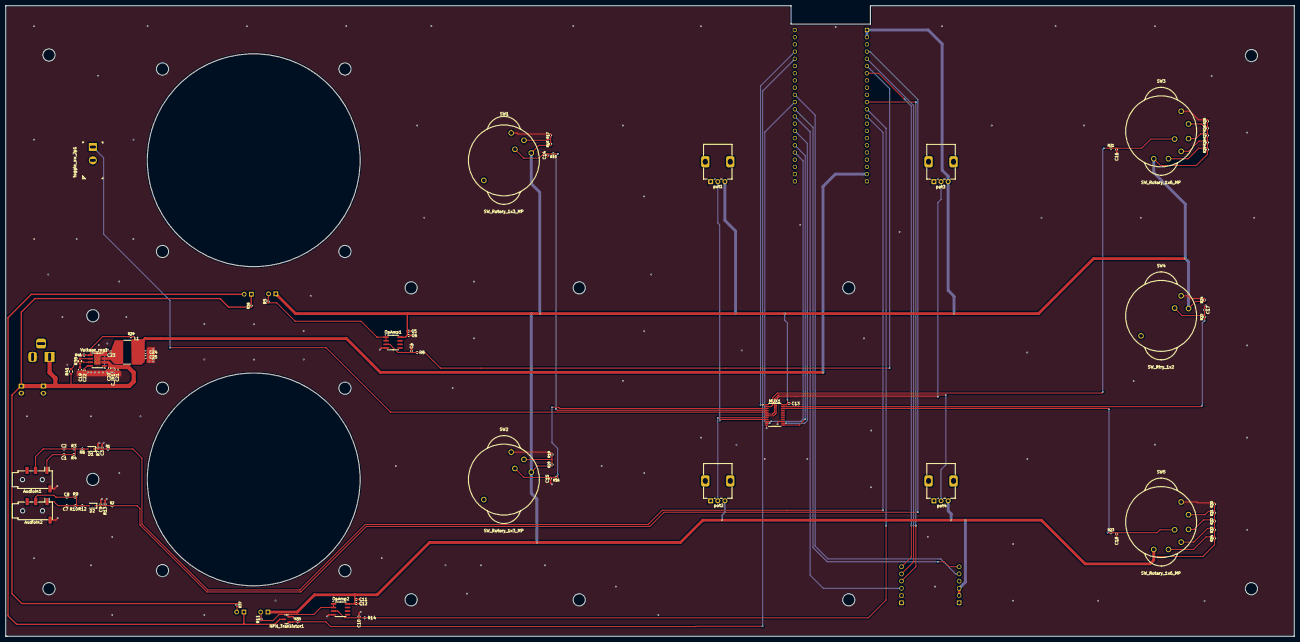
[picture p58: board Fairchild.kicad_pcb from above]

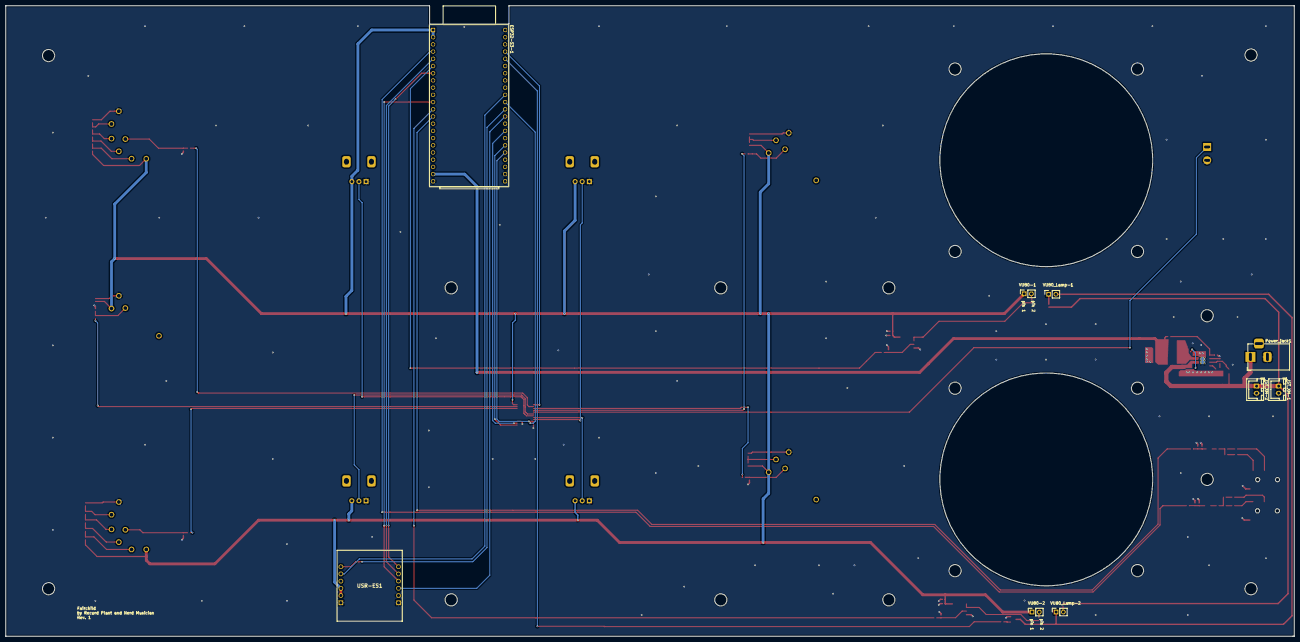
[picture p59: board Fairchild.kicad_pcb from below]

Board: 2 copper layers, 454.1 x 222.2 mm, 96 parts (9 on the bottom side), 76 nets.
