eSpark-Backup/patrizio-moi-pcb-fixes/Design_Files/10 - Manley VS-MU - 21-June-2025/Manley-VS-MU.kicad_pcb

## KiCad design Design_Files/10 - Manley VS-MU - 21-June-2025/Manley-VS-MU.kicad_pcb (2025-08-05)

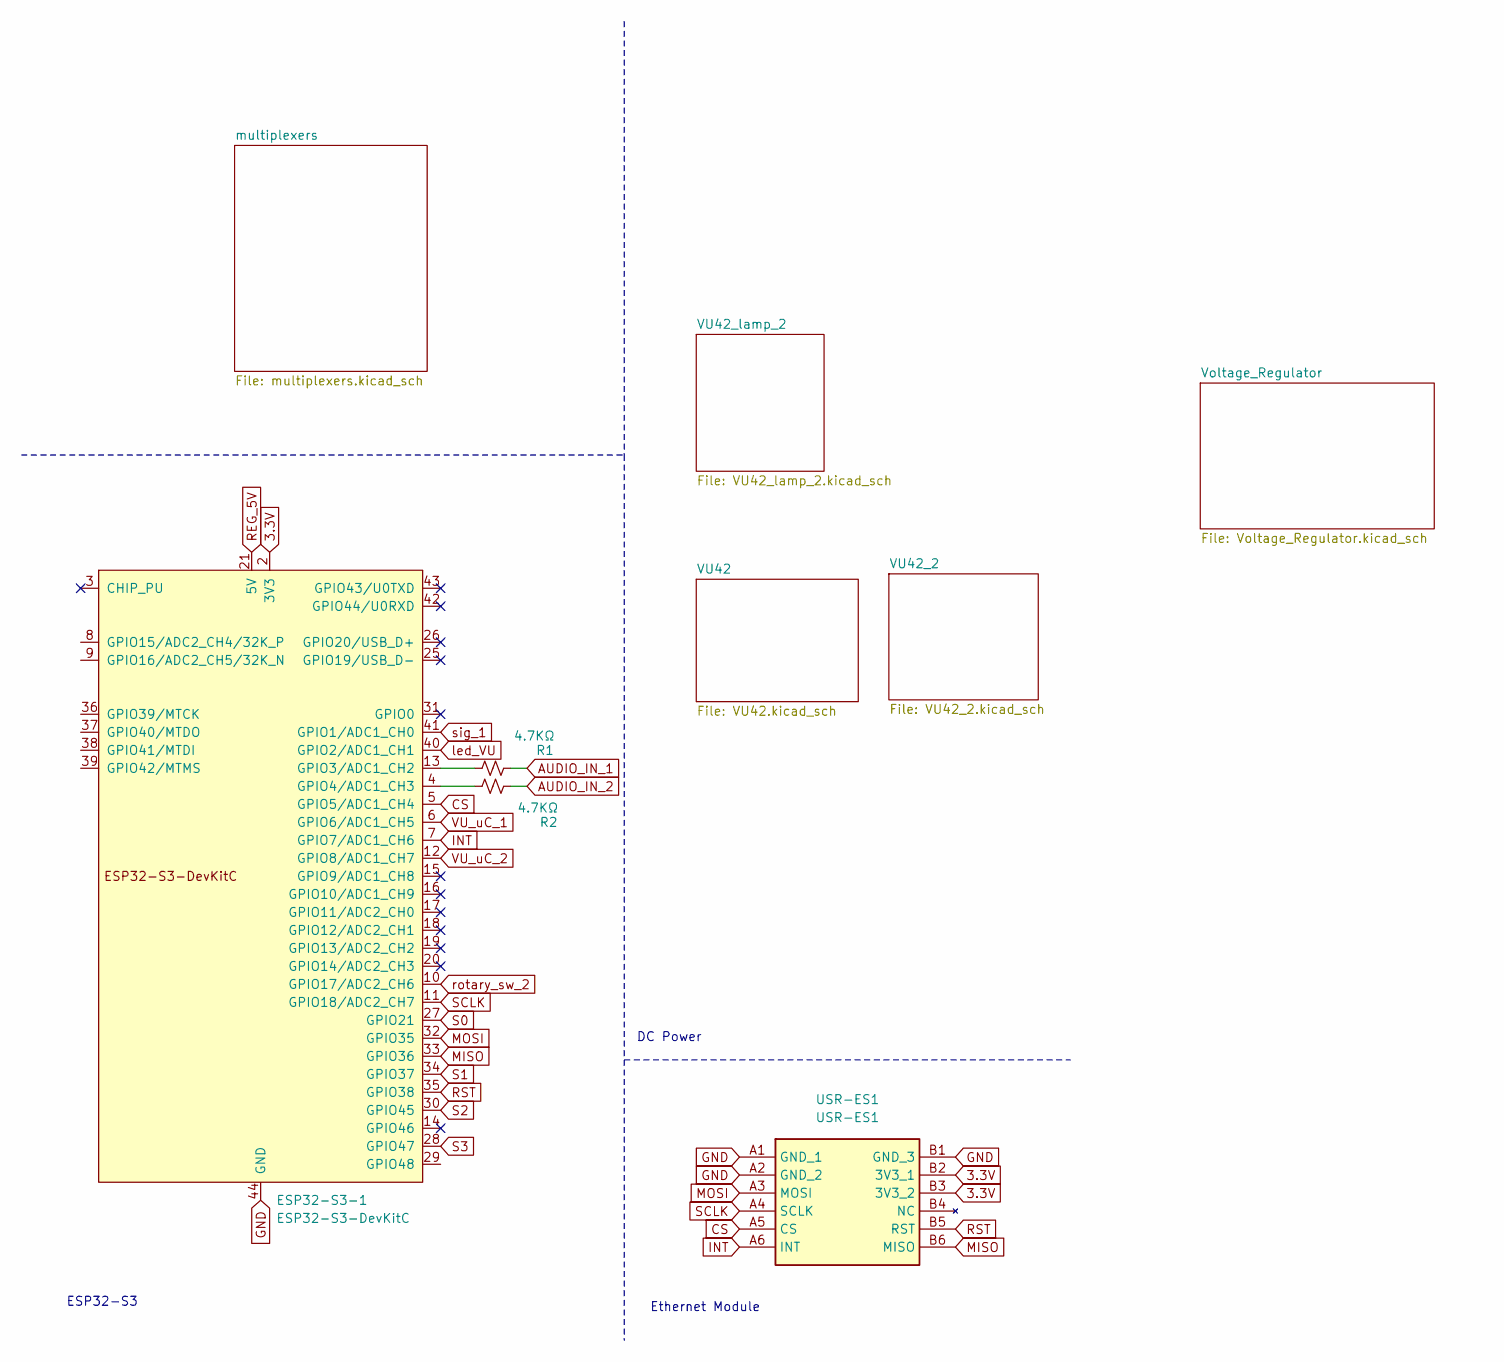
[picture p60: schematic Manley-VS-MU.kicad_sch]

Parts:
ESP32-S3-1: ESP32-S3-DevKitC; ESP32-S3-DEVKITC-1-N8R2-2; PARTREV V1
R1, R2: 4.7KΩ; R_0402_1005Metric; LCSC Part Number C25900
USR-ES1: USR-ES1; USRES1; Manufacturer_Part_Number USR-ES1

Connections:
3.3V: ESP32-S3-1.1 (3V3), ESP32-S3-1.2 (3V3), USR-ES1.B2 (3V3_1), USR-ES1.B3 (3V3_2); also elsewhere on the board
AUDIO_IN_1: R1.1; also elsewhere on the board
AUDIO_IN_2: R2.1; also elsewhere on the board
CS: ESP32-S3-1.5 (GPIO5/ADC1_CH4), USR-ES1.A5 (CS)
GND: ESP32-S3-1.22 (GND), ESP32-S3-1.23 (GND), ESP32-S3-1.24 (GND), ESP32-S3-1.44 (GND), USR-ES1.A1 (GND_1), USR-ES1.A2 (GND_2), USR-ES1.B1 (GND_3); also elsewhere on the board
INT: ESP32-S3-1.7 (GPIO7/ADC1_CH6), USR-ES1.A6 (INT)
MISO: ESP32-S3-1.33 (GPIO36), USR-ES1.B6 (MISO)
MOSI: ESP32-S3-1.32 (GPIO35), USR-ES1.A3 (MOSI)
unnamed: ESP32-S3-1.13 (GPIO3/ADC1_CH2), R1.2
unnamed: ESP32-S3-1.4 (GPIO4/ADC1_CH3), R2.2
REG_5V: ESP32-S3-1.21 (5V); also elsewhere on the board
RST: ESP32-S3-1.35 (GPIO38), USR-ES1.B5 (RST)
S0: ESP32-S3-1.27 (GPIO21); also elsewhere on the board
S1: ESP32-S3-1.34 (GPIO37); also elsewhere on the board
S2: ESP32-S3-1.30 (GPIO45); also elsewhere on the board
S3: ESP32-S3-1.28 (GPIO47); also elsewhere on the board
SCLK: ESP32-S3-1.11 (GPIO18/ADC2_CH7), USR-ES1.A4 (SCLK)
VU_uC_1: ESP32-S3-1.6 (GPIO6/ADC1_CH5); also elsewhere on the board
VU_uC_2: ESP32-S3-1.12 (GPIO8/ADC1_CH7); also elsewhere on the board
led_VU: ESP32-S3-1.40 (GPIO2/ADC1_CH1); also elsewhere on the board
rotary_sw_2: ESP32-S3-1.10 (GPIO17/ADC2_CH6); also elsewhere on the board
sig_1: ESP32-S3-1.41 (GPIO1/ADC1_CH0); also elsewhere on the board

Notes on the sheet:
Ethernet Module
DC Power
ESP32-S3

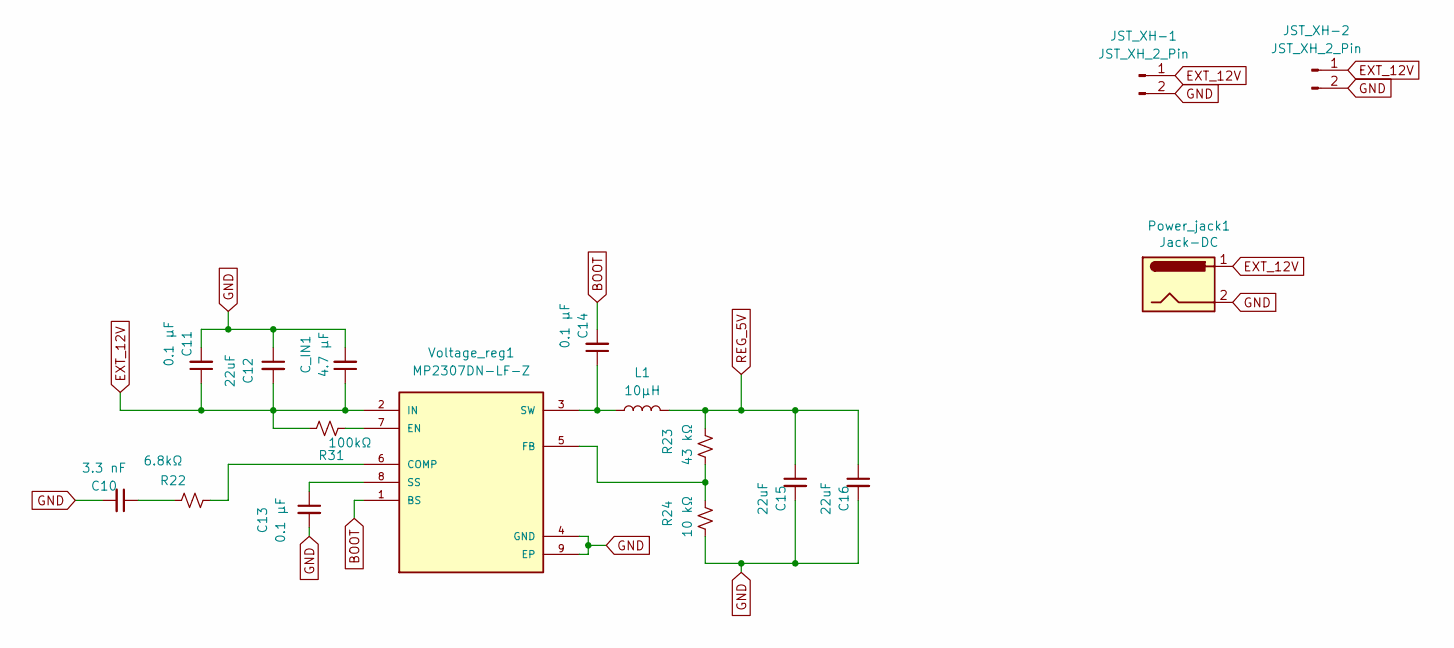
[picture p61: schematic Voltage_Regulator.kicad_sch]

Parts:
C10: 3.3 nF; C_0603_1608Metric; LCSC Part Number C1613
C11, C13, C14: 0.1 µF; C_0402_1005Metric; LCSC Part Number C1525
C12, C15, C16: 22uF; C_0603_1608Metric; LCSC Part Number C59461
C_IN1: 4.7 µF; C_0402_1005Metric; LCSC Part Number C23733
JST_XH-1, JST_XH-2: JST_XH_2_Pin; JST_XH_B2B-XH-A_1x02_P2.50mm_Vertical
L1: 10µH; L_Bourns-SRN8040_8x8.15mm; LCSC Part Number C37429
Power_jack1: Jack-DC; BarrelJack_Horizontal
R22: 6.8kΩ; R_0603_1608Metric; LCSC Part Number C23212
R23: 43 kΩ; R_0402_1005Metric; LCSC Part Number C2906943
R24: 10 kΩ; R_0402_1005Metric; LCSC Part Number C25744
R31: 100kΩ; R_0603_1608Metric
Voltage_reg1: MP2307DN-LF-Z; SOIC-8-1EP_3.9x4.9mm_P1.27mm_EP2.29x3mm_ThermalVias; PARTREV 1.9; LCSC Part Number C2928813

Connections:
BOOT: C14.2, Voltage_reg1.1 (BS)
EXT_12V: C11.1, C12.2, C_IN1.1, JST_XH-1.1, JST_XH-2.1, Power_jack1.1, R31.1, Voltage_reg1.2 (IN); also elsewhere on the board
GND: C10.2, C11.2, C12.1, C13.2, C15.2, C16.2, C_IN1.2, JST_XH-1.2, JST_XH-2.2, Power_jack1.2, R24.2, Voltage_reg1.4 (GND), Voltage_reg1.9 (EP); also elsewhere on the board
unnamed: C10.1, R22.1
unnamed: R22.2, Voltage_reg1.6 (COMP)
unnamed: R31.2, Voltage_reg1.7 (EN)
unnamed: R23.2, R24.1, Voltage_reg1.5 (FB)
unnamed: C13.1, Voltage_reg1.8 (SS)
unnamed: C14.1, L1.1, Voltage_reg1.3 (SW)
REG_5V: C15.1, C16.1, L1.2, R23.1; also elsewhere on the board

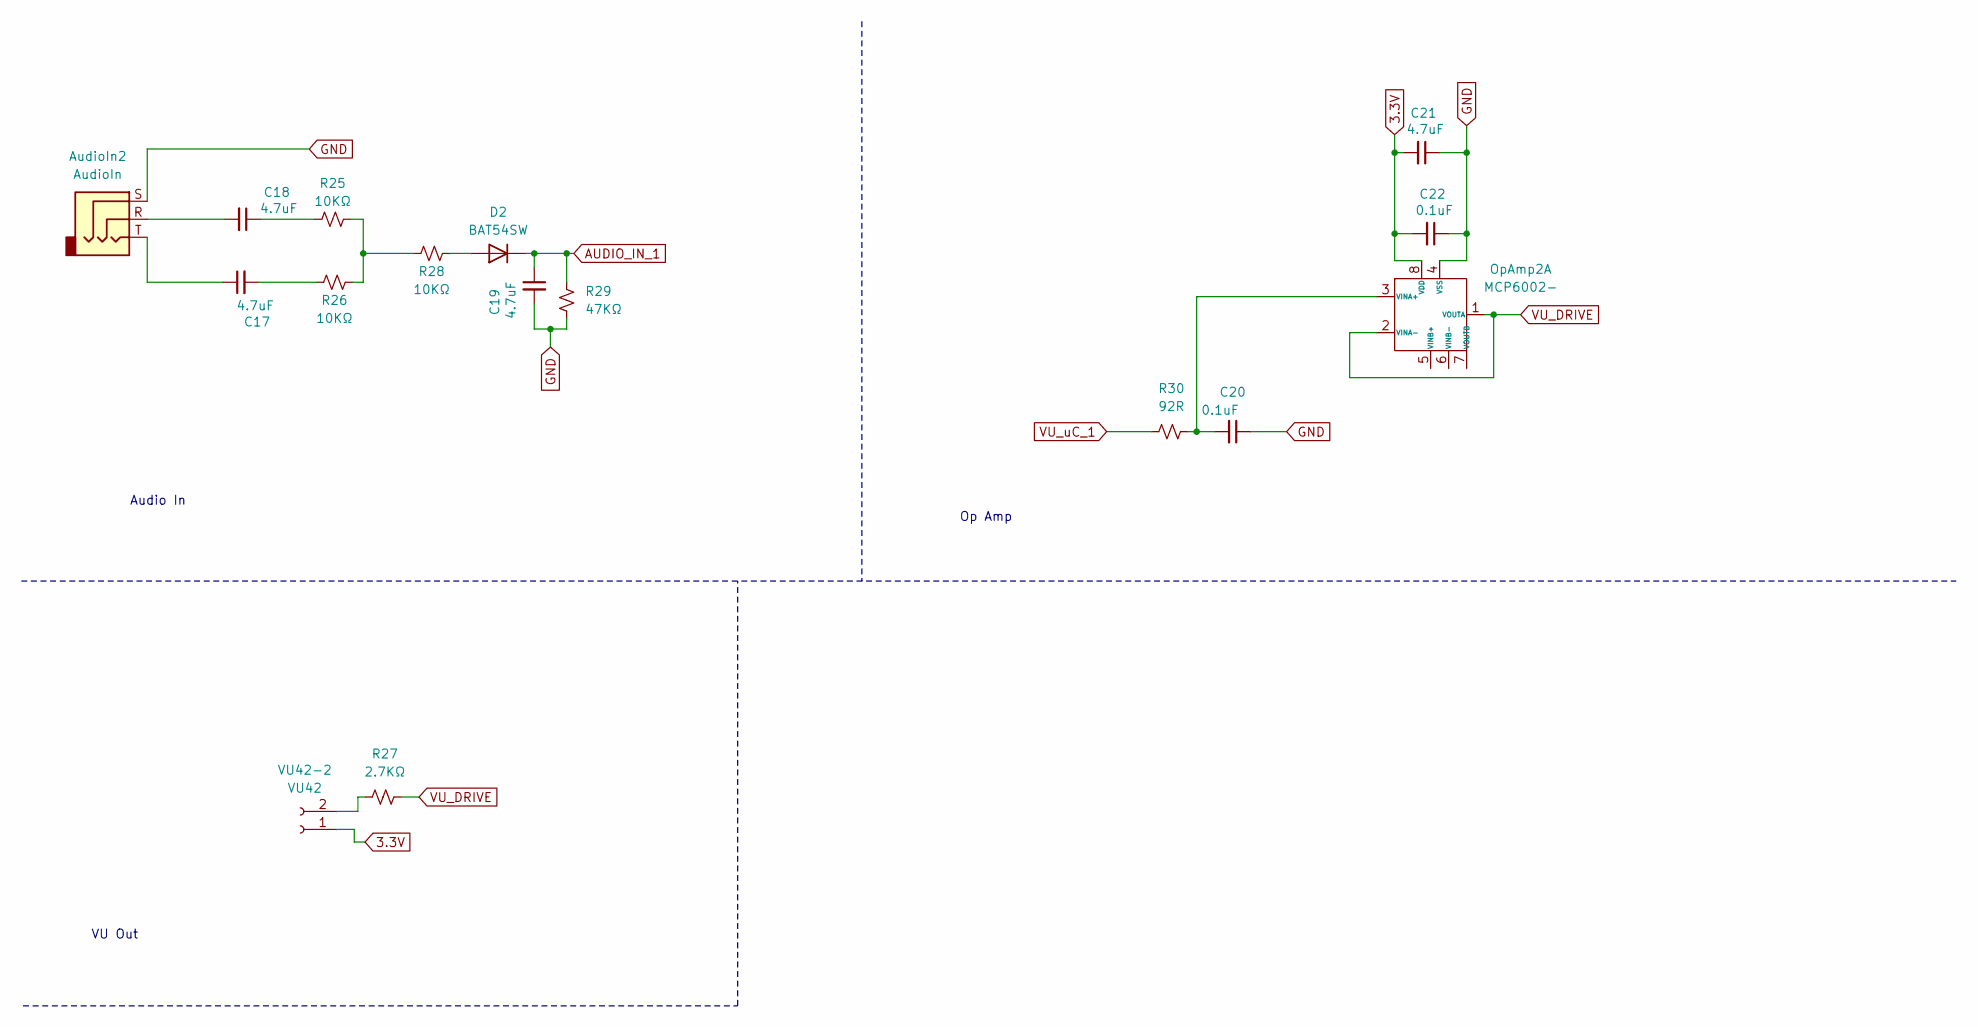
[picture p62: schematic VU42.kicad_sch]

Parts:
AudioIn2: AudioIn; Jack_3.5mm_PJ320D_Horizontal; LCSC Part Number C22459515
C17, C18, C19, C21: 4.7uF; C_0402_1005Metric; LCSC Part Number C23733
C20: 0.1uF; C_0402_1005Metric
C22: 0.1uF; C_0402_1005Metric; LCSC Part Number C1525
D2: BAT54SW; D_SOD-323; LCSC Part Number C27636114
OpAmp2: MCP6002-; SOIC-8_3.9x4.9mm_P1.27mm; LCSC Part Number C7377
R25, R26, R28: 10KΩ; R_0402_1005Metric; LCSC Part Number C25744
R27: 2.7KΩ; R_0603_1608Metric; LCSC Part Number C13167
R29: 47KΩ; R_0402_1005Metric; LCSC Part Number C25792
R30: 92R; R_0402_1005Metric
VU42-2: VU42; PinSocket_1x02_P2.54mm_Vertical

Connections:
3.3V: C21.2, C22.2, OpAmp2.8 (VDD), VU42-2.1; also elsewhere on the board
AUDIO_IN_1: C19.1, D2.1 (K), R29.2; also elsewhere on the board
GND: AudioIn2.S, C19.2, C20.1, C21.1, C22.1, OpAmp2.4 (VSS), R29.1; also elsewhere on the board
unnamed: AudioIn2.R, C18.2
unnamed: AudioIn2.T, C17.1
unnamed: C17.2, R26.2
unnamed: C18.1, R25.2
unnamed: D2.2 (A), R28.1
unnamed: C20.2, OpAmp2.3 (VINA+), R30.1
unnamed: R25.1, R26.1, R28.2
unnamed: R27.2, VU42-2.2
VU_DRIVE: OpAmp2.1 (VOUTA), OpAmp2.2 (VINA-), R27.1
VU_uC_1: R30.2; also elsewhere on the board

Notes on the sheet:
VU Out
Op Amp
Audio In

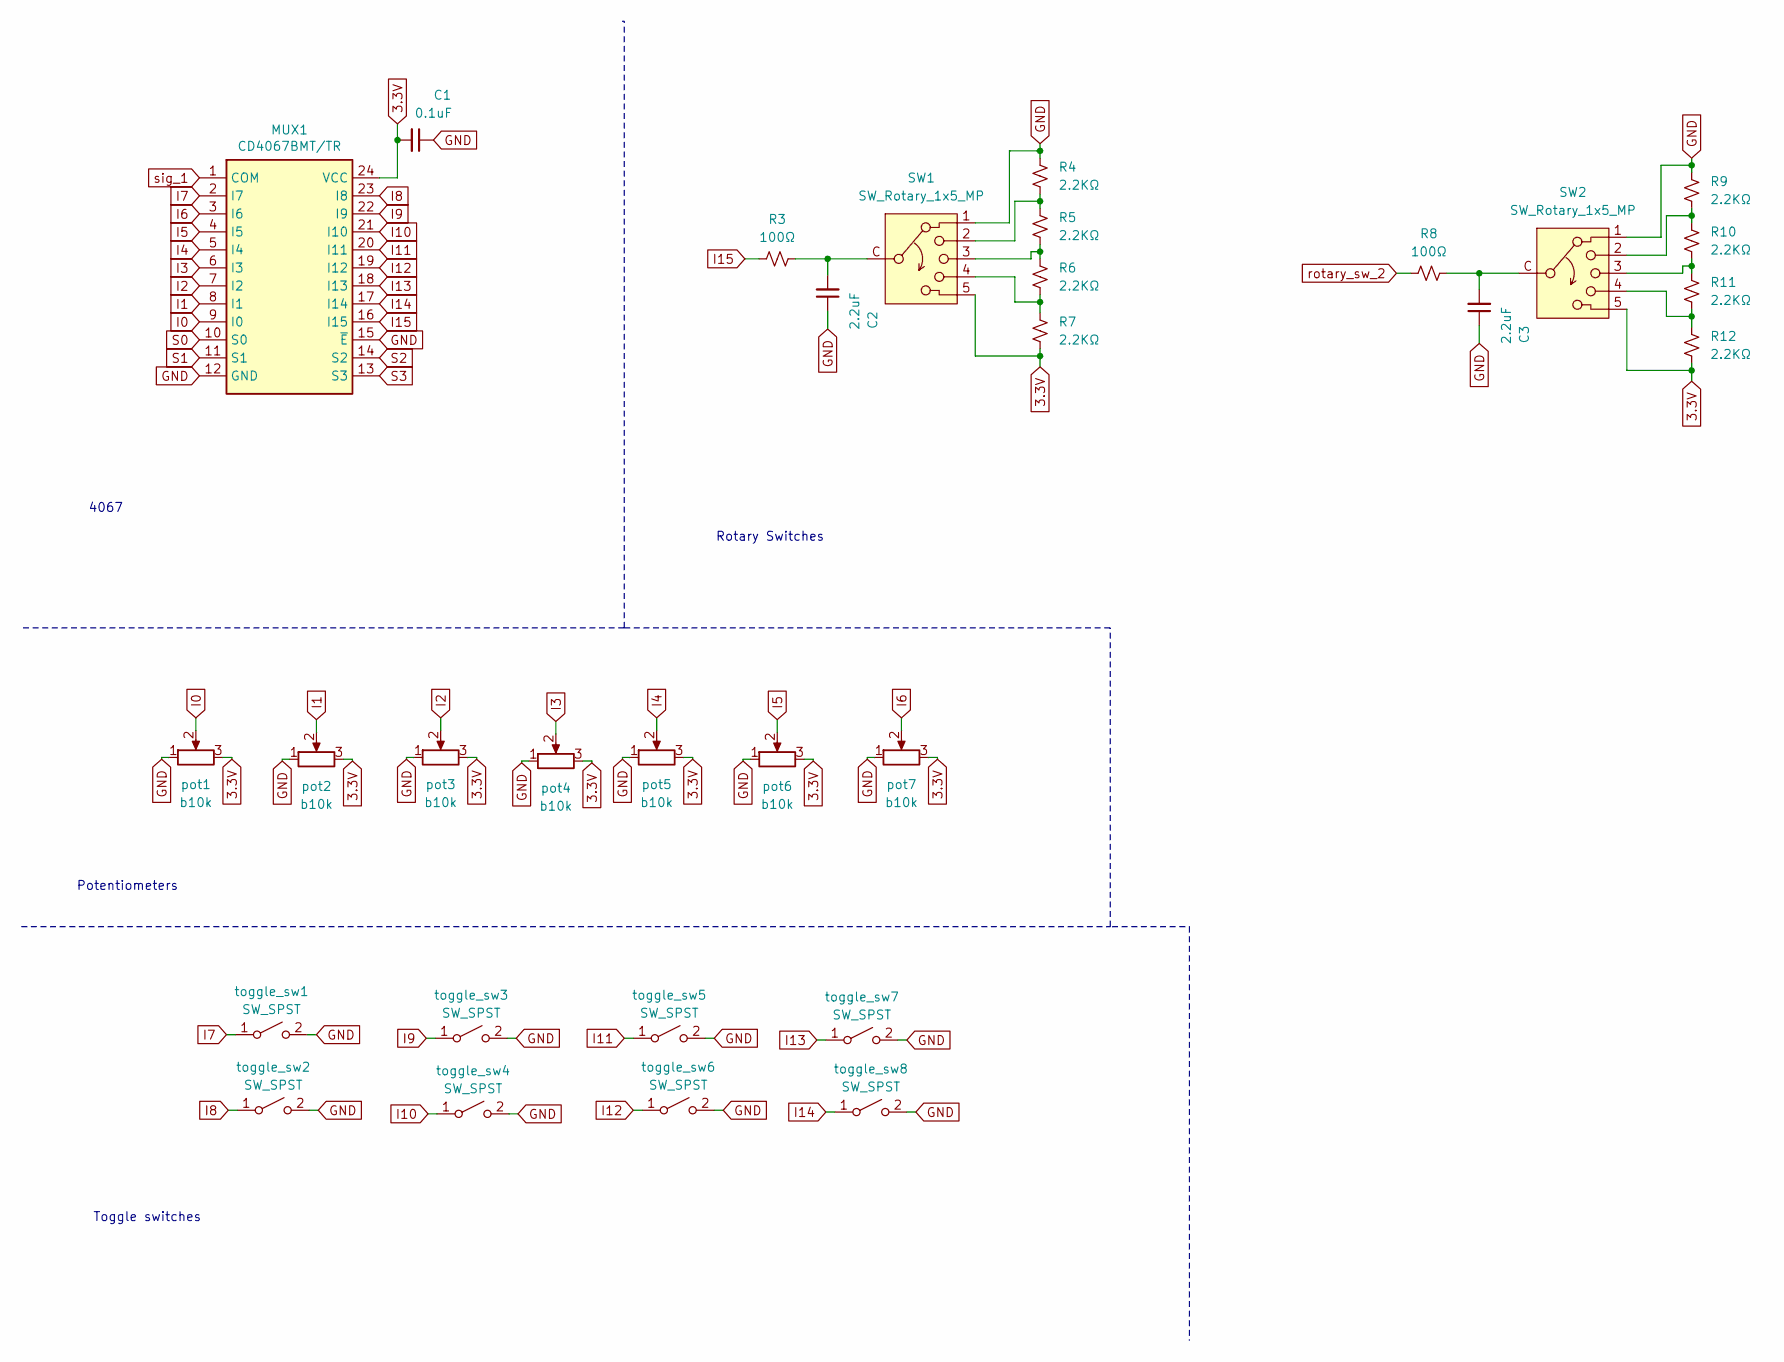
[picture p63: schematic multiplexers.kicad_sch]

Parts:
C1: 0.1uF; C_0402_1005Metric; LCSC Part Number C14663
C2, C3: 2.2uF; C_0402_1005Metric; LCSC Part Number C12530
MUX1: CD4067BMT/TR; TSSOP-24_4.4x7.8mm_P0.65mm; LCSC Part Number C7432333
R3, R8: 100Ω; R_0402_1005Metric; LCSC Part Number C25076
R4, R5, R6, R7, R9, R10, R11, R12: 2.2KΩ; R_0402_1005Metric; LCSC Part Number C25879
SW1, SW2: SW_Rotary_1x5_MP; SW_Rotary_RS25-5P; Manufacturer_Part_Number RS25-16.5KQA1-1-5P(P7)-WY-WZ-V38
pot1, pot2, pot3, pot4, pot5, pot6, pot7: b10k; Potentiometer_Alps_RK09K_Single_Vertical
toggle_sw1, toggle_sw2, toggle_sw3, toggle_sw4, toggle_sw5, toggle_sw6, toggle_sw7, toggle_sw8: SW_SPST; Toggle_Switch-2-pins

Connections:
3.3V: C1.2, MUX1.24 (VCC), R7.1, R12.1, SW1.5, SW2.5, pot1.3, pot2.3, pot3.3, pot4.3, pot5.3, pot6.3, pot7.3; also elsewhere on the board
GND: C1.1, C2.1, C3.1, MUX1.12 (GND), MUX1.15 (~E), R4.2, R9.2, SW1.1, SW2.1, pot1.1, pot2.1, pot3.1, pot4.1, pot5.1, pot6.1, pot7.1, toggle_sw1.2 (B), toggle_sw2.2 (B), toggle_sw3.2 (B), toggle_sw4.2 (B), toggle_sw5.2 (B), toggle_sw6.2 (B), toggle_sw7.2 (B), toggle_sw8.2 (B); also elsewhere on the board
I0: MUX1.9 (I0), pot1.2
I1: MUX1.8 (I1), pot2.2
I2: MUX1.7 (I2), pot3.2
I3: MUX1.6 (I3), pot4.2
I4: MUX1.5 (I4), pot5.2
I5: MUX1.4 (I5), pot6.2
I6: MUX1.3 (I6), pot7.2
I7: MUX1.2 (I7), toggle_sw1.1 (A)
I8: MUX1.23 (I8), toggle_sw2.1 (A)
I9: MUX1.22 (I9), toggle_sw3.1 (A)
I10: MUX1.21 (I10), toggle_sw4.1 (A)
I11: MUX1.20 (I11), toggle_sw5.1 (A)
I12: MUX1.19 (I12), toggle_sw6.1 (A)
I13: MUX1.18 (I13), toggle_sw7.1 (A)
I14: MUX1.17 (I14), toggle_sw8.1 (A)
I15: MUX1.16 (I15), R3.1
unnamed: C2.2, R3.2, SW1.C
unnamed: C3.2, R8.2, SW2.C
unnamed: R4.1, R5.2, SW1.2
unnamed: R5.1, R6.2, SW1.3
unnamed: R6.1, R7.2, SW1.4
unnamed: R10.1, R11.2, SW2.3
unnamed: R9.1, R10.2, SW2.2
unnamed: R11.1, R12.2, SW2.4
S0: MUX1.10 (S0); also elsewhere on the board
S1: MUX1.11 (S1); also elsewhere on the board
S2: MUX1.14 (S2); also elsewhere on the board
S3: MUX1.13 (S3); also elsewhere on the board
rotary_sw_2: R8.1; also elsewhere on the board
sig_1: MUX1.1 (COM); also elsewhere on the board

Notes on the sheet:
4067
Toggle switches
Potentiometers
Rotary Switches

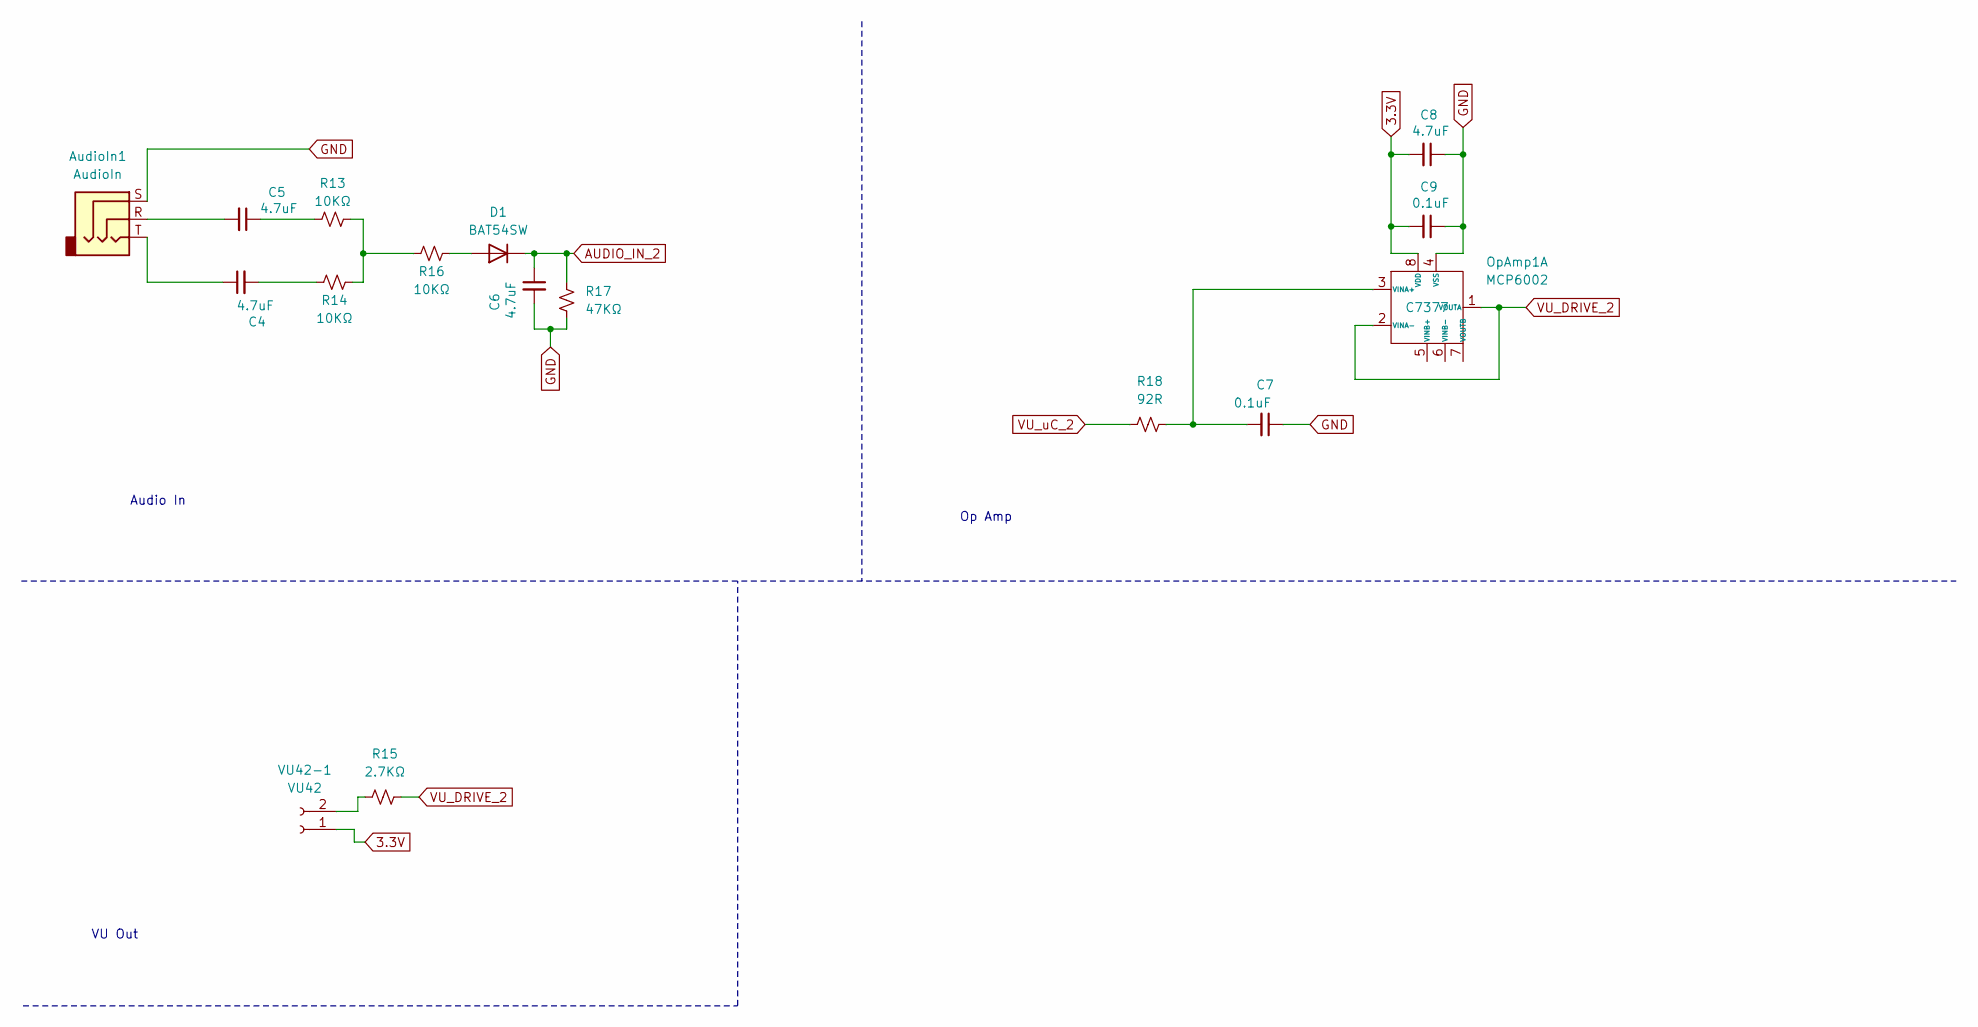
[picture p64: schematic VU42_2.kicad_sch]

Parts:
AudioIn1: AudioIn; Jack_3.5mm_PJ320D_Horizontal; LCSC Part Number C22459515
C4, C5, C6, C8: 4.7uF; C_0402_1005Metric; LCSC Part Number C23733
C7: 0.1uF; C_0402_1005Metric
C9: 0.1uF; C_0402_1005Metric; LCSC Part Number C1525
D1: BAT54SW; D_SOD-323; LCSC Part Number C27636114
OpAmp1: MCP6002; SOIC-8_3.9x4.9mm_P1.27mm; LCSC Part Number C7377
R13, R14, R16: 10KΩ; R_0402_1005Metric; LCSC Part Number C25744
R15: 2.7KΩ; R_0603_1608Metric; LCSC Part Number C13167
R17: 47KΩ; R_0402_1005Metric; LCSC Part Number C25792
R18: 92R; R_0402_1005Metric
VU42-1: VU42; PinSocket_1x02_P2.54mm_Vertical

Connections:
3.3V: C8.2, C9.2, OpAmp1.8 (VDD), VU42-1.1; also elsewhere on the board
AUDIO_IN_2: C6.1, D1.1 (K), R17.2; also elsewhere on the board
GND: AudioIn1.S, C6.2, C7.1, C8.1, C9.1, OpAmp1.4 (VSS), R17.1; also elsewhere on the board
unnamed: AudioIn1.R, C5.2
unnamed: AudioIn1.T, C4.1
unnamed: C4.2, R14.2
unnamed: C5.1, R13.2
unnamed: D1.2 (A), R16.1
unnamed: C7.2, OpAmp1.3 (VINA+), R18.1
unnamed: R13.1, R14.1, R16.2
unnamed: R15.2, VU42-1.2
VU_DRIVE_2: OpAmp1.1 (VOUTA), OpAmp1.2 (VINA-), R15.1
VU_uC_2: R18.2; also elsewhere on the board

Notes on the sheet:
VU Out
Op Amp
Audio In

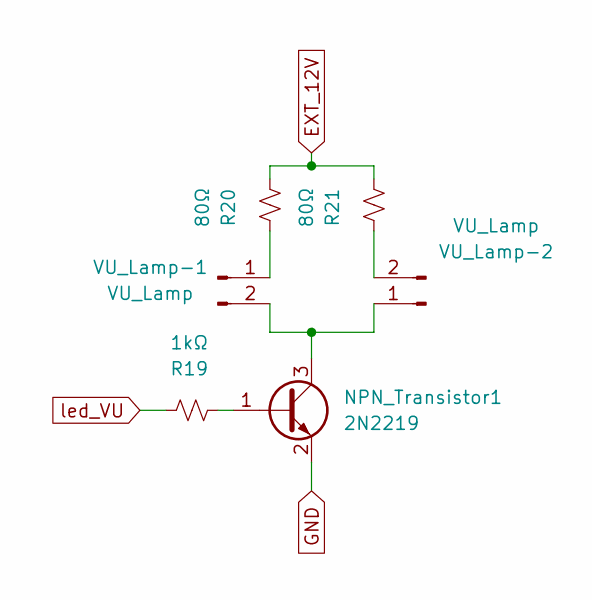
[picture p65: schematic VU42_lamp_2.kicad_sch]

Parts:
NPN_Transistor1: 2N2219; SOT-23; LCSC Part Number C2150
R19: 1kΩ; R_0402_1005Metric; Manufacturer_Part_Number 0402WGF3300TCE; LCSC Part Number C11702
R20, R21: 80Ω; R_0402_1005Metric; Manufacturer_Part_Number RT0402FRE0780RL; LCSC Part Number C854436
VU_Lamp-1, VU_Lamp-2: VU_Lamp; PinSocket_1x02_P2.54mm_Vertical

Connections:
EXT_12V: R20.1, R21.1; also elsewhere on the board
GND: NPN_Transistor1.2 (E); also elsewhere on the board
unnamed: NPN_Transistor1.1 (B), R19.1
unnamed: NPN_Transistor1.3 (C), VU_Lamp-1.2, VU_Lamp-2.1
unnamed: R20.2, VU_Lamp-1.1
unnamed: R21.2, VU_Lamp-2.2
led_VU: R19.2; also elsewhere on the board

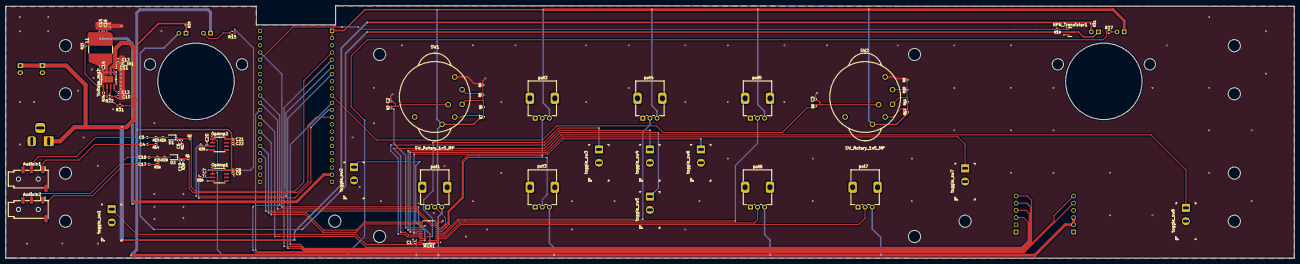
[picture p66: board Manley-VS-MU.kicad_pcb from above]

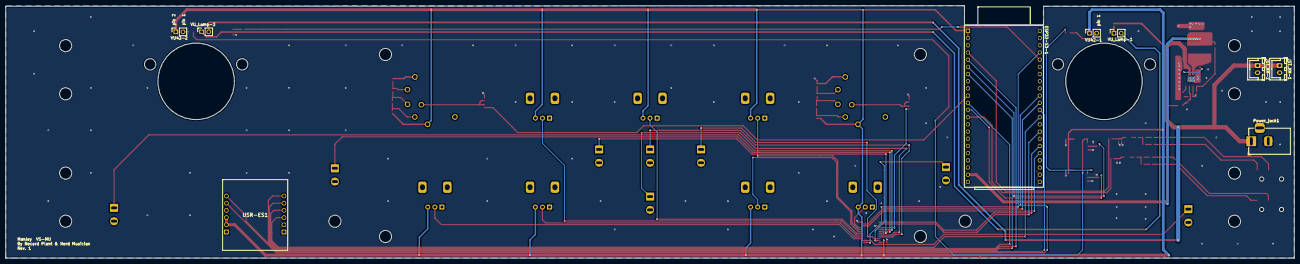
[picture p67: board Manley-VS-MU.kicad_pcb from below]

Board: 2 copper layers, 455.0 x 89.1 mm, 90 parts (9 on the bottom side), 76 nets.
