eSpark-Backup/patrizio-moi-pcb-fixes/Client-Files/19 - SSL FXG384 - 19-June-2025/SSL FXG384.kicad_pcb

## KiCad design Client-Files/19 - SSL FXG384 - 19-June-2025/SSL FXG384.kicad_pcb (2025-07-31)

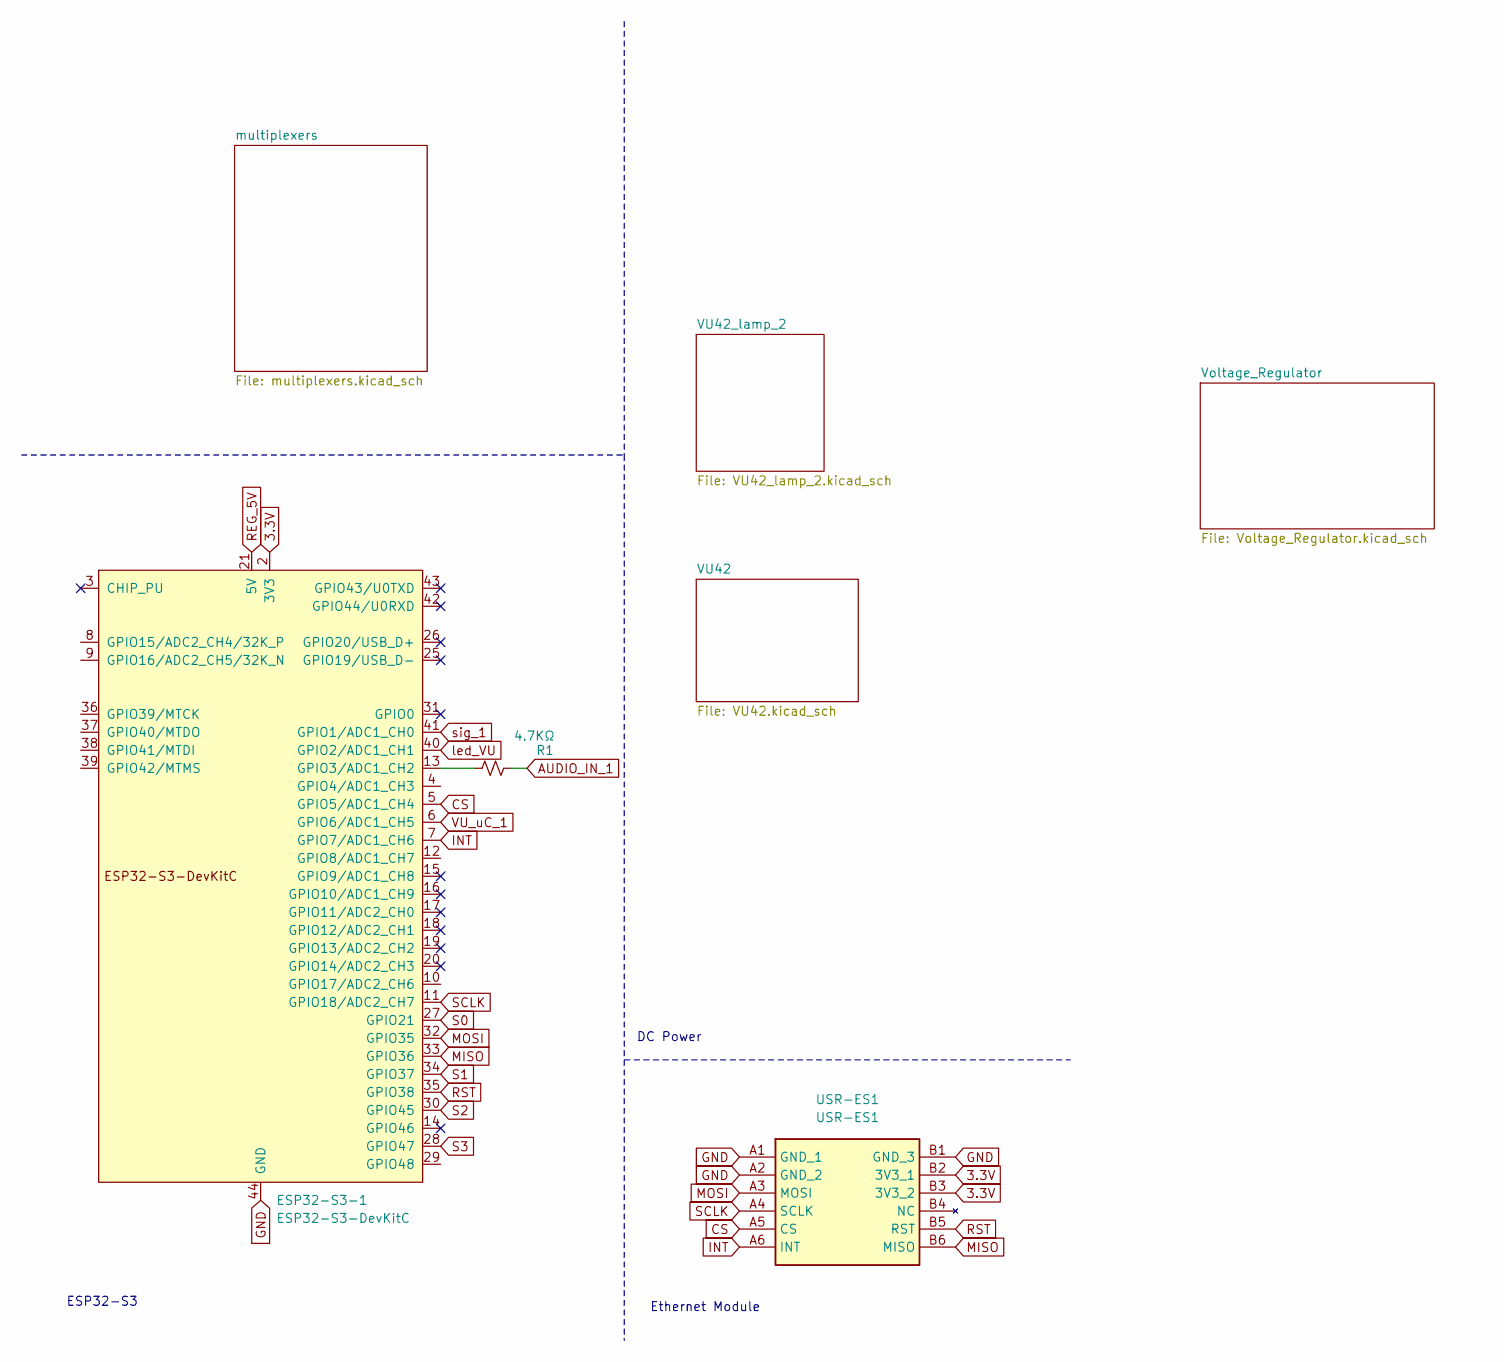
[picture p68: schematic SSL FXG384.kicad_sch]

Parts:
ESP32-S3-1: ESP32-S3-DevKitC; ESP32-S3-DEVKITC-1-N8R2-2
R1: 4.7KΩ; R_0402_1005Metric; LCSC Part Number C25900
USR-ES1: USR-ES1; USRES1; Manufacturer_Part_Number USR-ES1

Connections:
3.3V: ESP32-S3-1.1 (3V3), ESP32-S3-1.2 (3V3), USR-ES1.B2 (3V3_1), USR-ES1.B3 (3V3_2); also elsewhere on the board
AUDIO_IN_1: R1.1; also elsewhere on the board
CS: ESP32-S3-1.5 (GPIO5/ADC1_CH4), USR-ES1.A5 (CS)
GND: ESP32-S3-1.22 (GND), ESP32-S3-1.23 (GND), ESP32-S3-1.24 (GND), ESP32-S3-1.44 (GND), USR-ES1.A1 (GND_1), USR-ES1.A2 (GND_2), USR-ES1.B1 (GND_3); also elsewhere on the board
INT: ESP32-S3-1.7 (GPIO7/ADC1_CH6), USR-ES1.A6 (INT)
MISO: ESP32-S3-1.33 (GPIO36), USR-ES1.B6 (MISO)
MOSI: ESP32-S3-1.32 (GPIO35), USR-ES1.A3 (MOSI)
unnamed: ESP32-S3-1.13 (GPIO3/ADC1_CH2), R1.2
REG_5V: ESP32-S3-1.21 (5V); also elsewhere on the board
RST: ESP32-S3-1.35 (GPIO38), USR-ES1.B5 (RST)
S0: ESP32-S3-1.27 (GPIO21); also elsewhere on the board
S1: ESP32-S3-1.34 (GPIO37); also elsewhere on the board
S2: ESP32-S3-1.30 (GPIO45); also elsewhere on the board
S3: ESP32-S3-1.28 (GPIO47); also elsewhere on the board
SCLK: ESP32-S3-1.11 (GPIO18/ADC2_CH7), USR-ES1.A4 (SCLK)
VU_uC_1: ESP32-S3-1.6 (GPIO6/ADC1_CH5); also elsewhere on the board
led_VU: ESP32-S3-1.40 (GPIO2/ADC1_CH1); also elsewhere on the board
sig_1: ESP32-S3-1.41 (GPIO1/ADC1_CH0); also elsewhere on the board

Notes on the sheet:
Ethernet Module
DC Power
ESP32-S3

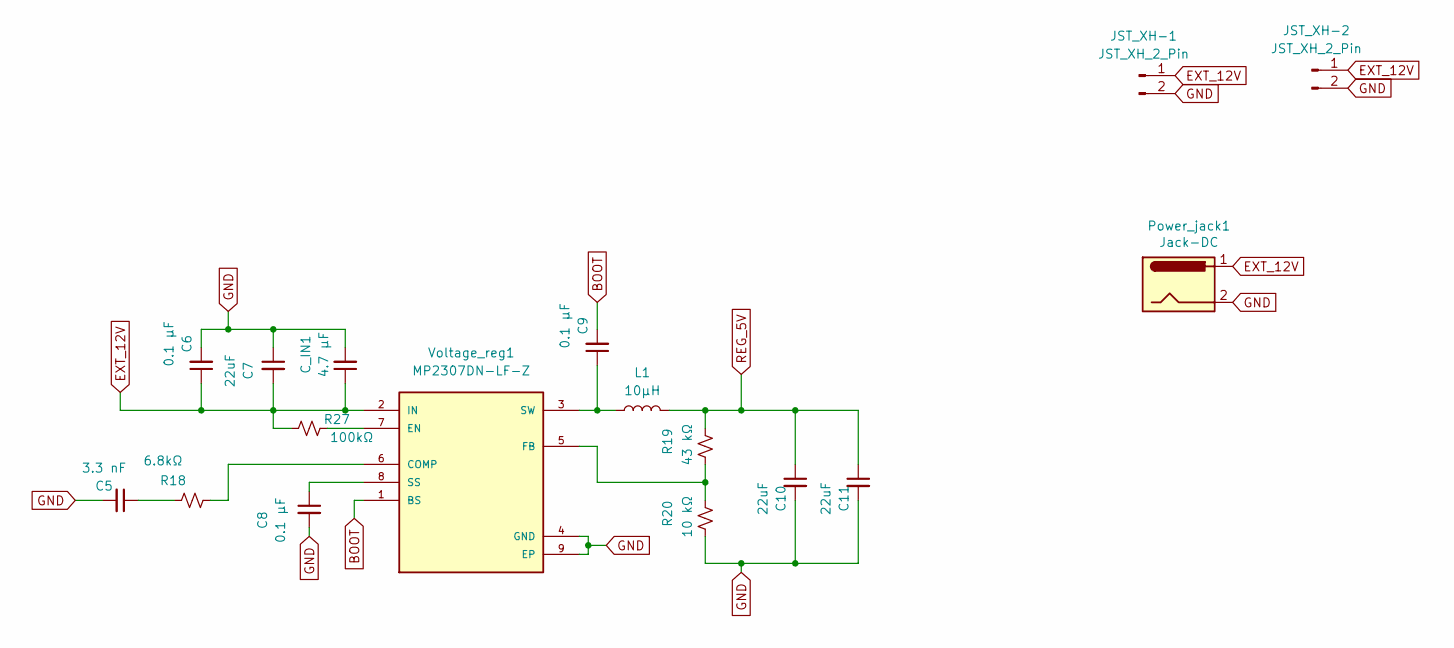
[picture p69: schematic Voltage_Regulator.kicad_sch]

Parts:
C5: 3.3 nF; C_0603_1608Metric; LCSC Part Number C1613
C6, C8, C9: 0.1 µF; C_0402_1005Metric; LCSC Part Number C1525
C7, C10, C11: 22uF; C_0603_1608Metric; LCSC Part Number C59461
C_IN1: 4.7 µF; C_0402_1005Metric; LCSC Part Number C23733
JST_XH-1, JST_XH-2: JST_XH_2_Pin; JST_XH_B2B-XH-A_1x02_P2.50mm_Vertical
L1: 10µH; L_Bourns-SRN8040_8x8.15mm; LCSC Part Number C37429
Power_jack1: Jack-DC; BarrelJack_Horizontal
R18: 6.8kΩ; R_0603_1608Metric; LCSC Part Number C23212
R19: 43 kΩ; R_0402_1005Metric; LCSC Part Number C2906943
R20: 10 kΩ; R_0402_1005Metric; LCSC Part Number C25744
R27: 100kΩ; R_0603_1608Metric
Voltage_reg1: MP2307DN-LF-Z; SOIC-8-1EP_3.9x4.9mm_P1.27mm_EP2.29x3mm_ThermalVias; PARTREV 1.9; LCSC Part Number C2928813

Connections:
BOOT: C9.2, Voltage_reg1.1 (BS)
EXT_12V: C6.1, C7.2, C_IN1.1, JST_XH-1.1, JST_XH-2.1, Power_jack1.1, R27.1, Voltage_reg1.2 (IN); also elsewhere on the board
GND: C5.2, C6.2, C7.1, C8.2, C10.2, C11.2, C_IN1.2, JST_XH-1.2, JST_XH-2.2, Power_jack1.2, R20.2, Voltage_reg1.4 (GND), Voltage_reg1.9 (EP); also elsewhere on the board
unnamed: C5.1, R18.1
unnamed: R18.2, Voltage_reg1.6 (COMP)
unnamed: R27.2, Voltage_reg1.7 (EN)
unnamed: R19.2, R20.1, Voltage_reg1.5 (FB)
unnamed: C8.1, Voltage_reg1.8 (SS)
unnamed: C9.1, L1.1, Voltage_reg1.3 (SW)
REG_5V: C10.1, C11.1, L1.2, R19.1; also elsewhere on the board
