eSpark-Backup/patrizio-moi-pcb-fixes/Client-Files/19 - SSL FXG384 - 19-June-2025/SSL FXG384.kicad_pcb

## KiCad design Client-Files/19 - SSL FXG384 - 19-June-2025/SSL FXG384.kicad_pcb (continued)

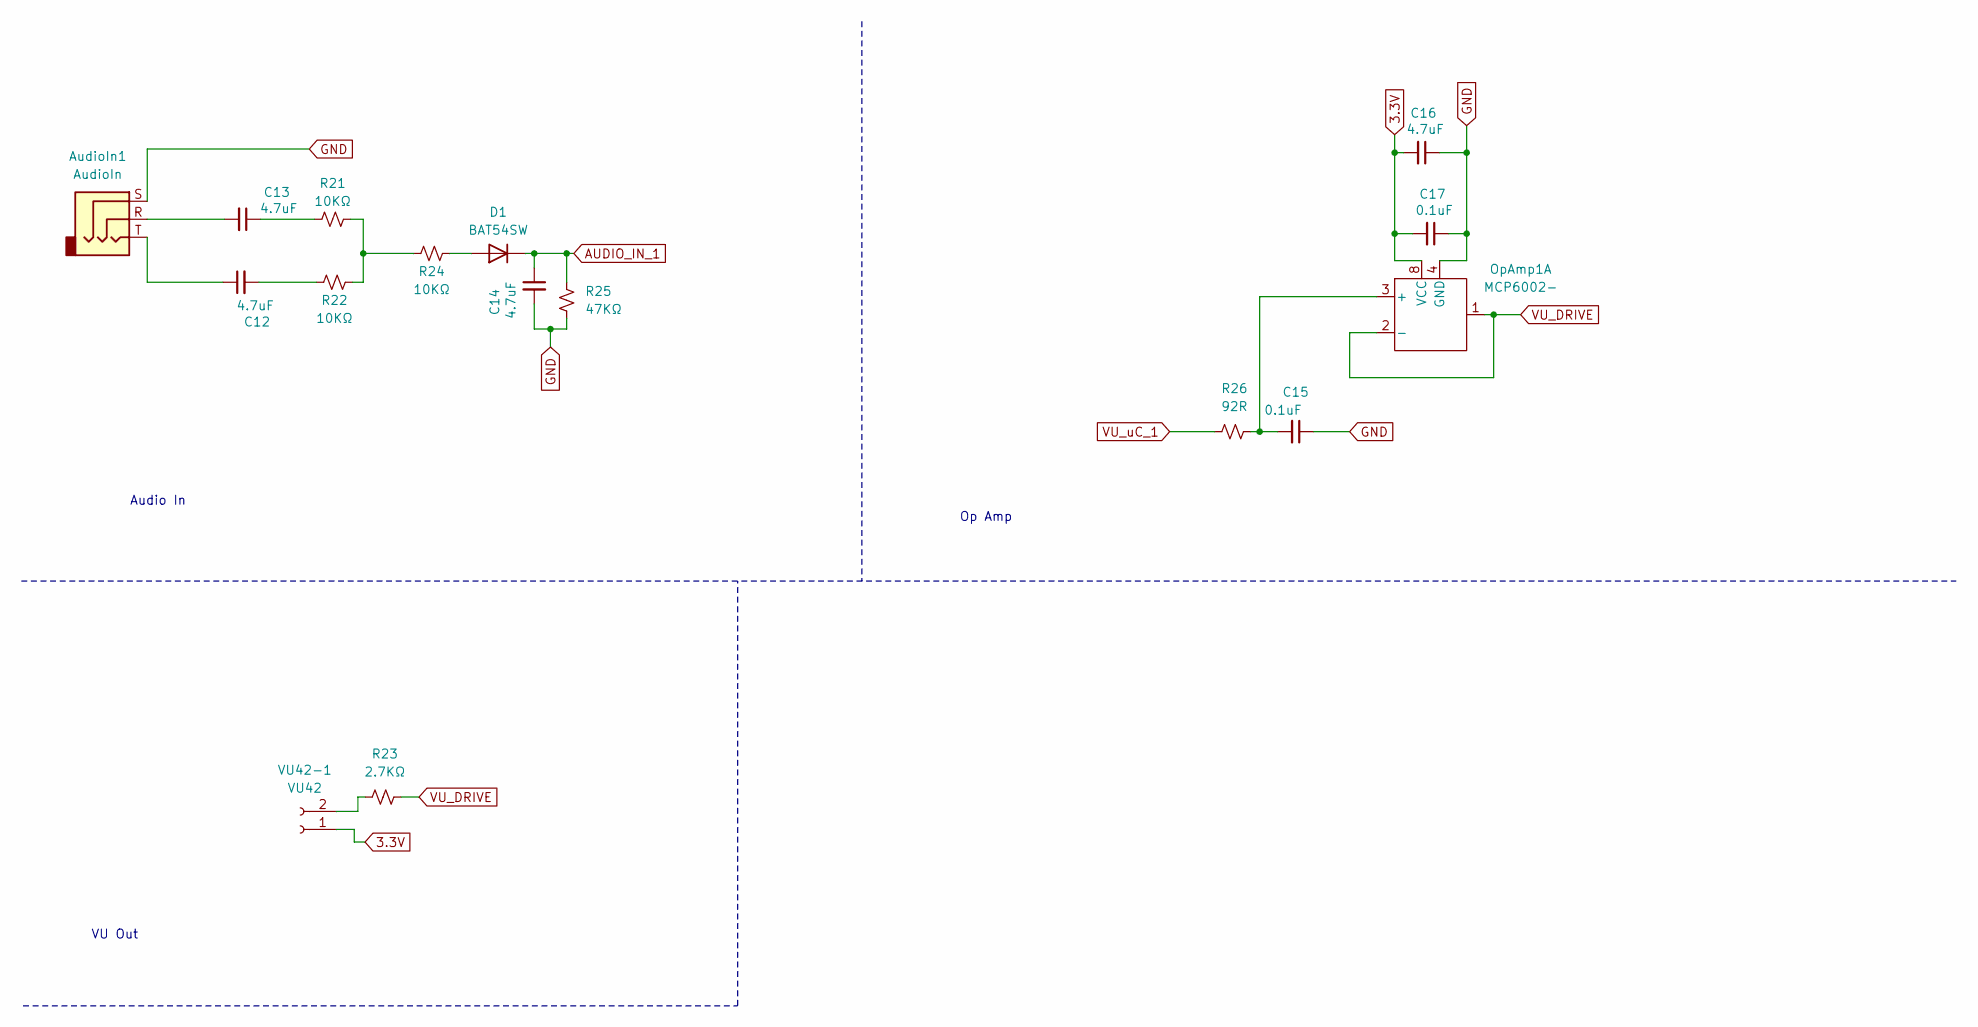
[picture p70: schematic VU42.kicad_sch]

Parts:
AudioIn1: AudioIn; Jack_3.5mm_PJ320D_Horizontal; LCSC Part Number C22459515
C12, C13, C14, C16: 4.7uF; C_0402_1005Metric; LCSC Part Number C23733
C15: 0.1uF; C_0402_1005Metric
C17: 0.1uF; C_0402_1005Metric; LCSC Part Number C1525
D1: BAT54SW; D_SOD-323; LCSC Part Number C27636114
OpAmp1: MCP6002-; SOIC-8_3.9x4.9mm_P1.27mm; LCSC Part Number C7377
R21, R22, R24: 10KΩ; R_0402_1005Metric; LCSC Part Number C25744
R23: 2.7KΩ; R_0603_1608Metric; LCSC Part Number C13167
R25: 47KΩ; R_0402_1005Metric; LCSC Part Number C25792
R26: 92R; R_0402_1005Metric
VU42-1: VU42; PinSocket_1x02_P2.54mm_Vertical

Connections:
3.3V: C16.2, C17.2, OpAmp1.8 (VCC), VU42-1.1; also elsewhere on the board
AUDIO_IN_1: C14.1, D1.1 (K), R25.2; also elsewhere on the board
GND: AudioIn1.S, C14.2, C15.1, C16.1, C17.1, OpAmp1.4 (GND), R25.1; also elsewhere on the board
unnamed: AudioIn1.R, C13.2
unnamed: AudioIn1.T, C12.1
unnamed: C12.2, R22.2
unnamed: C13.1, R21.2
unnamed: D1.2 (A), R24.1
unnamed: C15.2, OpAmp1.3 (+), R26.1
unnamed: R21.1, R22.1, R24.2
unnamed: R23.2, VU42-1.2
VU_DRIVE: OpAmp1.1, OpAmp1.2 (-), R23.1
VU_uC_1: R26.2; also elsewhere on the board

Notes on the sheet:
VU Out
Op Amp
Audio In

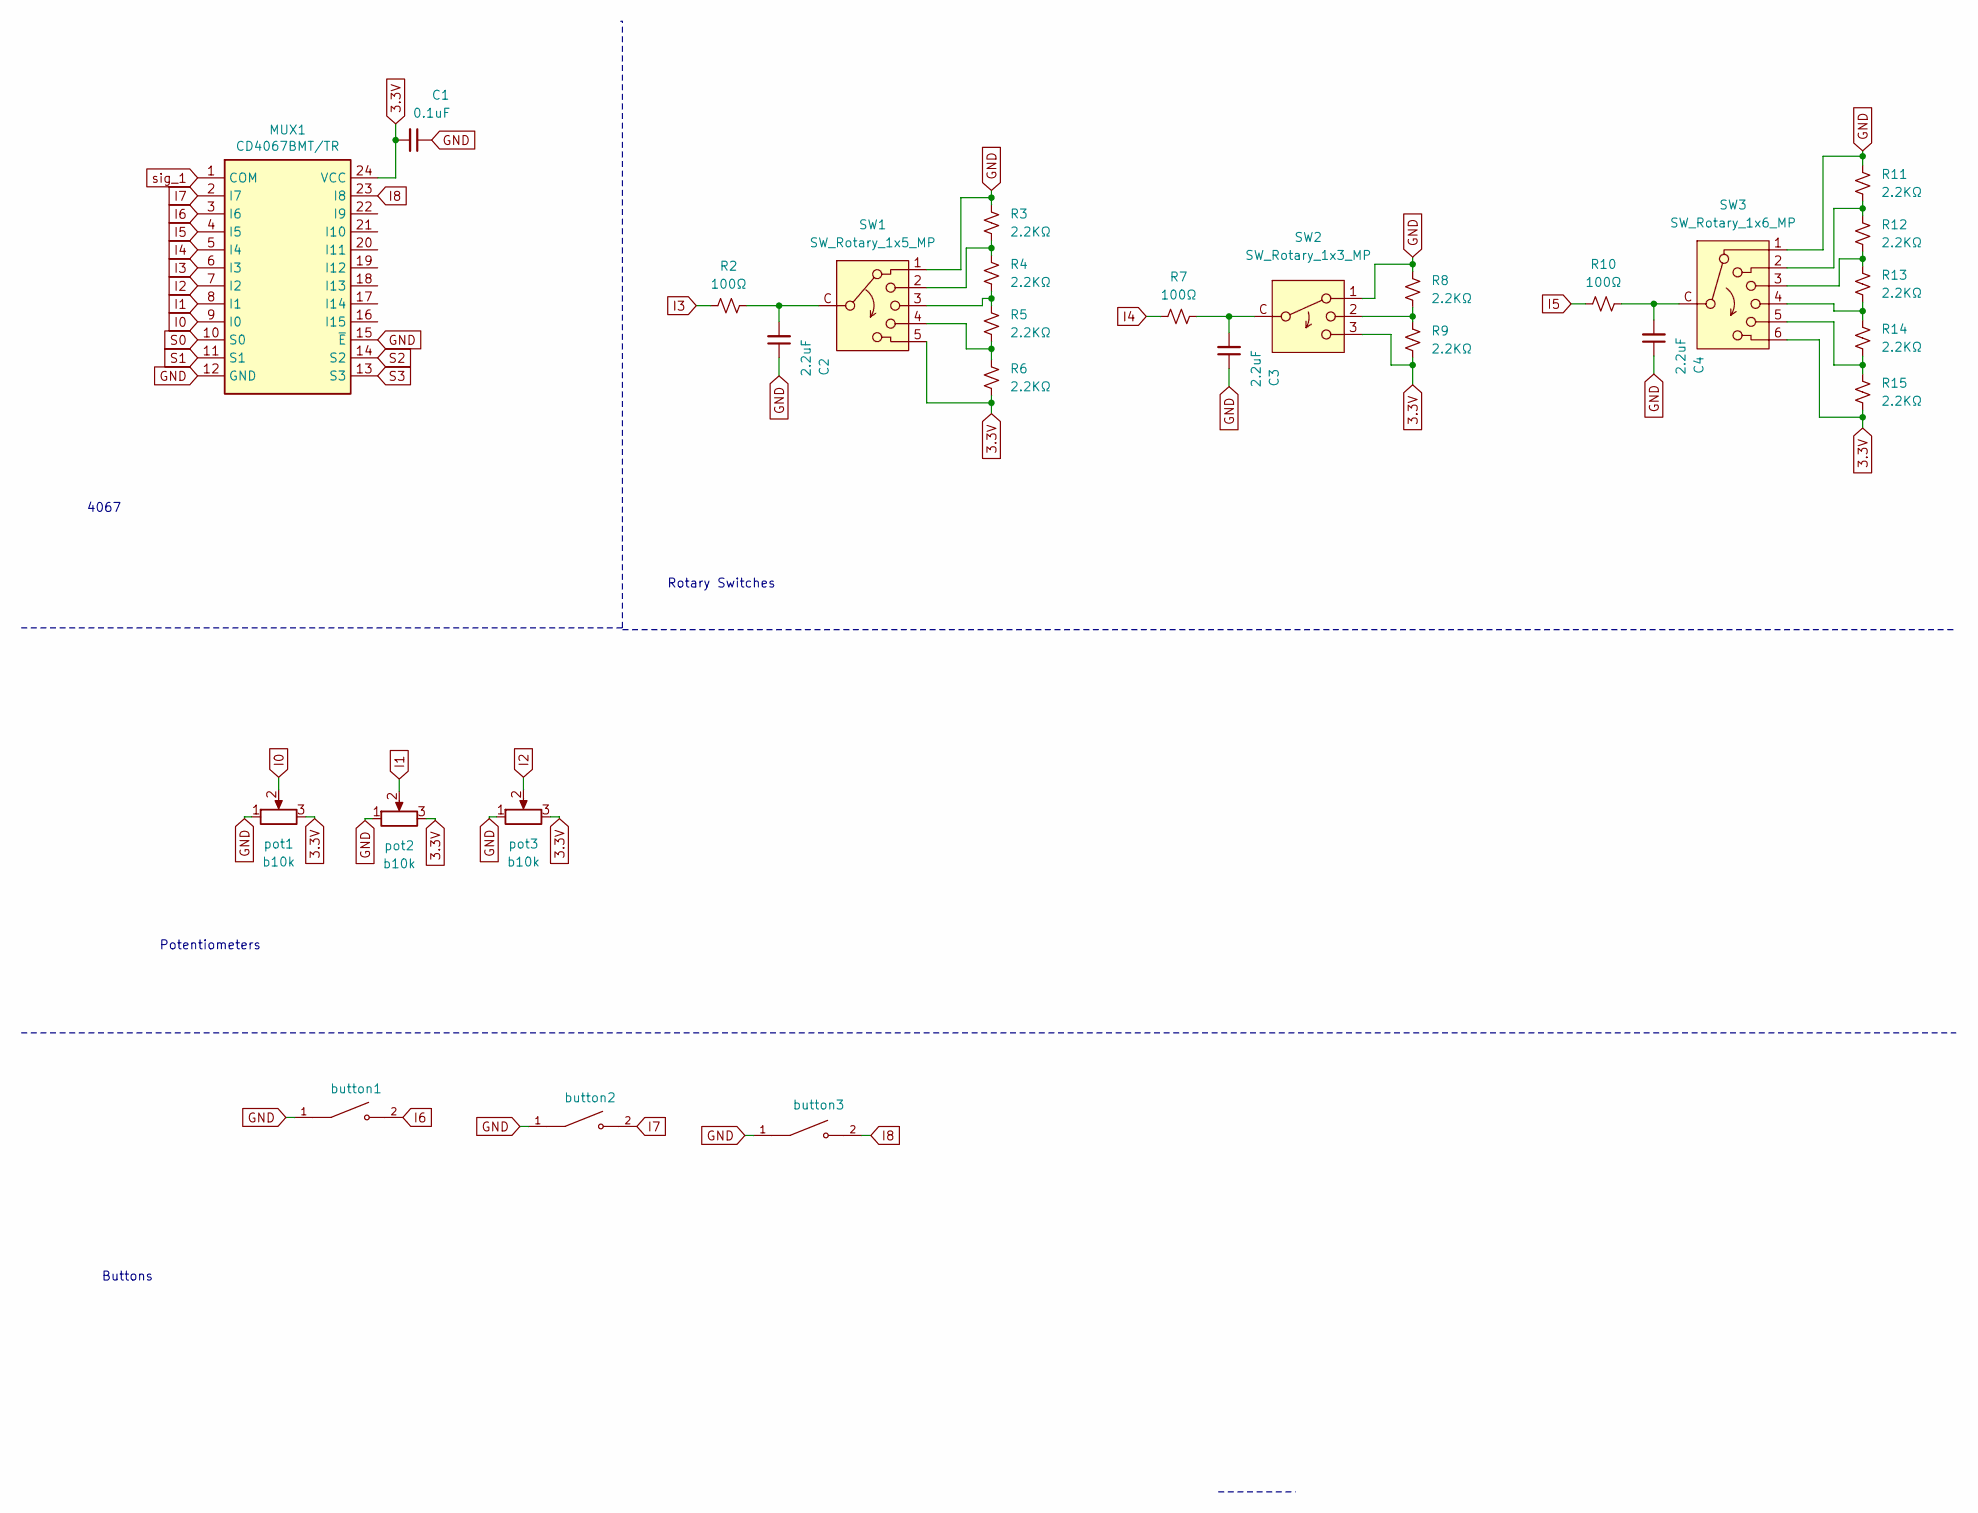
[picture p71: schematic multiplexers.kicad_sch]

Parts:
C1: 0.1uF; C_0402_1005Metric; LCSC Part Number C14663
C2, C3, C4: 2.2uF; C_0402_1005Metric; LCSC Part Number C12530
MUX1: CD4067BMT/TR; TSSOP-24_4.4x7.8mm_P0.65mm; LCSC Part Number C7432333
R2, R7, R10: 100Ω; R_0402_1005Metric; LCSC Part Number C25076
R3, R4, R5, R6, R8, R9, R11, R12, R13, R14, R15: 2.2KΩ; R_0402_1005Metric; LCSC Part Number C25879
SW1: SW_Rotary_1x5_MP; SW_Rotary_RS25-5P
SW2: SW_Rotary_1x3_MP; SW_Rotary_RS25-3P
SW3: SW_Rotary_1x6_MP; SW_Rotary_RS25-6P
button1, button2, button3: bttn; SW_TL2285EE; PARTREV B
pot1, pot2, pot3: b10k; Potentiometer_Alps_RK09K_Single_Vertical

Connections:
3.3V: C1.2, MUX1.24 (VCC), R6.1, R9.1, R15.1, SW1.5, SW2.3, SW3.6, pot1.3, pot2.3, pot3.3; also elsewhere on the board
GND: C1.1, C2.1, C3.1, C4.1, MUX1.12 (GND), MUX1.15 (~E), R3.2, R8.2, R11.2, SW1.1, SW2.1, SW3.1, button1.1, button2.1, button3.1, pot1.1, pot2.1, pot3.1; also elsewhere on the board
I0: MUX1.9 (I0), pot1.2
I1: MUX1.8 (I1), pot2.2
I2: MUX1.7 (I2), pot3.2
I3: MUX1.6 (I3), R2.1
I4: MUX1.5 (I4), R7.1
I5: MUX1.4 (I5), R10.1
I6: MUX1.3 (I6), button1.2
I7: MUX1.2 (I7), button2.2
I8: MUX1.23 (I8), button3.2
unnamed: C2.2, R2.2, SW1.C
unnamed: C3.2, R7.2, SW2.C
unnamed: C4.2, R10.2, SW3.C
unnamed: R3.1, R4.2, SW1.2
unnamed: R4.1, R5.2, SW1.3
unnamed: R5.1, R6.2, SW1.4
unnamed: R8.1, R9.2, SW2.2
unnamed: R11.1, R12.2, SW3.2
unnamed: R12.1, R13.2, SW3.3
unnamed: R13.1, R14.2, SW3.4
unnamed: R14.1, R15.2, SW3.5
S0: MUX1.10 (S0); also elsewhere on the board
S1: MUX1.11 (S1); also elsewhere on the board
S2: MUX1.14 (S2); also elsewhere on the board
S3: MUX1.13 (S3); also elsewhere on the board
sig_1: MUX1.1 (COM); also elsewhere on the board

Notes on the sheet:
4067
Potentiometers
Buttons
Rotary Switches

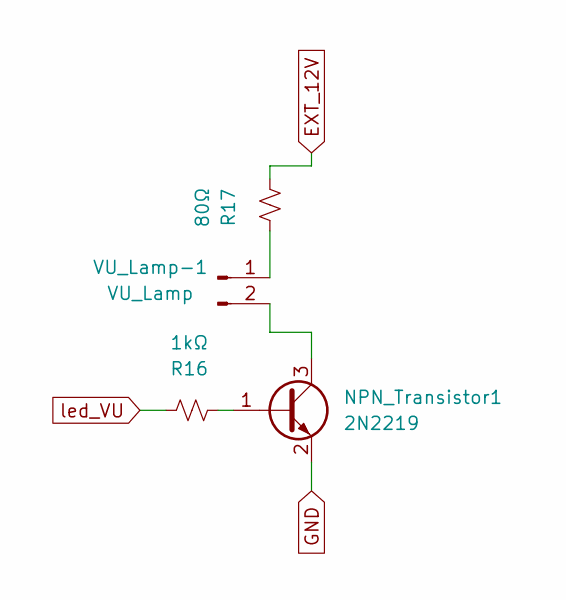
[picture p72: schematic VU42_lamp_2.kicad_sch]

Parts:
NPN_Transistor1: 2N2219; SOT-23; LCSC Part Number C2150
R16: 1kΩ; R_0402_1005Metric; Manufacturer_Part_Number 0402WGF3300TCE; LCSC Part Number C11702
R17: 80Ω; R_0402_1005Metric; Manufacturer_Part_Number RT0402FRE0780RL; LCSC Part Number C854436
VU_Lamp-1: VU_Lamp; PinSocket_1x02_P2.54mm_Vertical

Connections:
EXT_12V: R17.1; also elsewhere on the board
GND: NPN_Transistor1.2 (E); also elsewhere on the board
unnamed: NPN_Transistor1.1 (B), R16.1
unnamed: NPN_Transistor1.3 (C), VU_Lamp-1.2
unnamed: R17.2, VU_Lamp-1.1
led_VU: R16.2; also elsewhere on the board

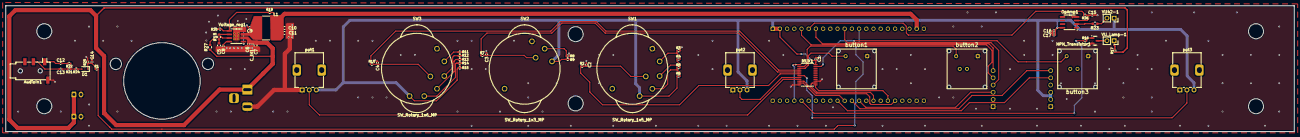
[picture p73: board SSL FXG384.kicad_pcb from above]

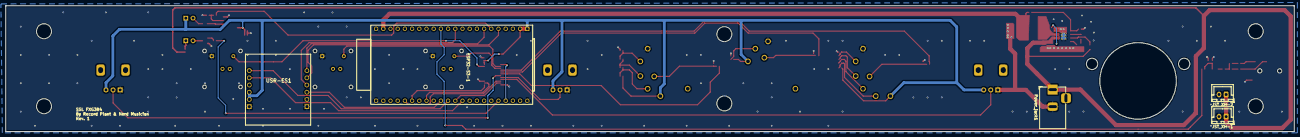
[picture p74: board SSL FXG384.kicad_pcb from below]

Board: 2 copper layers, 454.7 x 44.4 mm, 68 parts (5 on the bottom side), 58 nets.
