eSpark-Backup/patrizio-moi-pcb-fixes/Client-Files/17 - Summit EQP200B 30-JUL-2025/Design Files/Summit-EQP200B.kicad_pcb

## KiCad design Client-Files/17 - Summit EQP200B 30-JUL-2025/Design Files/Summit-EQP200B.kicad_pcb (2025-07-31)

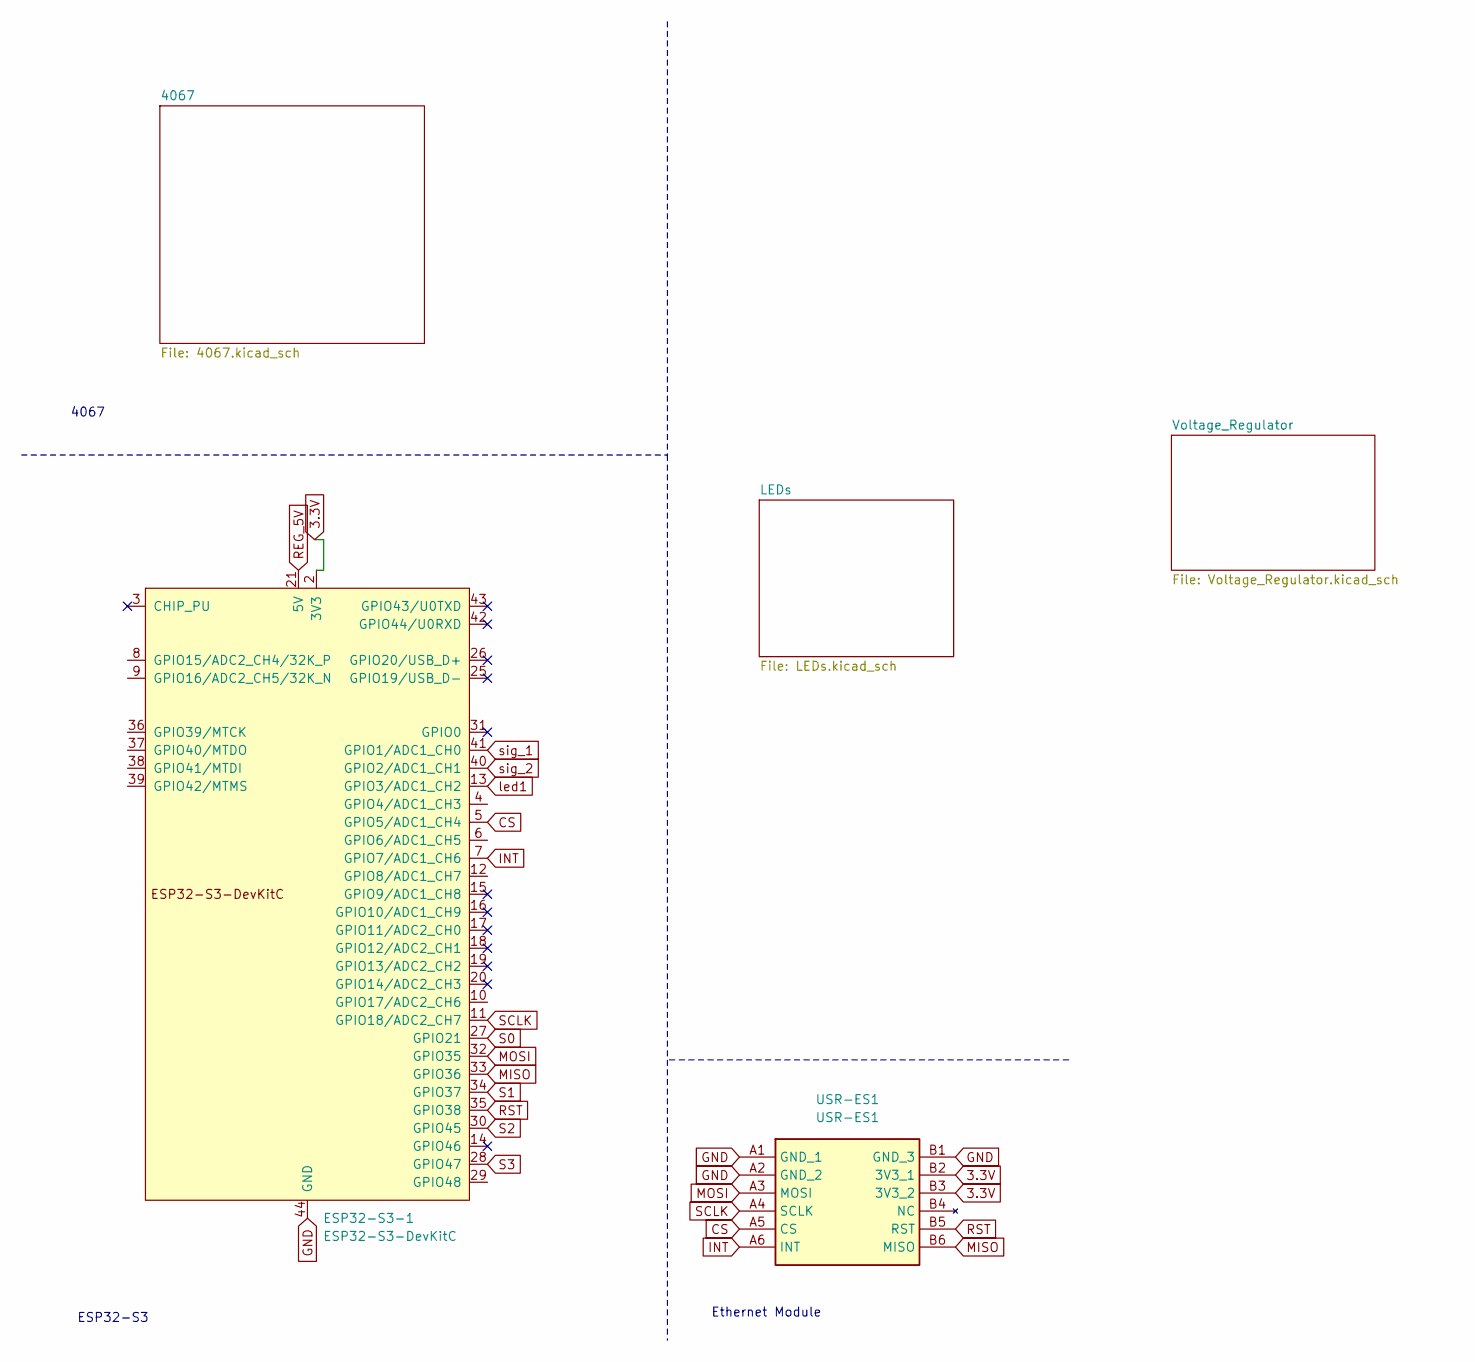
[picture p75: schematic Summit-EQP200B.kicad_sch]

Parts:
ESP32-S3-1: ESP32-S3-DevKitC; ESP32-S3-DEVKITC-1-N8R2-2
USR-ES1: USR-ES1; USRES1; Manufacturer_Part_Number USR-ES1

Connections:
3.3V: ESP32-S3-1.1 (3V3), ESP32-S3-1.2 (3V3), USR-ES1.B2 (3V3_1), USR-ES1.B3 (3V3_2); also elsewhere on the board
CS: ESP32-S3-1.5 (GPIO5/ADC1_CH4), USR-ES1.A5 (CS)
GND: ESP32-S3-1.22 (GND), ESP32-S3-1.23 (GND), ESP32-S3-1.24 (GND), ESP32-S3-1.44 (GND), USR-ES1.A1 (GND_1), USR-ES1.A2 (GND_2), USR-ES1.B1 (GND_3); also elsewhere on the board
INT: ESP32-S3-1.7 (GPIO7/ADC1_CH6), USR-ES1.A6 (INT)
MISO: ESP32-S3-1.33 (GPIO36), USR-ES1.B6 (MISO)
MOSI: ESP32-S3-1.32 (GPIO35), USR-ES1.A3 (MOSI)
REG_5V: ESP32-S3-1.21 (5V); also elsewhere on the board
RST: ESP32-S3-1.35 (GPIO38), USR-ES1.B5 (RST)
S0: ESP32-S3-1.27 (GPIO21); also elsewhere on the board
S1: ESP32-S3-1.34 (GPIO37); also elsewhere on the board
S2: ESP32-S3-1.30 (GPIO45); also elsewhere on the board
S3: ESP32-S3-1.28 (GPIO47); also elsewhere on the board
SCLK: ESP32-S3-1.11 (GPIO18/ADC2_CH7), USR-ES1.A4 (SCLK)
led1: ESP32-S3-1.13 (GPIO3/ADC1_CH2); also elsewhere on the board
sig_1: ESP32-S3-1.41 (GPIO1/ADC1_CH0); also elsewhere on the board
sig_2: ESP32-S3-1.40 (GPIO2/ADC1_CH1); also elsewhere on the board

Notes on the sheet:
Ethernet Module
ESP32-S3
4067

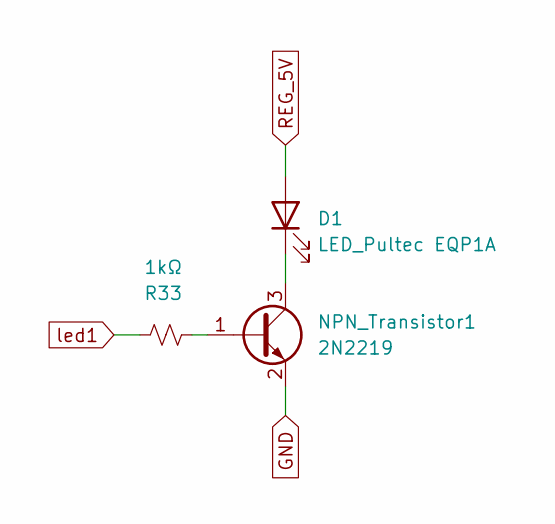
[picture p76: schematic LEDs.kicad_sch]

Parts:
D1: LED_Pultec EQP1A; LED_Pultech_1
NPN_Transistor1: 2N2219; SOT-23; LCSC Part Number C2150
R33: 1kΩ; R_0402_1005Metric; Manufacturer_Part_Number 0402WGF3300TCE; LCSC Part Number C11702

Connections:
GND: NPN_Transistor1.2 (E); also elsewhere on the board
unnamed: D1.1 (K), NPN_Transistor1.3 (C)
unnamed: NPN_Transistor1.1 (B), R33.1
REG_5V: D1.2 (A); also elsewhere on the board
led1: R33.2; also elsewhere on the board

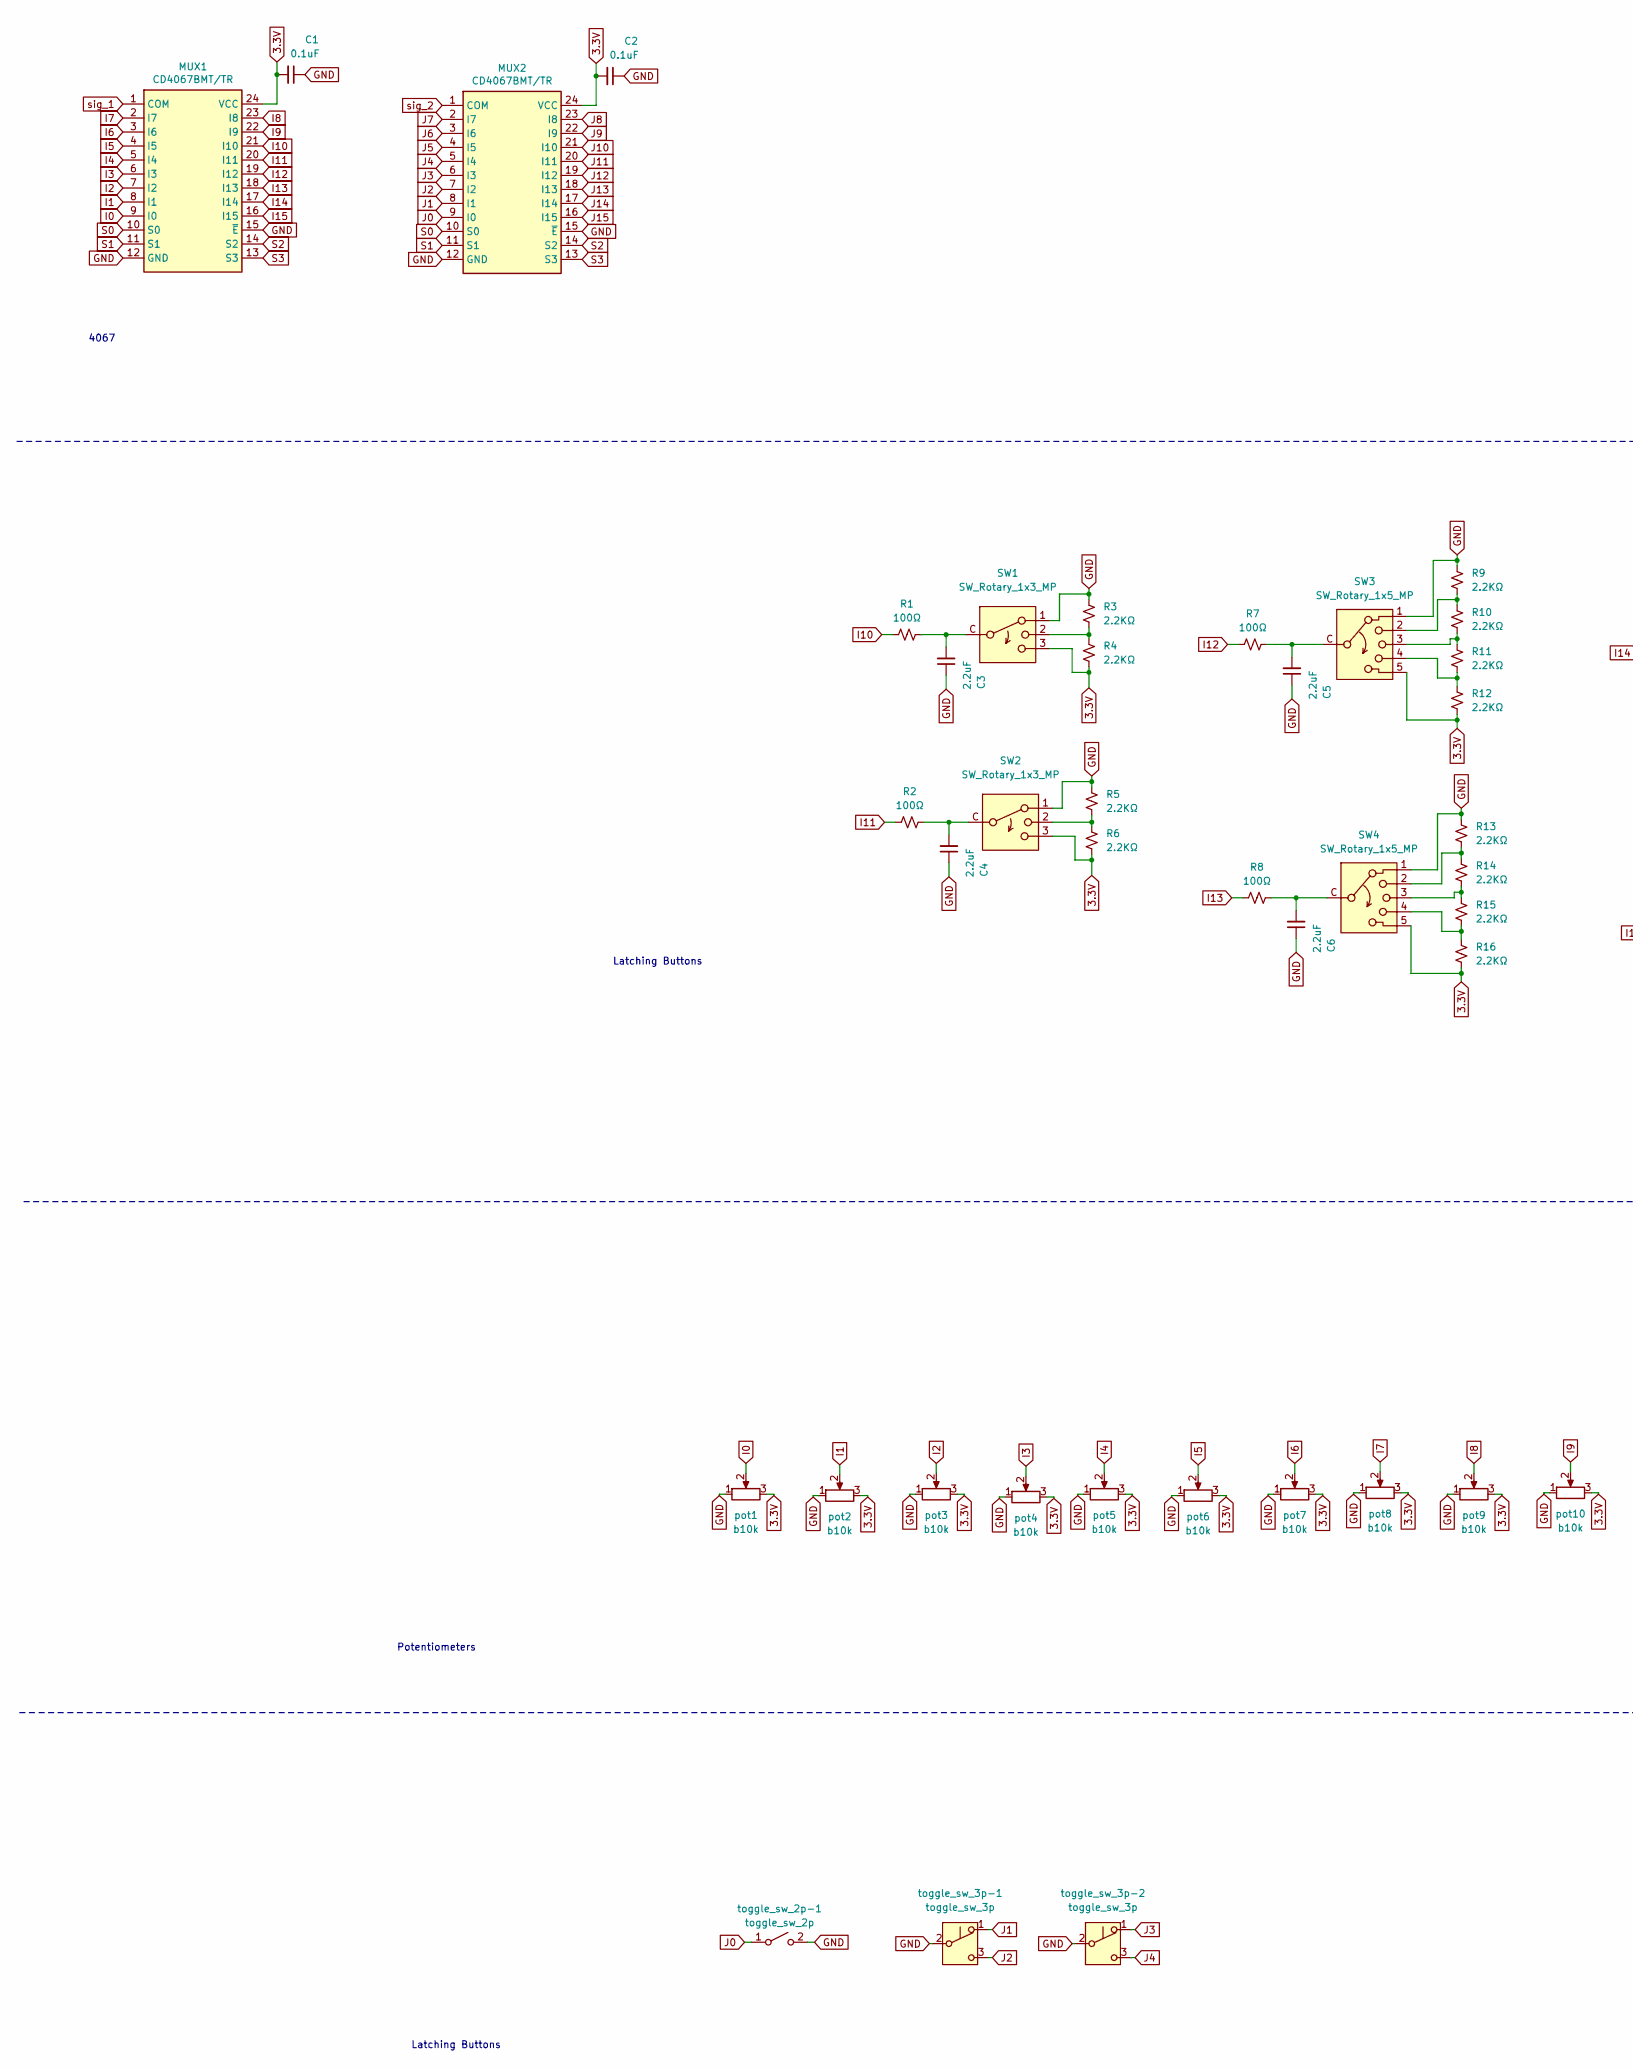
[picture p77: schematic 4067.kicad_sch, part in row 1, column 1]

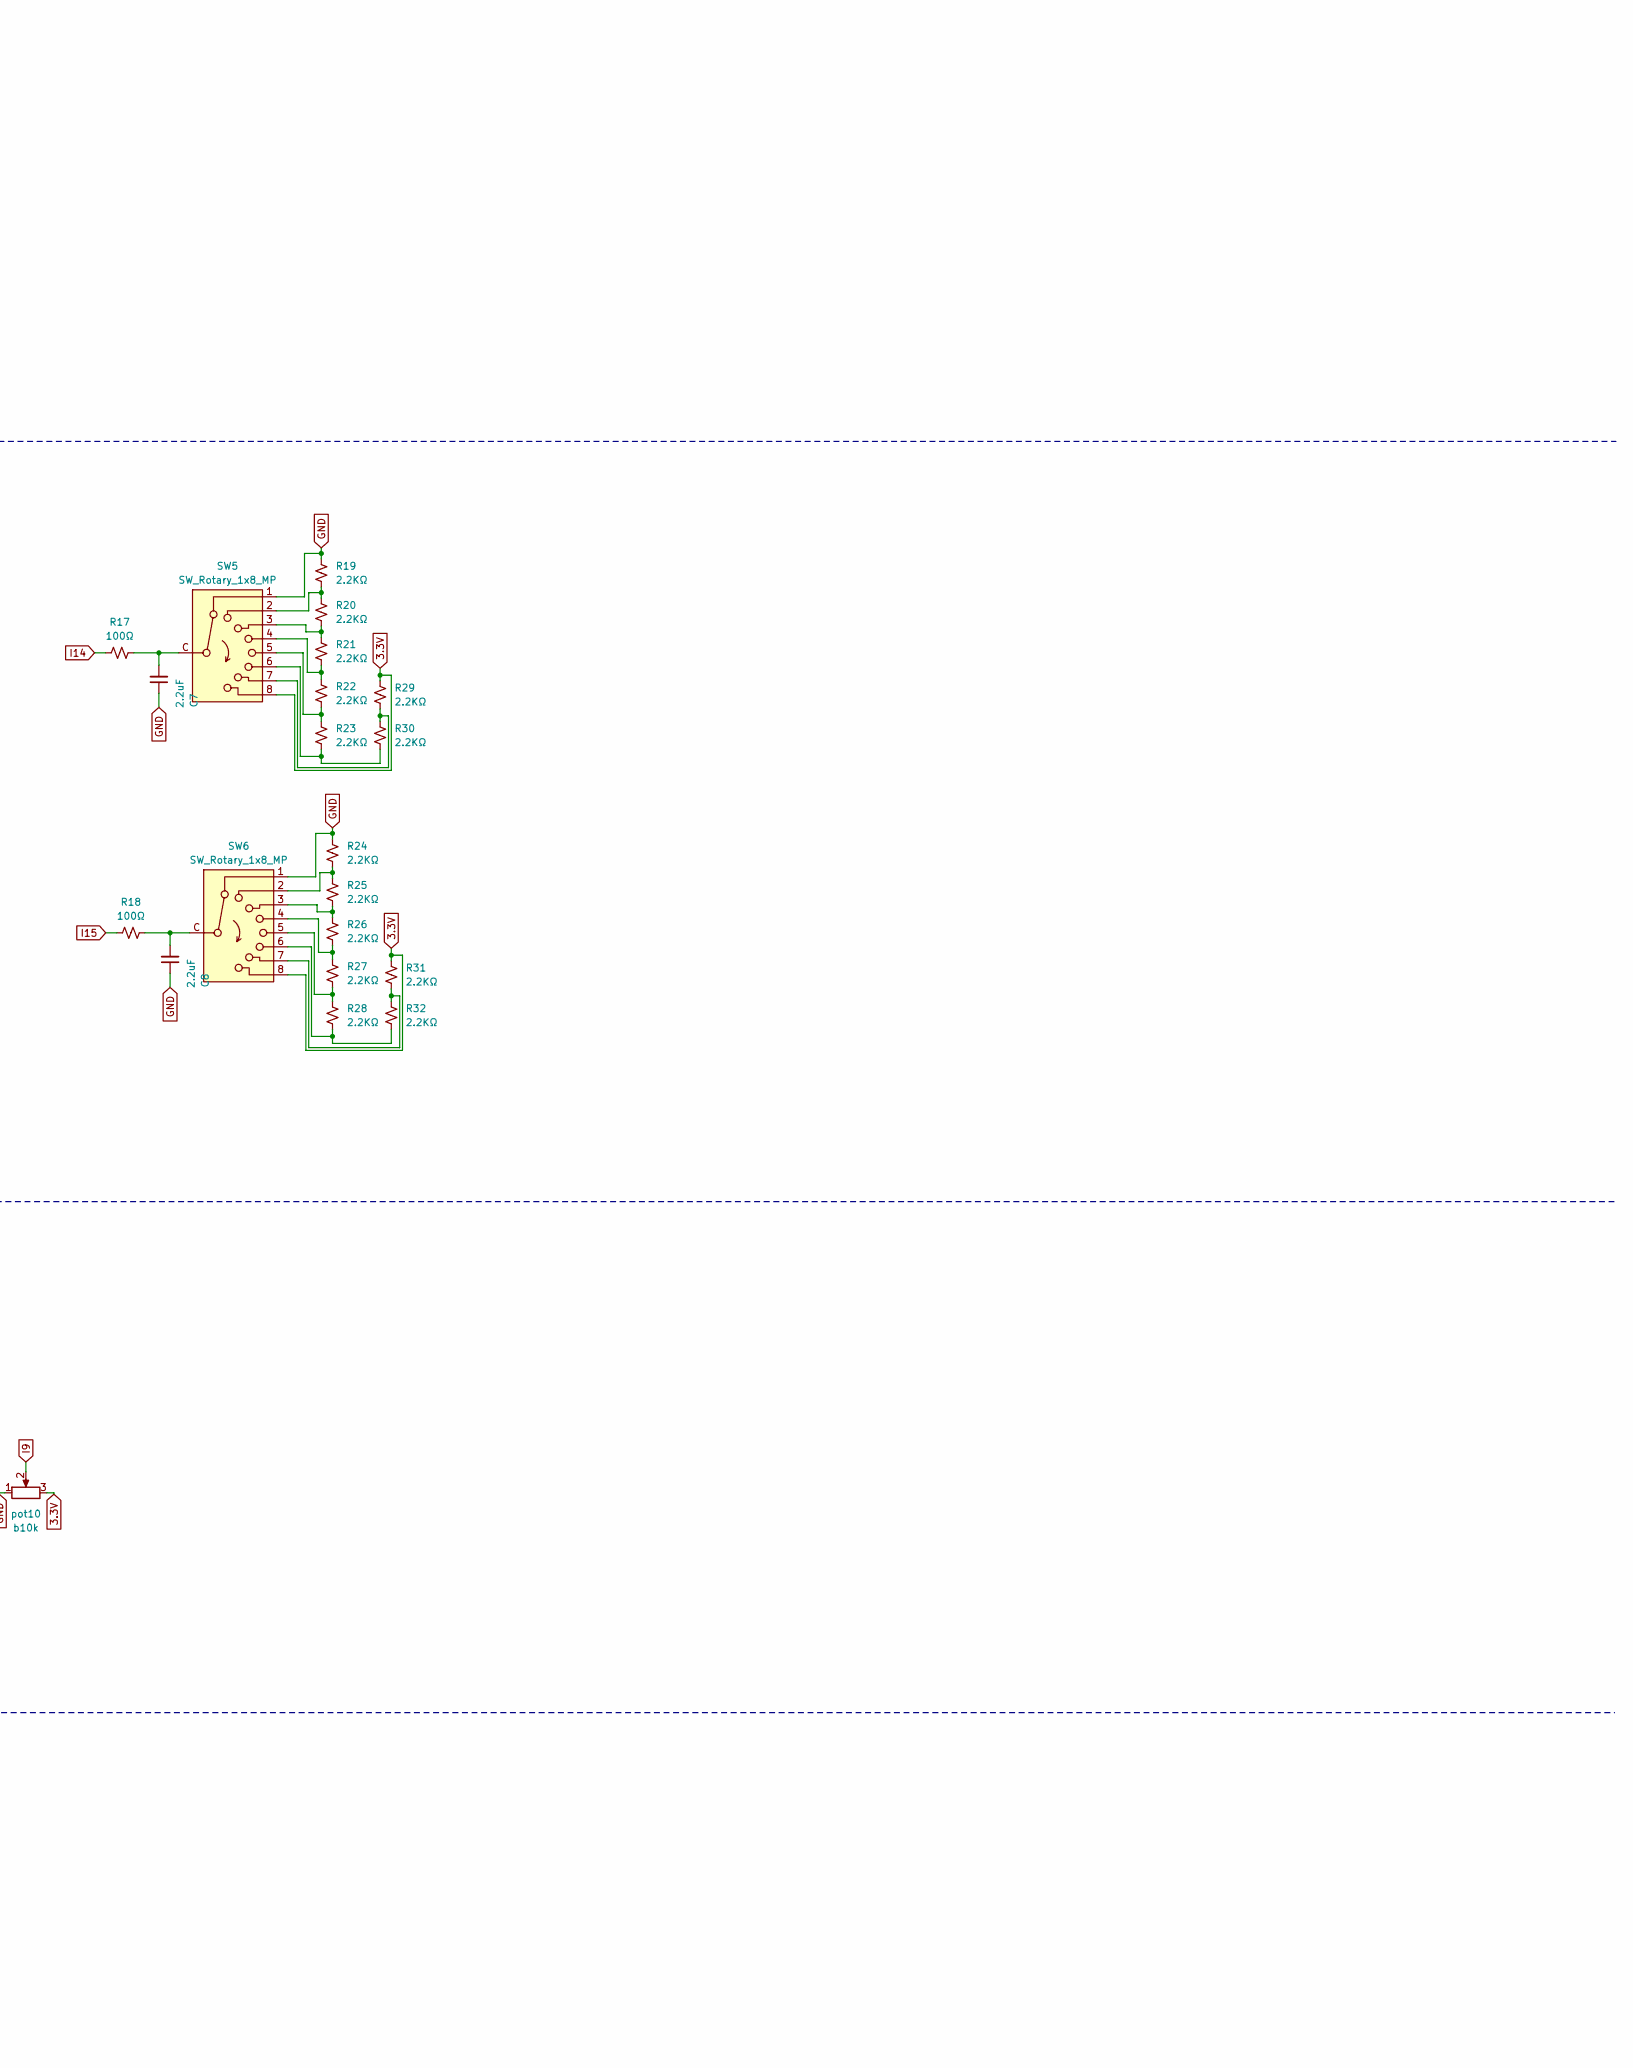
[picture p78: schematic 4067.kicad_sch, part in row 1, column 2]

Parts:
C1, C2: 0.1uF; C_0402_1005Metric; LCSC Part Number C1525
C3, C4, C5, C6, C7, C8: 2.2uF; C_0402_1005Metric; LCSC Part Number C12530
MUX1, MUX2: CD4067BMT/TR; TSSOP-24_4.4x7.8mm_P0.65mm; LCSC Part Number C7432333
R1, R2, R7, R8, R17, R18: 100Ω; R_0402_1005Metric; LCSC Part Number C25076
R3, R4, R5, R6, R9, R10, R11, R12, R13, R14, R15, R16, R19, R20, R21, R22, R23, R24, R25, R26, R27, R28, R29, R30, R31, R32: 2.2KΩ; R_0402_1005Metric; LCSC Part Number C25879
SW1, SW2: SW_Rotary_1x3_MP; SW_Rotary_RS25-3P
SW3, SW4: SW_Rotary_1x5_MP; SW_Rotary_RS25-5P
SW5, SW6: SW_Rotary_1x8_MP; SW_Rotary_RS25-8P
pot1, pot2, pot3, pot4, pot5, pot6, pot7, pot8, pot9, pot10: b10k; Potentiometer_Alps_RK09K_Single_Vertical
toggle_sw_2p-1: toggle_sw_2p; Toggle_Switch-2-pins
toggle_sw_3p-1, toggle_sw_3p-2: toggle_sw_3p; Toggle_Switch-3-pins

Connections:
3.3V: C1.2, C2.2, MUX1.24 (VCC), MUX2.24 (VCC), R4.1, R6.1, R12.1, R16.1, R29.2, R31.2, SW1.3, SW2.3, SW3.5, SW4.5, SW5.8, SW6.8, pot1.3, pot2.3, pot3.3, pot4.3, pot5.3, pot6.3, pot7.3, pot8.3, pot9.3, pot10.3; also elsewhere on the board
GND: C1.1, C2.1, C3.1, C4.1, C5.1, C6.1, C7.1, C8.1, MUX1.12 (GND), MUX1.15 (~E), MUX2.12 (GND), MUX2.15 (~E), R3.2, R5.2, R9.2, R13.2, R19.2, R24.2, SW1.1, SW2.1, SW3.1, SW4.1, SW5.1, SW6.1, pot1.1, pot2.1, pot3.1, pot4.1, pot5.1, pot6.1, pot7.1, pot8.1, pot9.1, pot10.1, toggle_sw_2p-1.2 (B), toggle_sw_3p-1.2 (B), toggle_sw_3p-2.2 (B); also elsewhere on the board
I0: MUX1.9 (I0), pot1.2
I1: MUX1.8 (I1), pot2.2
I2: MUX1.7 (I2), pot3.2
I3: MUX1.6 (I3), pot4.2
I4: MUX1.5 (I4), pot5.2
I5: MUX1.4 (I5), pot6.2
I6: MUX1.3 (I6), pot7.2
I7: MUX1.2 (I7), pot8.2
I8: MUX1.23 (I8), pot9.2
I9: MUX1.22 (I9), pot10.2
I10: MUX1.21 (I10), R1.1
I11: MUX1.20 (I11), R2.1
I12: MUX1.19 (I12), R7.1
I13: MUX1.18 (I13), R8.1
I14: MUX1.17 (I14), R17.1
I15: MUX1.16 (I15), R18.1
J0: MUX2.9 (I0), toggle_sw_2p-1.1 (A)
J1: MUX2.8 (I1), toggle_sw_3p-1.1 (A)
J2: MUX2.7 (I2), toggle_sw_3p-1.3 (C)
J3: MUX2.6 (I3), toggle_sw_3p-2.1 (A)
J4: MUX2.5 (I4), toggle_sw_3p-2.3 (C)
J5: MUX2.4 (I5)
J6: MUX2.3 (I6)
J7: MUX2.2 (I7)
J8: MUX2.23 (I8)
J9: MUX2.22 (I9)
J10: MUX2.21 (I10)
J11: MUX2.20 (I11)
J12: MUX2.19 (I12)
J13: MUX2.18 (I13)
J14: MUX2.17 (I14)
J15: MUX2.16 (I15)
unnamed: C3.2, R1.2, SW1.C
unnamed: C4.2, R2.2, SW2.C
unnamed: C5.2, R7.2, SW3.C
unnamed: C6.2, R8.2, SW4.C
unnamed: C7.2, R17.2, SW5.C
unnamed: C8.2, R18.2, SW6.C
unnamed: R3.1, R4.2, SW1.2
unnamed: R5.1, R6.2, SW2.2
unnamed: R10.1, R11.2, SW3.3
unnamed: R9.1, R10.2, SW3.2
unnamed: R11.1, R12.2, SW3.4
unnamed: R13.1, R14.2, SW4.2
unnamed: R14.1, R15.2, SW4.3
unnamed: R15.1, R16.2, SW4.4
unnamed: R19.1, R20.2, SW5.2
unnamed: R20.1, R21.2, SW5.3
unnamed: R21.1, R22.2, SW5.4
unnamed: R22.1, R23.2, SW5.5
unnamed: R23.1, R30.1, SW5.6
unnamed: R24.1, R25.2, SW6.2
unnamed: R25.1, R26.2, SW6.3
unnamed: R26.1, R27.2, SW6.4
unnamed: R27.1, R28.2, SW6.5
unnamed: R28.1, R32.1, SW6.6
unnamed: R29.1, R30.2, SW5.7
unnamed: R31.1, R32.2, SW6.7
S0: MUX1.10 (S0), MUX2.10 (S0); also elsewhere on the board
S1: MUX1.11 (S1), MUX2.11 (S1); also elsewhere on the board
S2: MUX1.14 (S2), MUX2.14 (S2); also elsewhere on the board
S3: MUX1.13 (S3), MUX2.13 (S3); also elsewhere on the board
sig_1: MUX1.1 (COM); also elsewhere on the board
sig_2: MUX2.1 (COM); also elsewhere on the board

Notes on the sheet:
Latching Buttons
Potentiometers
4067

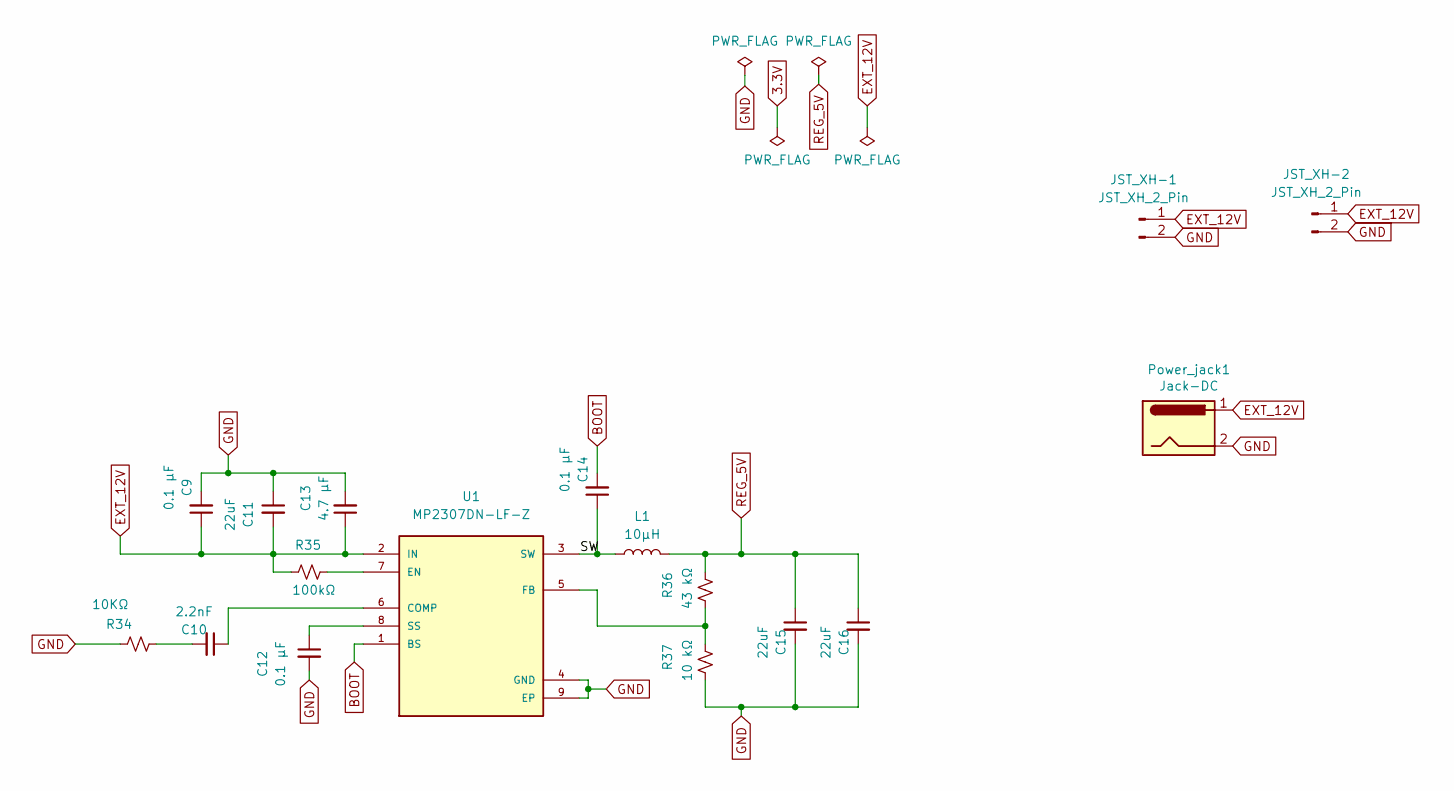
[picture p79: schematic Voltage_Regulator.kicad_sch]

Parts:
C9, C12, C14: 0.1 µF; C_0402_1005Metric; LCSC Part Number C1525
C10: 2.2nF; C_0603_1608Metric; LCSC Part Number C1604
C11, C15, C16: 22uF; C_0603_1608Metric; LCSC Part Number C59461
C13: 4.7 µF; C_0402_1005Metric; LCSC Part Number C23733
JST_XH-1, JST_XH-2: JST_XH_2_Pin; JST_XH_B2B-XH-A_1x02_P2.50mm_Vertical
L1: 10µH; L_Bourns-SRN8040_8x8.15mm; LCSC Part Number C37429
Power_jack1: Jack-DC; BarrelJack_Horizontal
R34: 10KΩ; R_0603_1608Metric; LCSC Part Number C25744
R35: 100kΩ; R_0603_1608Metric; LCSC Part Number C23212
R36: 43 kΩ; R_0402_1005Metric; LCSC Part Number C2906943
R37: 10 kΩ; R_0402_1005Metric; LCSC Part Number C25744
U1: MP2307DN-LF-Z; SOIC-8-1EP_3.9x4.9mm_P1.27mm_EP2.29x3mm_ThermalVias; PARTREV 1.9; LCSC Part Number C2928813

Connections:
/Voltage_Regulator/SW: C14.1, L1.1, U1.3 (SW)
BOOT: C14.2, U1.1 (BS)
EXT_12V: C9.1, C11.2, C13.1, JST_XH-1.1, JST_XH-2.1, Power_jack1.1, R35.1, U1.2 (IN)
GND: C9.2, C11.1, C12.2, C13.2, C15.2, C16.2, JST_XH-1.2, JST_XH-2.2, Power_jack1.2, R34.1, R37.2, U1.4 (GND), U1.9 (EP); also elsewhere on the board
unnamed: C10.2, R34.2
unnamed: C10.1, U1.6 (COMP)
unnamed: R35.2, U1.7 (EN)
unnamed: R36.2, R37.1, U1.5 (FB)
unnamed: C12.1, U1.8 (SS)
REG_5V: C15.1, C16.1, L1.2, R36.1; also elsewhere on the board

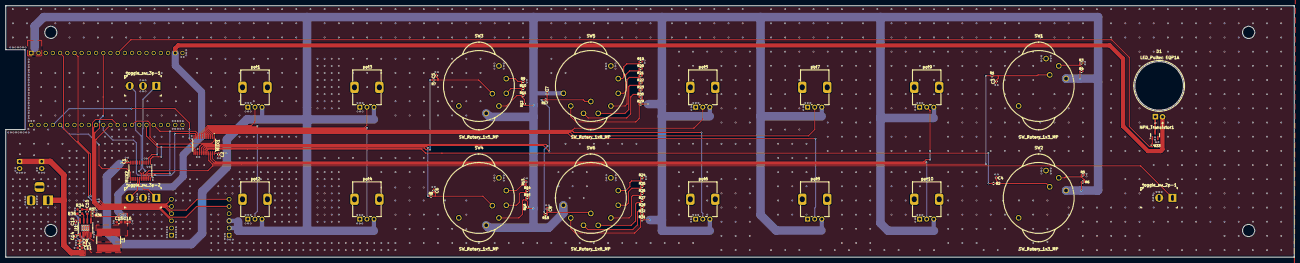
[picture p80: board Summit-EQP200B.kicad_pcb from above]

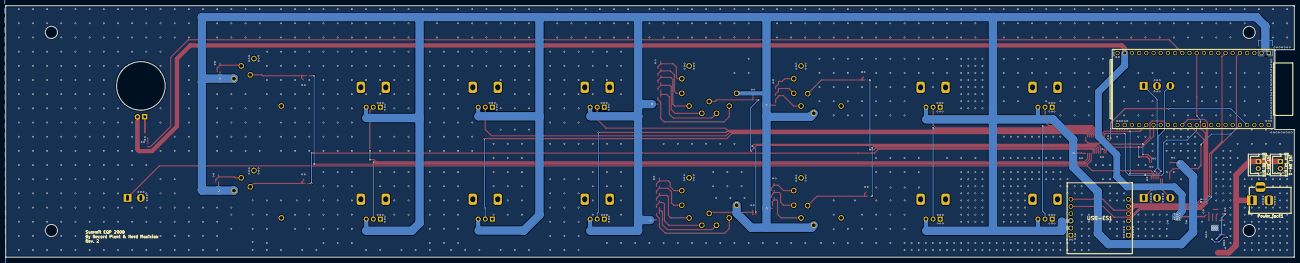
[picture p81: board Summit-EQP200B.kicad_pcb from below]

Board: 2 copper layers, 454.6 x 88.7 mm, 83 parts (5 on the bottom side), 73 nets.
