eSpark-Backup/patrizio-moi-pcb-fixes/Client-Files/20 - Telektronix LA3A - 3-July-2025/Teletronix_LA3A.kicad_pcb

## KiCad design Client-Files/20 - Telektronix LA3A - 3-July-2025/Teletronix_LA3A.kicad_pcb (2025-07-31)

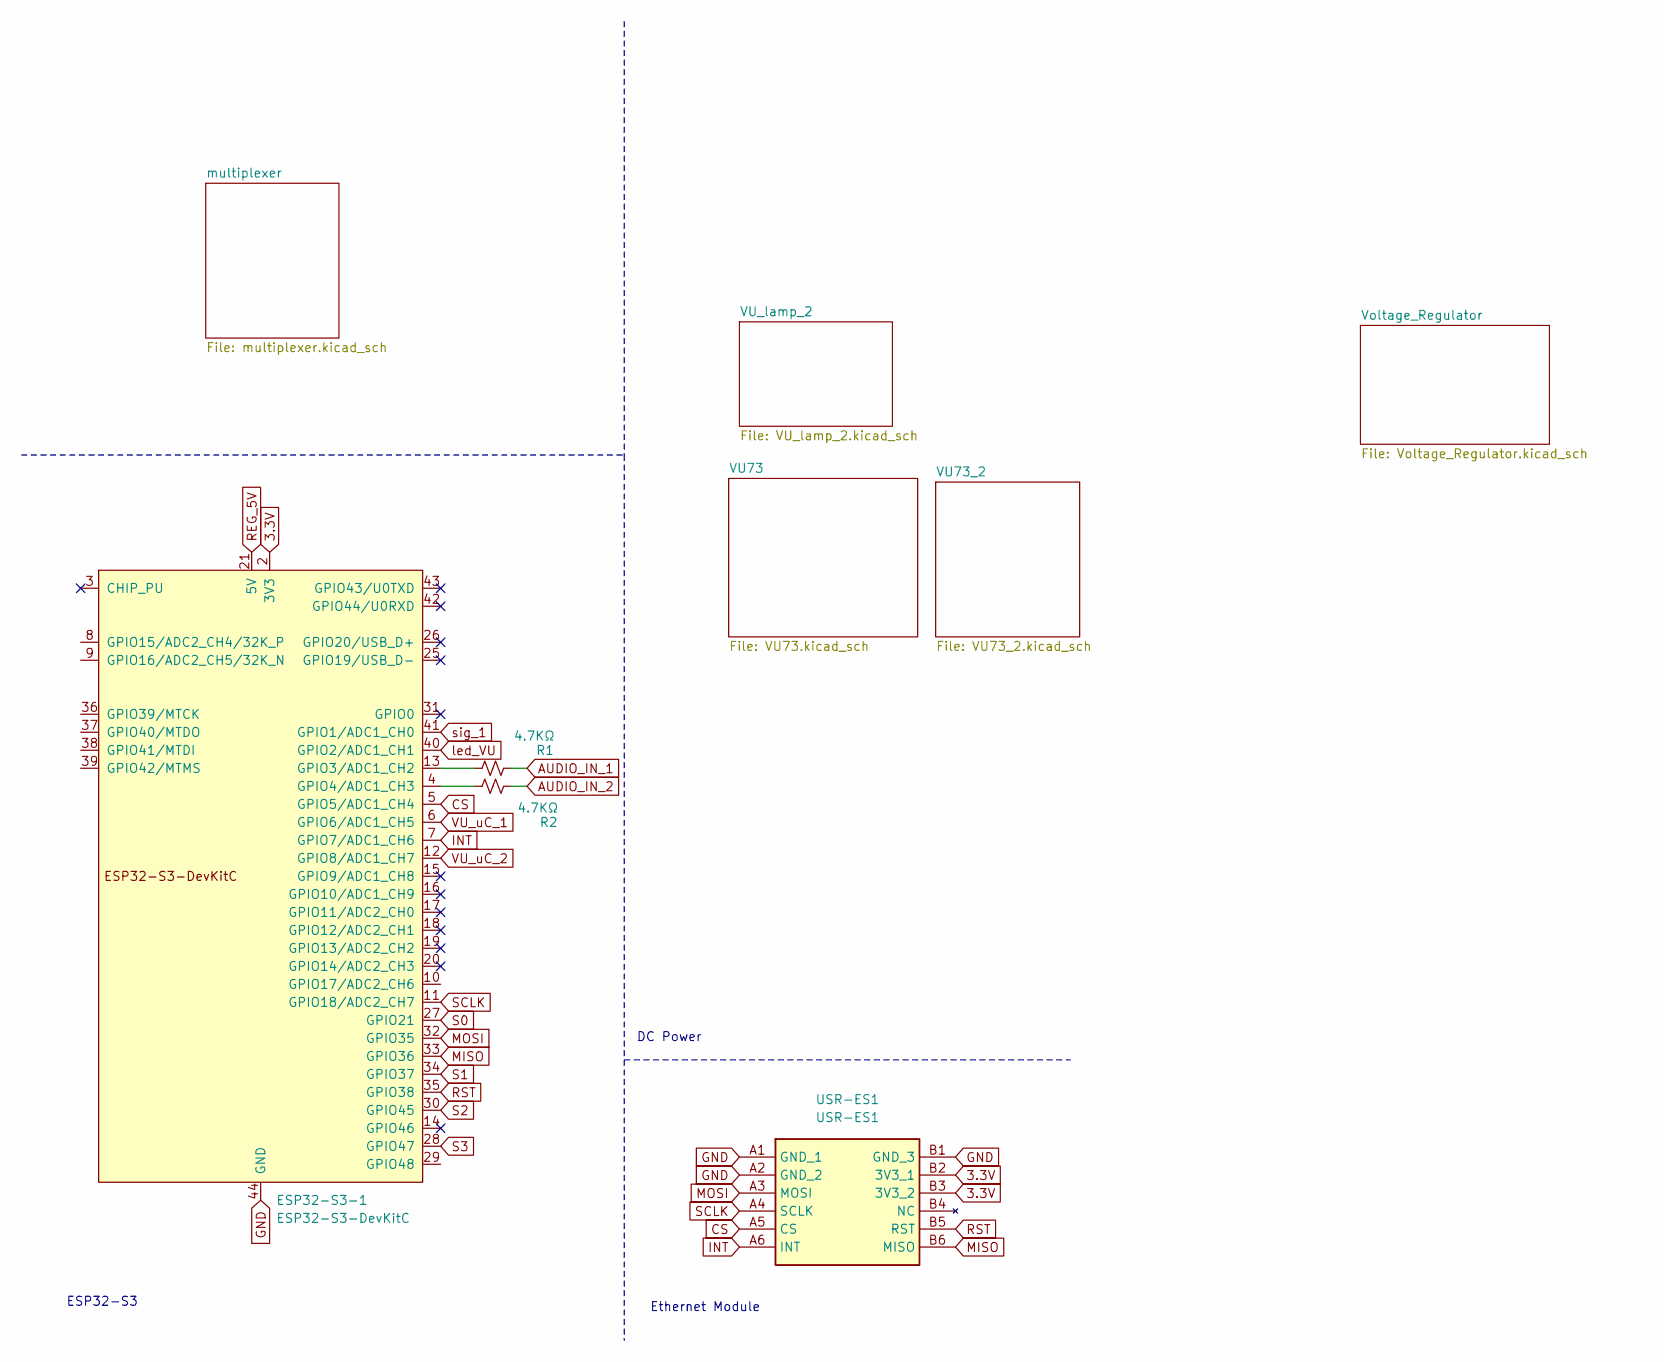
[picture p82: schematic Teletronix_LA3A.kicad_sch]

Parts:
ESP32-S3-1: ESP32-S3-DevKitC; ESP32-S3-DEVKITC-1-N8R2-2
R1, R2: 4.7KΩ; R_0402_1005Metric; LCSC Part Number C25900
USR-ES1: USR-ES1; USRES1; Manufacturer_Part_Number USR-ES1

Connections:
3.3V: ESP32-S3-1.1 (3V3), ESP32-S3-1.2 (3V3), USR-ES1.B2 (3V3_1), USR-ES1.B3 (3V3_2); also elsewhere on the board
AUDIO_IN_1: R1.1; also elsewhere on the board
AUDIO_IN_2: R2.1; also elsewhere on the board
CS: ESP32-S3-1.5 (GPIO5/ADC1_CH4), USR-ES1.A5 (CS)
GND: ESP32-S3-1.22 (GND), ESP32-S3-1.23 (GND), ESP32-S3-1.24 (GND), ESP32-S3-1.44 (GND), USR-ES1.A1 (GND_1), USR-ES1.A2 (GND_2), USR-ES1.B1 (GND_3); also elsewhere on the board
INT: ESP32-S3-1.7 (GPIO7/ADC1_CH6), USR-ES1.A6 (INT)
MISO: ESP32-S3-1.33 (GPIO36), USR-ES1.B6 (MISO)
MOSI: ESP32-S3-1.32 (GPIO35), USR-ES1.A3 (MOSI)
unnamed: ESP32-S3-1.13 (GPIO3/ADC1_CH2), R1.2
unnamed: ESP32-S3-1.4 (GPIO4/ADC1_CH3), R2.2
REG_5V: ESP32-S3-1.21 (5V); also elsewhere on the board
RST: ESP32-S3-1.35 (GPIO38), USR-ES1.B5 (RST)
S0: ESP32-S3-1.27 (GPIO21); also elsewhere on the board
S1: ESP32-S3-1.34 (GPIO37); also elsewhere on the board
S2: ESP32-S3-1.30 (GPIO45); also elsewhere on the board
S3: ESP32-S3-1.28 (GPIO47); also elsewhere on the board
SCLK: ESP32-S3-1.11 (GPIO18/ADC2_CH7), USR-ES1.A4 (SCLK)
VU_uC_1: ESP32-S3-1.6 (GPIO6/ADC1_CH5); also elsewhere on the board
VU_uC_2: ESP32-S3-1.12 (GPIO8/ADC1_CH7); also elsewhere on the board
led_VU: ESP32-S3-1.40 (GPIO2/ADC1_CH1); also elsewhere on the board
sig_1: ESP32-S3-1.41 (GPIO1/ADC1_CH0); also elsewhere on the board

Notes on the sheet:
Ethernet Module
DC Power
ESP32-S3

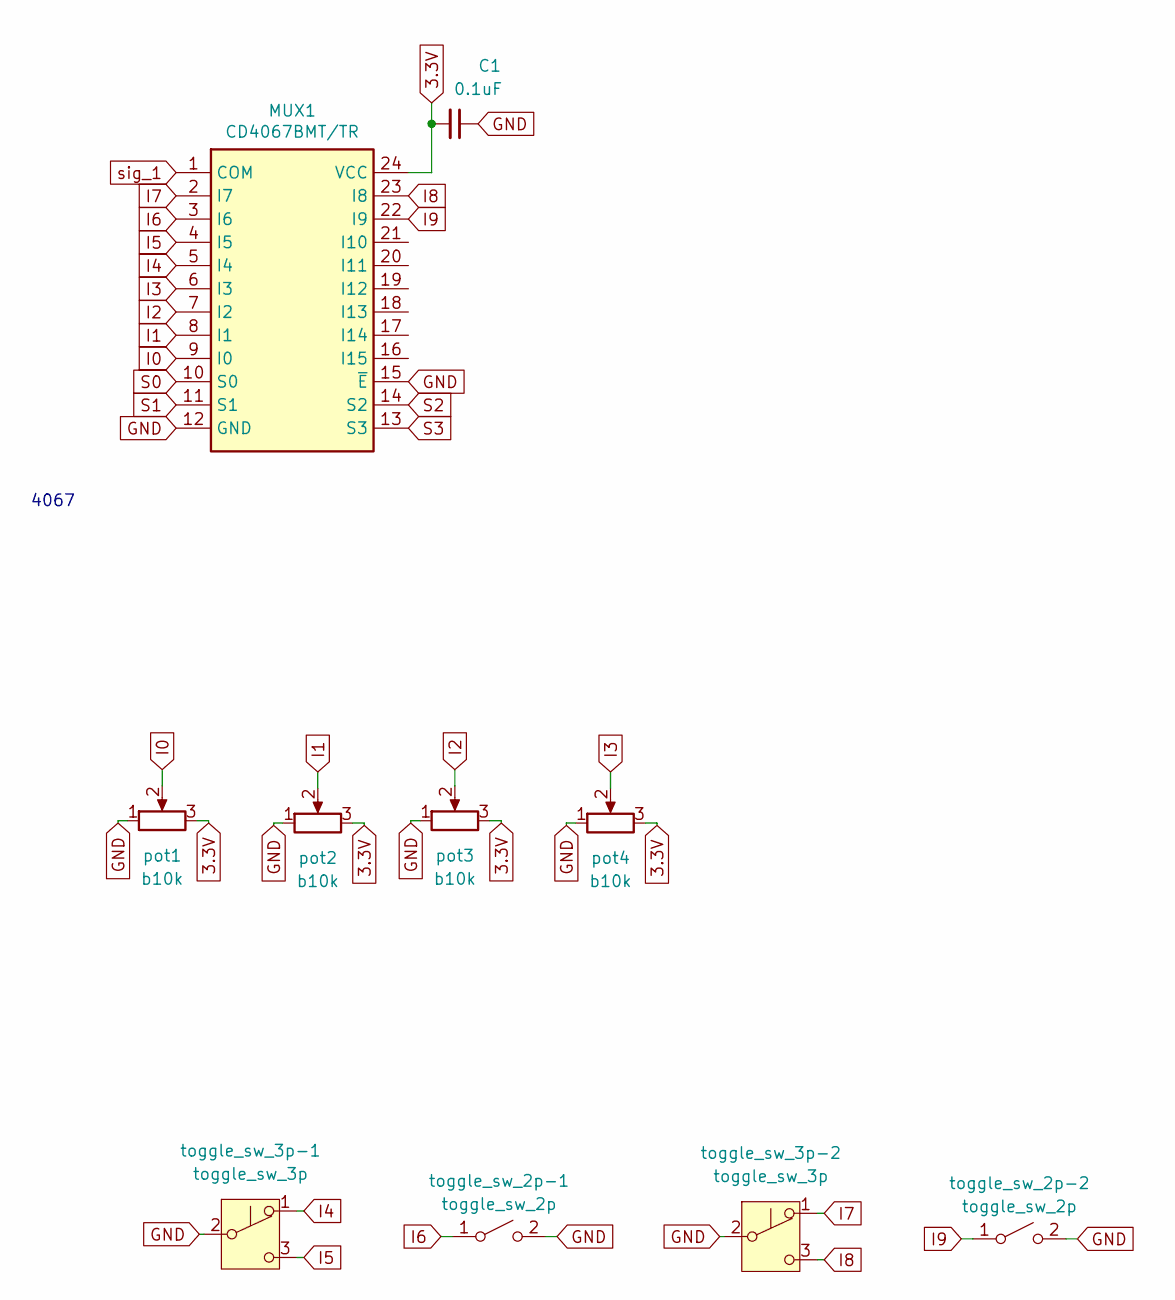
[picture p83: schematic multiplexer.kicad_sch]

Parts:
C1: 0.1uF; C_0402_1005Metric; LCSC Part Number C1525
MUX1: CD4067BMT/TR; TSSOP-24_4.4x7.8mm_P0.65mm; LCSC Part Number C7432333
pot1, pot2, pot3, pot4: b10k; Potentiometer_Alps_RK09K_Single_Vertical
toggle_sw_2p-1, toggle_sw_2p-2: toggle_sw_2p; Toggle_Switch-2-pins
toggle_sw_3p-1, toggle_sw_3p-2: toggle_sw_3p; Toggle_Switch-3-pins

Connections:
3.3V: C1.2, MUX1.24 (VCC), pot1.3, pot2.3, pot3.3, pot4.3; also elsewhere on the board
GND: C1.1, MUX1.12 (GND), MUX1.15 (~E), pot1.1, pot2.1, pot3.1, pot4.1, toggle_sw_2p-1.2 (B), toggle_sw_2p-2.2 (B), toggle_sw_3p-1.2 (B), toggle_sw_3p-2.2 (B); also elsewhere on the board
I0: MUX1.9 (I0), pot1.2
I1: MUX1.8 (I1), pot2.2
I2: MUX1.7 (I2), pot3.2
I3: MUX1.6 (I3), pot4.2
I4: MUX1.5 (I4), toggle_sw_3p-1.1 (A)
I5: MUX1.4 (I5), toggle_sw_3p-1.3 (C)
I6: MUX1.3 (I6), toggle_sw_2p-1.1 (A)
I7: MUX1.2 (I7), toggle_sw_3p-2.1 (A)
I8: MUX1.23 (I8), toggle_sw_3p-2.3 (C)
I9: MUX1.22 (I9), toggle_sw_2p-2.1 (A)
S0: MUX1.10 (S0); also elsewhere on the board
S1: MUX1.11 (S1); also elsewhere on the board
S2: MUX1.14 (S2); also elsewhere on the board
S3: MUX1.13 (S3); also elsewhere on the board
sig_1: MUX1.1 (COM); also elsewhere on the board

Notes on the sheet:
4067

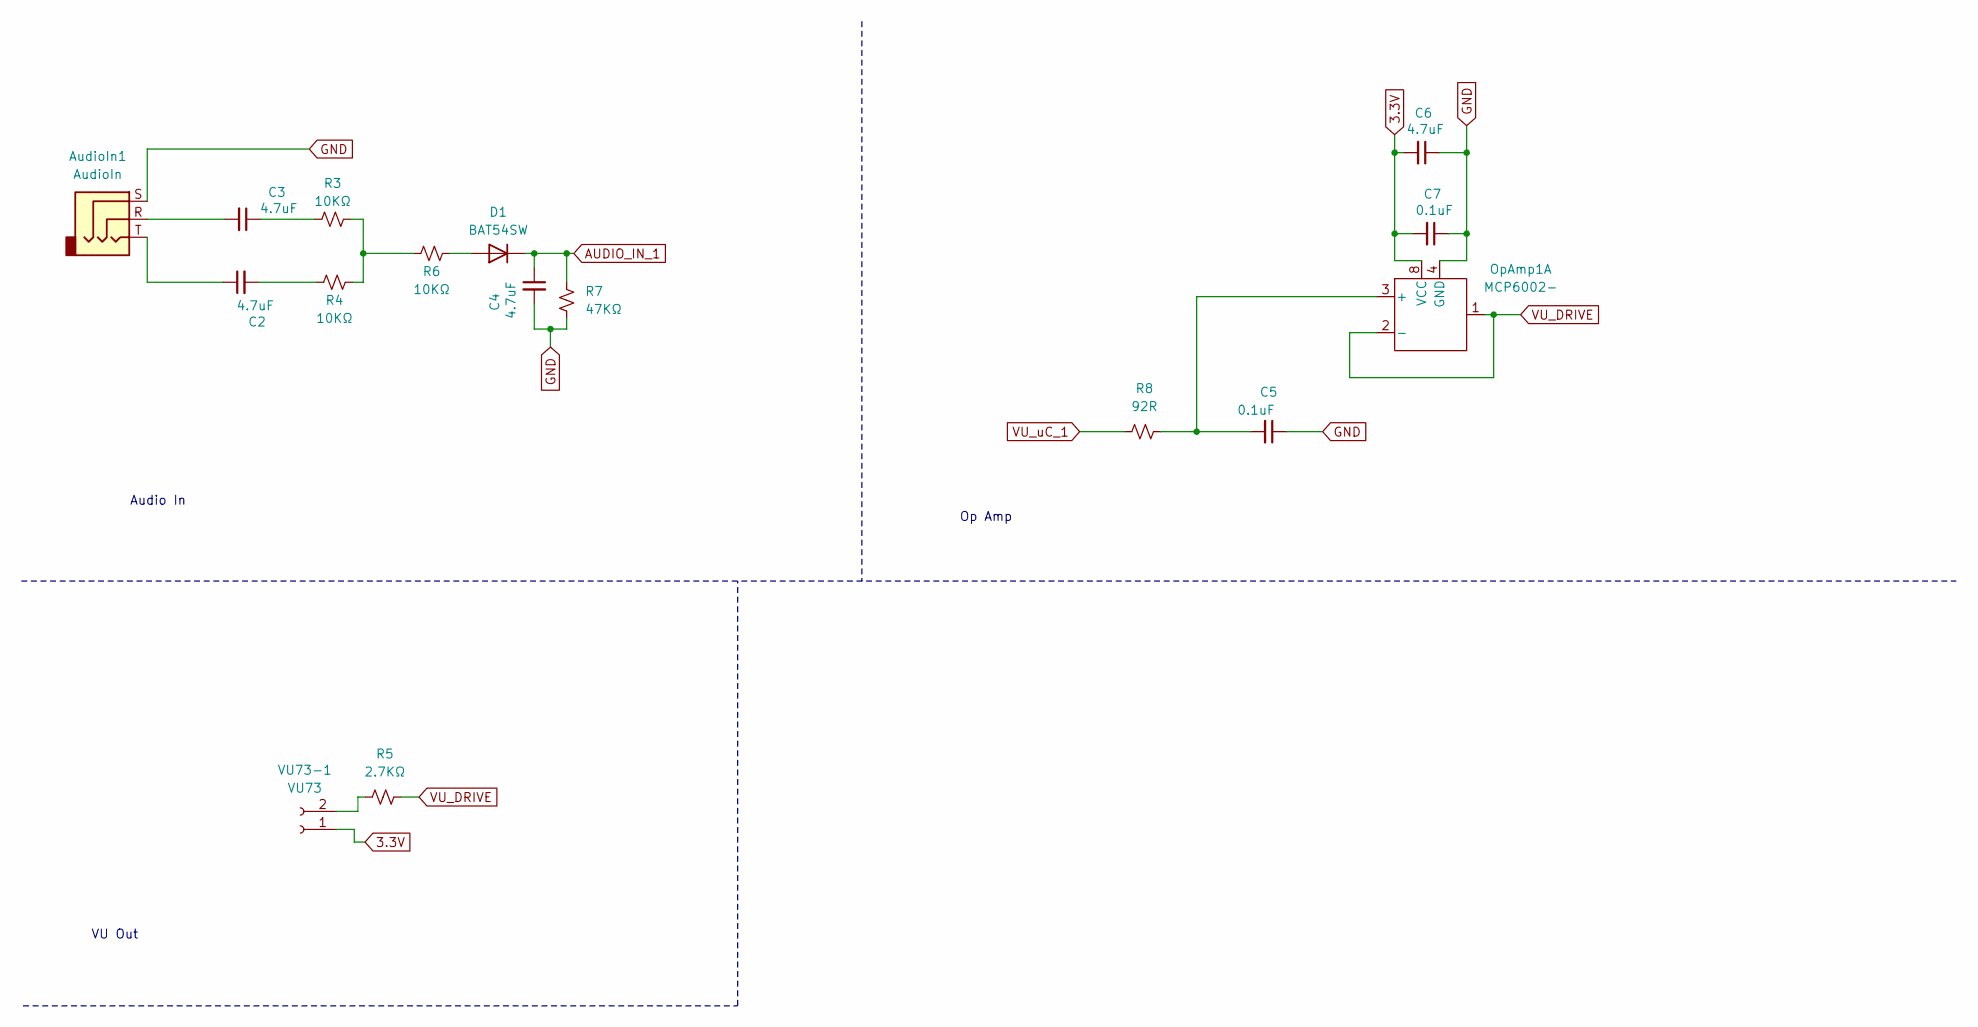
[picture p84: schematic VU73.kicad_sch]

Parts:
AudioIn1: AudioIn; Jack_3.5mm_PJ320D_Horizontal; LCSC Part Number C22459515
C2, C3, C4, C6: 4.7uF; C_0402_1005Metric; LCSC Part Number C23733
C5: 0.1uF; C_0402_1005Metric
C7: 0.1uF; C_0402_1005Metric; LCSC Part Number C1525
D1: BAT54SW; D_SOD-323; LCSC Part Number C27636114
OpAmp1: MCP6002-; SOIC-8_3.9x4.9mm_P1.27mm; LCSC Part Number C7377
R3, R4, R6: 10KΩ; R_0402_1005Metric; LCSC Part Number C25744
R5: 2.7KΩ; R_0603_1608Metric; LCSC Part Number C13167
R7: 47KΩ; R_0402_1005Metric; LCSC Part Number C25792
R8: 92R; R_0402_1005Metric
VU73-1: VU73; PinSocket_1x02_P2.54mm_Vertical

Connections:
3.3V: C6.2, C7.2, OpAmp1.8 (VCC), VU73-1.1; also elsewhere on the board
AUDIO_IN_1: C4.1, D1.1 (K), R7.2; also elsewhere on the board
GND: AudioIn1.S, C4.2, C5.1, C6.1, C7.1, OpAmp1.4 (GND), R7.1; also elsewhere on the board
unnamed: AudioIn1.R, C3.2
unnamed: AudioIn1.T, C2.1
unnamed: C2.2, R4.2
unnamed: C3.1, R3.2
unnamed: D1.2 (A), R6.1
unnamed: C5.2, OpAmp1.3 (+), R8.1
unnamed: R3.1, R4.1, R6.2
unnamed: R5.2, VU73-1.2
VU_DRIVE: OpAmp1.1, OpAmp1.2 (-), R5.1
VU_uC_1: R8.2; also elsewhere on the board

Notes on the sheet:
VU Out
Op Amp
Audio In

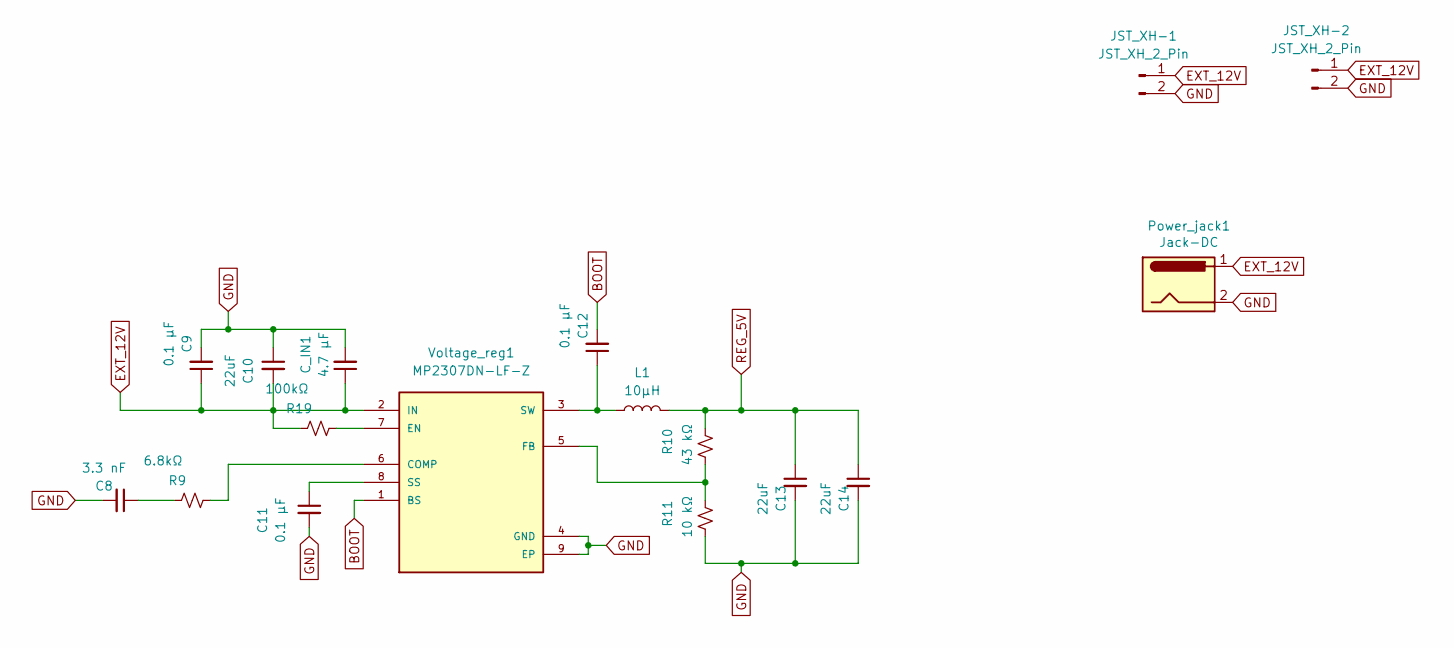
[picture p85: schematic Voltage_Regulator.kicad_sch]

Parts:
C8: 3.3 nF; C_0603_1608Metric; LCSC Part Number C1613
C9, C11, C12: 0.1 µF; C_0402_1005Metric; LCSC Part Number C1525
C10, C13, C14: 22uF; C_0603_1608Metric; LCSC Part Number C59461
C_IN1: 4.7 µF; C_0402_1005Metric; LCSC Part Number C23733
JST_XH-1, JST_XH-2: JST_XH_2_Pin; JST_XH_B2B-XH-A_1x02_P2.50mm_Vertical
L1: 10µH; L_Bourns-SRN8040_8x8.15mm; LCSC Part Number C37429
Power_jack1: Jack-DC; BarrelJack_Horizontal
R9: 6.8kΩ; R_0603_1608Metric; LCSC Part Number C23212
R10: 43 kΩ; R_0402_1005Metric; LCSC Part Number C2906943
R11: 10 kΩ; R_0402_1005Metric; LCSC Part Number C25744
R19: 100kΩ; R_0603_1608Metric
Voltage_reg1: MP2307DN-LF-Z; SOIC-8-1EP_3.9x4.9mm_P1.27mm_EP2.29x3mm_ThermalVias; PARTREV 1.9; LCSC Part Number C2928813

Connections:
BOOT: C12.2, Voltage_reg1.1 (BS)
EXT_12V: C9.1, C10.2, C_IN1.1, JST_XH-1.1, JST_XH-2.1, Power_jack1.1, R19.1, Voltage_reg1.2 (IN)
GND: C8.2, C9.2, C10.1, C11.2, C13.2, C14.2, C_IN1.2, JST_XH-1.2, JST_XH-2.2, Power_jack1.2, R11.2, Voltage_reg1.4 (GND), Voltage_reg1.9 (EP); also elsewhere on the board
unnamed: C8.1, R9.1
unnamed: R9.2, Voltage_reg1.6 (COMP)
unnamed: R19.2, Voltage_reg1.7 (EN)
unnamed: R10.2, R11.1, Voltage_reg1.5 (FB)
unnamed: C11.1, Voltage_reg1.8 (SS)
unnamed: C12.1, L1.1, Voltage_reg1.3 (SW)
REG_5V: C13.1, C14.1, L1.2, R10.1; also elsewhere on the board

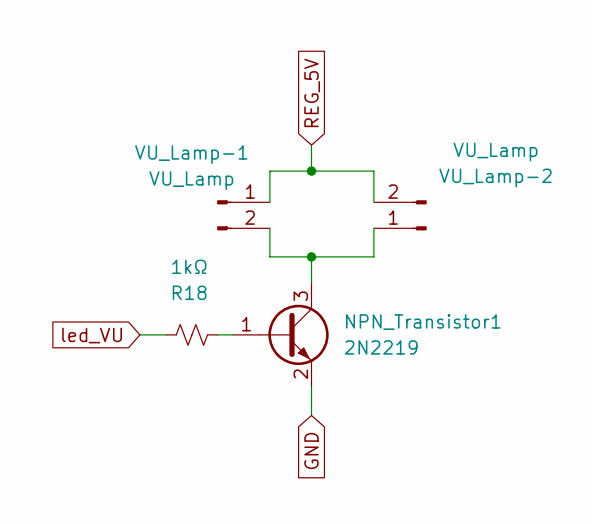
[picture p86: schematic VU_lamp_2.kicad_sch]

Parts:
NPN_Transistor1: 2N2219; SOT-23; LCSC Part Number C2150
R18: 1kΩ; R_0402_1005Metric; Manufacturer_Part_Number 0402WGF3300TCE; LCSC Part Number C11702
VU_Lamp-1, VU_Lamp-2: VU_Lamp; PinSocket_1x02_P2.54mm_Vertical

Connections:
GND: NPN_Transistor1.2 (E); also elsewhere on the board
unnamed: NPN_Transistor1.1 (B), R18.1
unnamed: NPN_Transistor1.3 (C), VU_Lamp-1.2, VU_Lamp-2.1
REG_5V: VU_Lamp-1.1, VU_Lamp-2.2; also elsewhere on the board
led_VU: R18.2; also elsewhere on the board

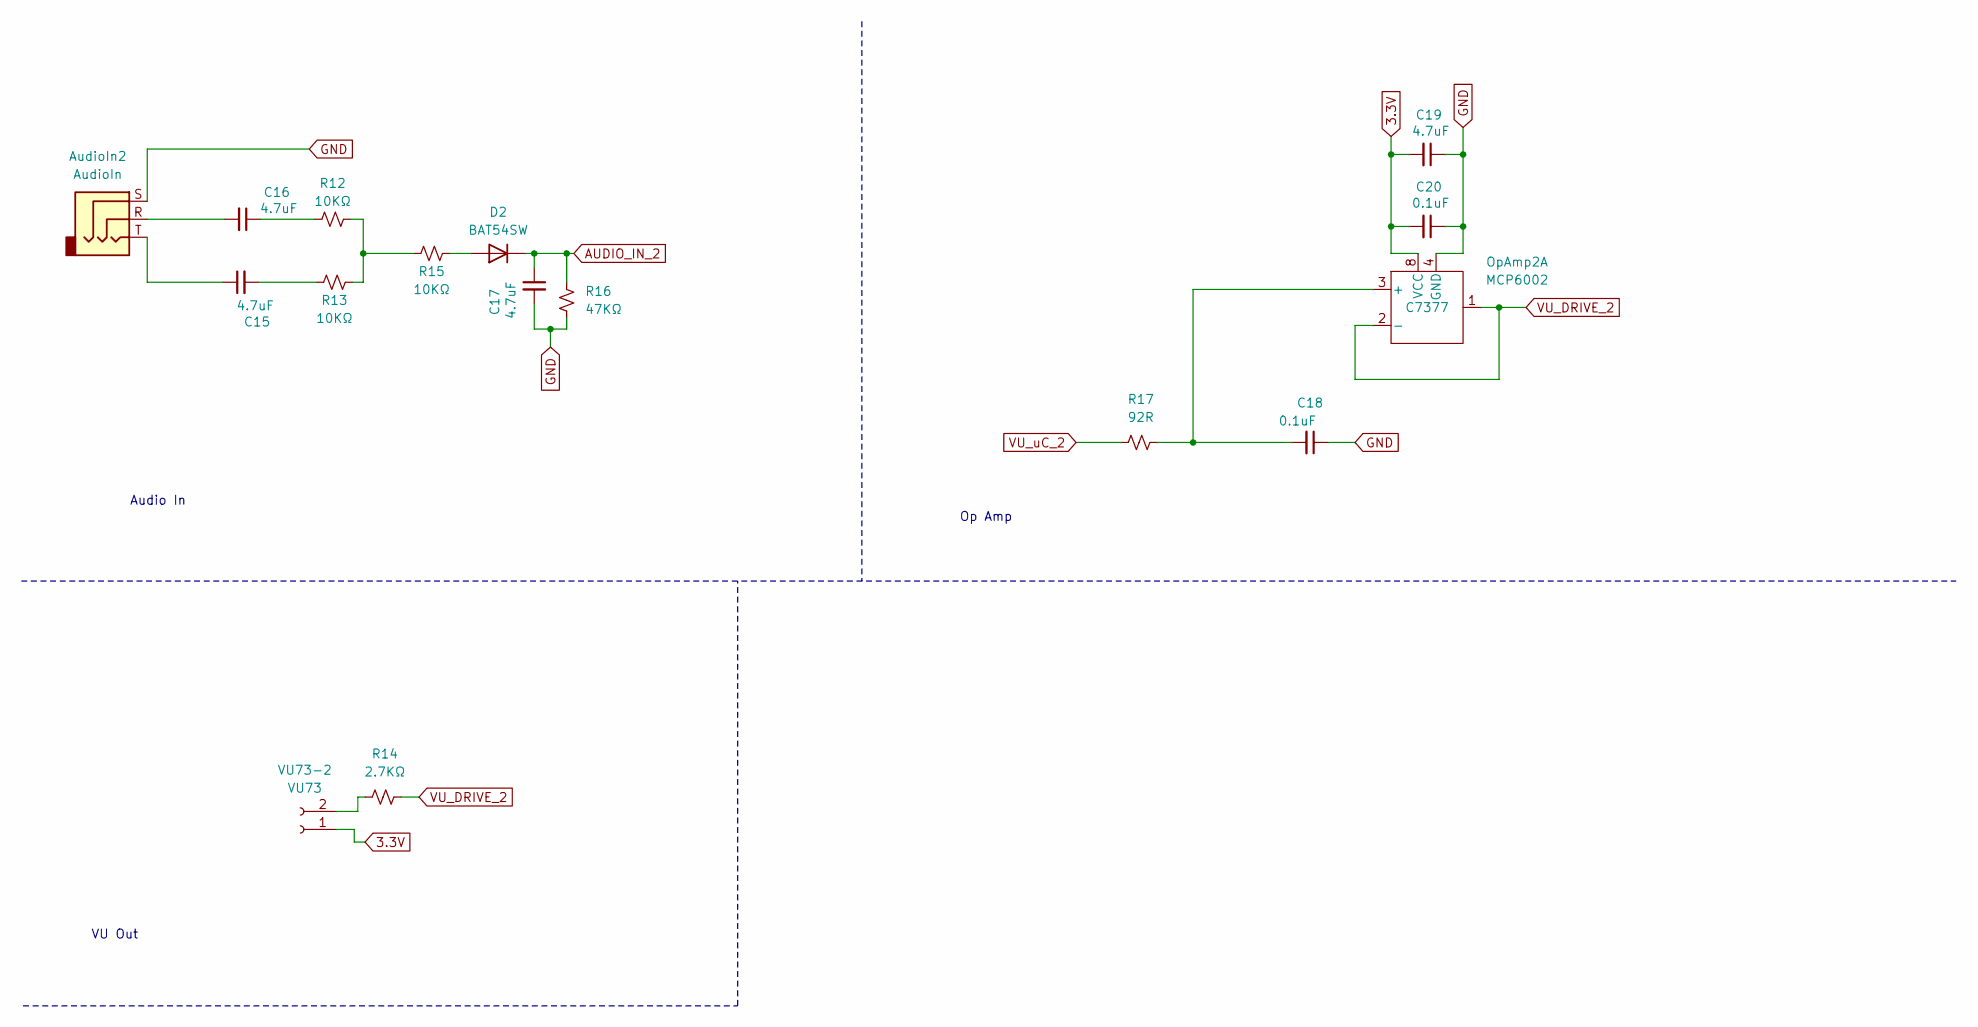
[picture p87: schematic VU73_2.kicad_sch]

Parts:
AudioIn2: AudioIn; Jack_3.5mm_PJ320D_Horizontal
C15, C16, C17, C19: 4.7uF; C_0402_1005Metric; LCSC Part Number C23733
C18: 0.1uF; C_0402_1005Metric
C20: 0.1uF; C_0402_1005Metric; LCSC Part Number C1525
D2: BAT54SW; D_SOD-323; LCSC Part Number C27636114
OpAmp2: MCP6002; SOIC-8_3.9x4.9mm_P1.27mm; LCSC Part Number C7377
R12, R13, R15: 10KΩ; R_0402_1005Metric; LCSC Part Number C25744
R14: 2.7KΩ; R_0603_1608Metric; LCSC Part Number C13167
R16: 47KΩ; R_0402_1005Metric; LCSC Part Number C25792
R17: 92R; R_0402_1005Metric
VU73-2: VU73; PinSocket_1x02_P2.54mm_Vertical

Connections:
3.3V: C19.2, C20.2, OpAmp2.8 (VCC), VU73-2.1; also elsewhere on the board
AUDIO_IN_2: C17.1, D2.1 (K), R16.2; also elsewhere on the board
GND: AudioIn2.S, C17.2, C18.1, C19.1, C20.1, OpAmp2.4 (GND), R16.1; also elsewhere on the board
unnamed: AudioIn2.R, C16.2
unnamed: AudioIn2.T, C15.1
unnamed: C15.2, R13.2
unnamed: C16.1, R12.2
unnamed: D2.2 (A), R15.1
unnamed: C18.2, OpAmp2.3 (+), R17.1
unnamed: R12.1, R13.1, R15.2
unnamed: R14.2, VU73-2.2
VU_DRIVE_2: OpAmp2.1, OpAmp2.2 (-), R14.1
VU_uC_2: R17.2; also elsewhere on the board

Notes on the sheet:
VU Out
Op Amp
Audio In

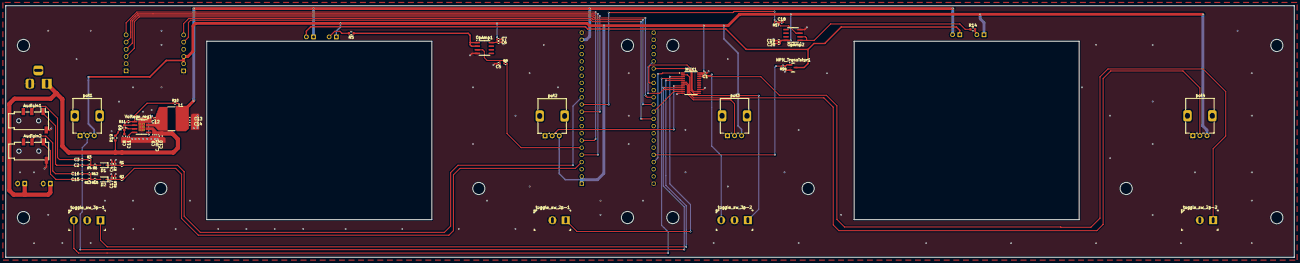
[picture p88: board Teletronix_LA3A.kicad_pcb from above]

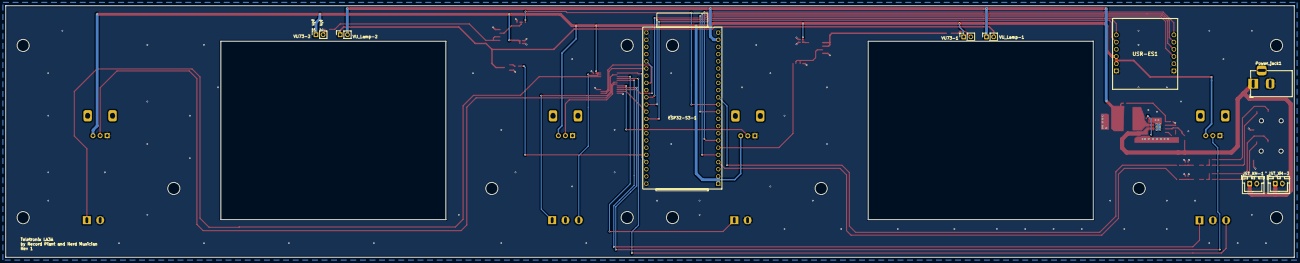
[picture p89: board Teletronix_LA3A.kicad_pcb from below]

Board: 2 copper layers, 455.0 x 88.8 mm, 67 parts (9 on the bottom side), 59 nets.
