eSpark-Backup/patrizio-moi-pcb-fixes/Design_Files/24 - SSL EQ Rack - 6-June-2025/SSL-EQ-Rack.kicad_pcb

## KiCad design Client-Files/06 - TubeTech CL1B - 3-July-2025/TubeTech_CL1.kicad_pcb

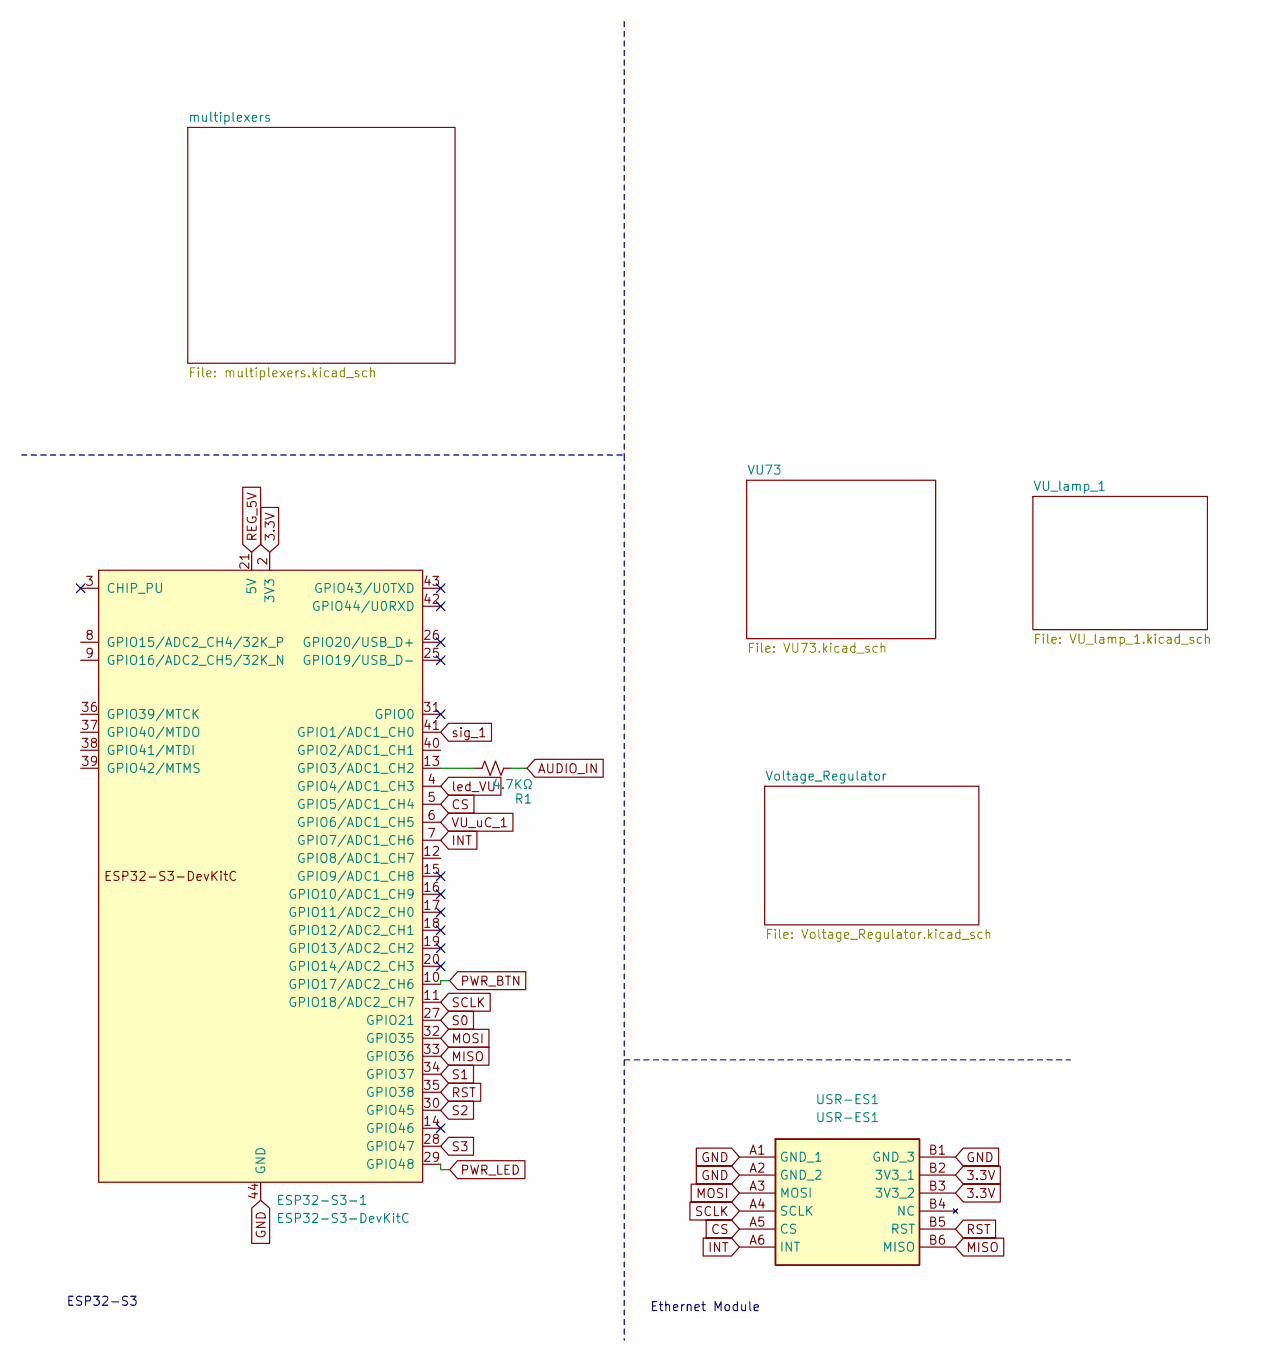
[picture p90: schematic TubeTech_CL1.kicad_sch]

Parts:
ESP32-S3-1: ESP32-S3-DevKitC; ESP32-S3-DEVKITC-1-N8R2-2
R1: 4.7KΩ; R_0402_1005Metric; LCSC Part Number C25900
USR-ES1: USR-ES1; USRES1; Manufacturer_Part_Number USR-ES1

Connections:
3.3V: ESP32-S3-1.1 (3V3), ESP32-S3-1.2 (3V3), USR-ES1.B2 (3V3_1), USR-ES1.B3 (3V3_2); also elsewhere on the board
AUDIO_IN: R1.1; also elsewhere on the board
CS: ESP32-S3-1.5 (GPIO5/ADC1_CH4), USR-ES1.A5 (CS)
GND: ESP32-S3-1.22 (GND), ESP32-S3-1.23 (GND), ESP32-S3-1.24 (GND), ESP32-S3-1.44 (GND), USR-ES1.A1 (GND_1), USR-ES1.A2 (GND_2), USR-ES1.B1 (GND_3); also elsewhere on the board
INT: ESP32-S3-1.7 (GPIO7/ADC1_CH6), USR-ES1.A6 (INT)
MISO: ESP32-S3-1.33 (GPIO36), USR-ES1.B6 (MISO)
MOSI: ESP32-S3-1.32 (GPIO35), USR-ES1.A3 (MOSI)
unnamed: ESP32-S3-1.13 (GPIO3/ADC1_CH2), R1.2
PWR_BTN: ESP32-S3-1.10 (GPIO17/ADC2_CH6); also elsewhere on the board
PWR_LED: ESP32-S3-1.29 (GPIO48); also elsewhere on the board
REG_5V: ESP32-S3-1.21 (5V); also elsewhere on the board
RST: ESP32-S3-1.35 (GPIO38), USR-ES1.B5 (RST)
S0: ESP32-S3-1.27 (GPIO21); also elsewhere on the board
S1: ESP32-S3-1.34 (GPIO37); also elsewhere on the board
S2: ESP32-S3-1.30 (GPIO45); also elsewhere on the board
S3: ESP32-S3-1.28 (GPIO47); also elsewhere on the board
SCLK: ESP32-S3-1.11 (GPIO18/ADC2_CH7), USR-ES1.A4 (SCLK)
VU_uC_1: ESP32-S3-1.6 (GPIO6/ADC1_CH5); also elsewhere on the board
led_VU: ESP32-S3-1.4 (GPIO4/ADC1_CH3); also elsewhere on the board
sig_1: ESP32-S3-1.41 (GPIO1/ADC1_CH0); also elsewhere on the board

Notes on the sheet:
Ethernet Module
ESP32-S3

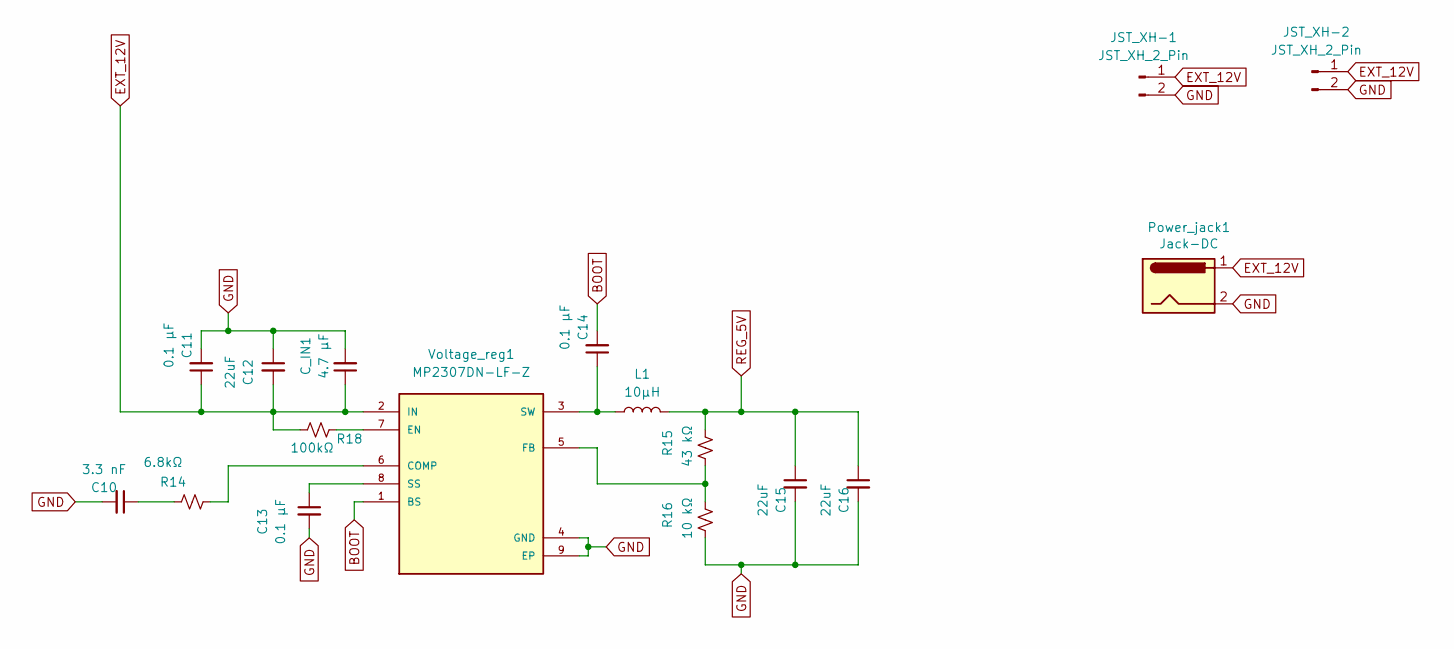
[picture p91: schematic Voltage_Regulator.kicad_sch]

Parts:
C10: 3.3 nF; C_0603_1608Metric; LCSC Part Number C1613
C11, C13, C14: 0.1 µF; C_0402_1005Metric; LCSC Part Number C1525
C12, C15, C16: 22uF; C_0603_1608Metric; LCSC Part Number C59461
C_IN1: 4.7 µF; C_0402_1005Metric; LCSC Part Number C23733
JST_XH-1, JST_XH-2: JST_XH_2_Pin; JST_XH_B2B-XH-A_1x02_P2.50mm_Vertical
L1: 10µH; L_Bourns-SRN8040_8x8.15mm; LCSC Part Number C37429
Power_jack1: Jack-DC; BarrelJack_Horizontal
R14: 6.8kΩ; R_0603_1608Metric; LCSC Part Number C23212
R15: 43 kΩ; R_0402_1005Metric; LCSC Part Number C2906943
R16: 10 kΩ; R_0402_1005Metric; LCSC Part Number C25744
R18: 100kΩ; R_0603_1608Metric
Voltage_reg1: MP2307DN-LF-Z; SOIC-8-1EP_3.9x4.9mm_P1.27mm_EP2.29x3mm_ThermalVias; PARTREV 1.9; LCSC Part Number C2928813

Connections:
BOOT: C14.2, Voltage_reg1.1 (BS)
EXT_12V: C11.1, C12.2, C_IN1.1, JST_XH-1.1, JST_XH-2.1, Power_jack1.1, R18.1, Voltage_reg1.2 (IN)
GND: C10.2, C11.2, C12.1, C13.2, C15.2, C16.2, C_IN1.2, JST_XH-1.2, JST_XH-2.2, Power_jack1.2, R16.2, Voltage_reg1.4 (GND), Voltage_reg1.9 (EP); also elsewhere on the board
unnamed: C10.1, R14.1
unnamed: R14.2, Voltage_reg1.6 (COMP)
unnamed: R18.2, Voltage_reg1.7 (EN)
unnamed: R15.2, R16.1, Voltage_reg1.5 (FB)
unnamed: C13.1, Voltage_reg1.8 (SS)
unnamed: C14.1, L1.1, Voltage_reg1.3 (SW)
REG_5V: C15.1, C16.1, L1.2, R15.1; also elsewhere on the board

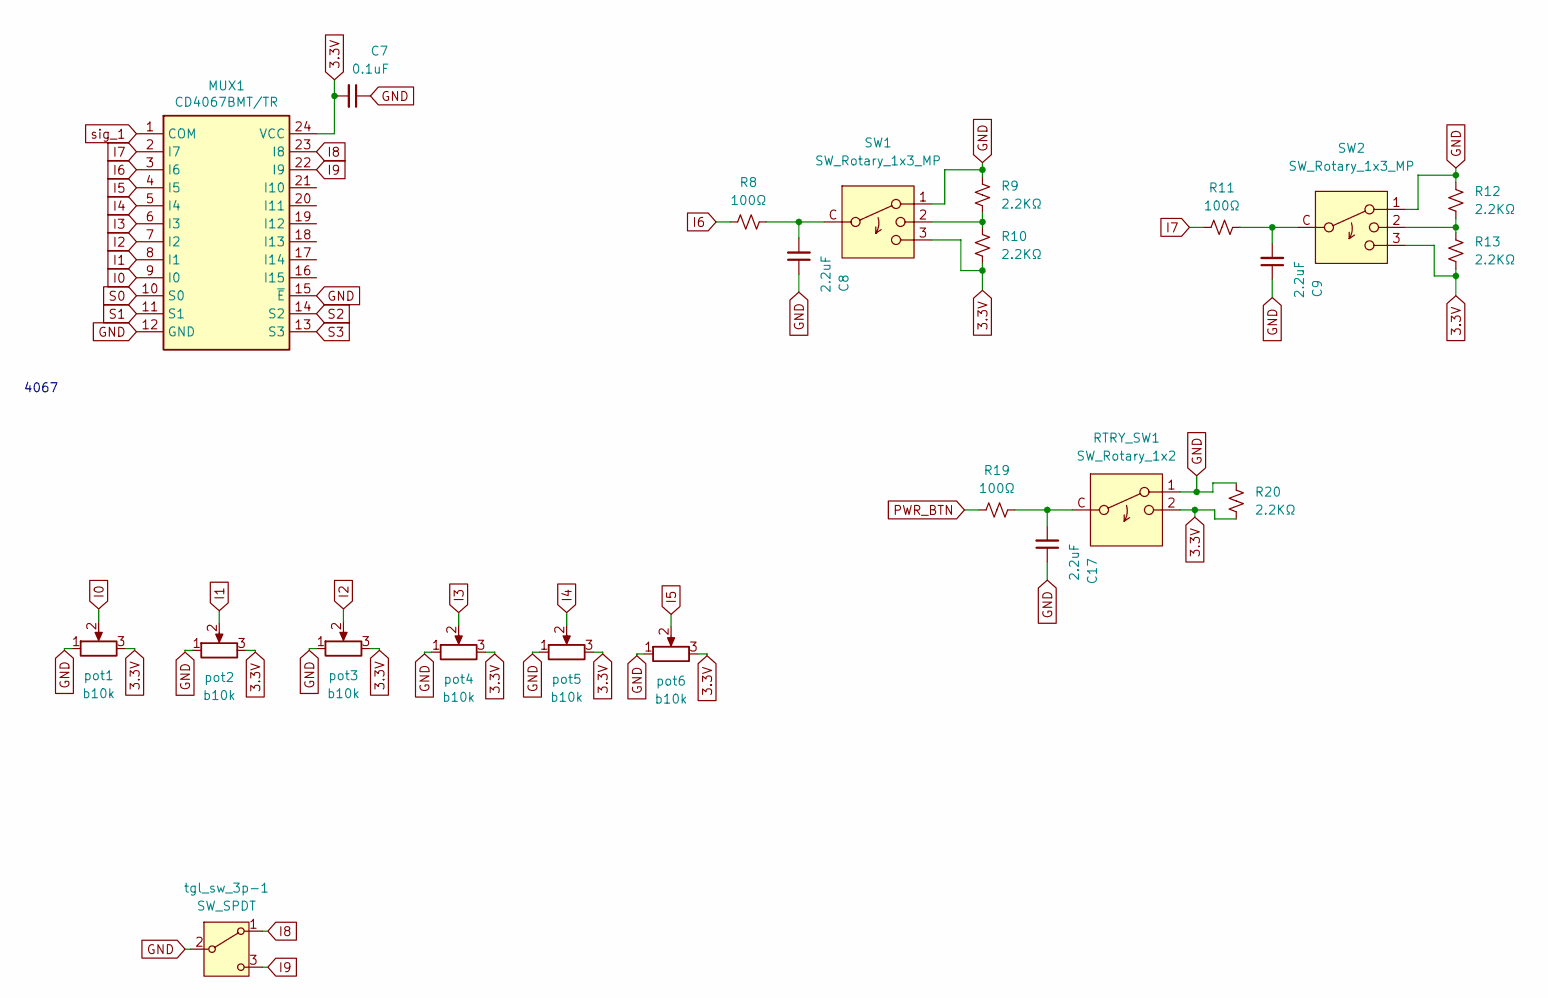
[picture p92: schematic multiplexers.kicad_sch]

Parts:
C7: 0.1uF; C_0402_1005Metric; LCSC Part Number C1525
C8, C9: 2.2uF; C_0402_1005Metric; LCSC Part Number C12530
C17: 2.2uF; C_0402_1005Metric; Manufacturer_Part_Number CL05A225MQ5NSNC; LCSC Part Number C12530
MUX1: CD4067BMT/TR; TSSOP-24_4.4x7.8mm_P0.65mm; LCSC Part Number C7432333
R8, R11: 100Ω; R_0402_1005Metric; LCSC Part Number C25076
R9, R10, R12, R13: 2.2KΩ; R_0402_1005Metric; LCSC Part Number C25879
R19: 100Ω; R_0402_1005Metric; Manufacturer_Part_Number 0402WGF1000TCE; LCSC Part Number C25076
R20: 2.2KΩ; R_0402_1005Metric; Manufacturer_Part_Number 0402WGF2201TCE; LCSC Part Number C25879
RTRY_SW1: SW_Rotary_1x2; SW_Rotary_RS25-2P
SW1, SW2: SW_Rotary_1x3_MP; SW_Rotary_RS25-3P
pot1, pot2, pot3, pot4, pot5, pot6: b10k; Potentiometer_Alps_RK09K_Single_Vertical
tgl_sw_3p-1: SW_SPDT; Toggle_Switch-3-pins

Connections:
3.3V: C7.2, MUX1.24 (VCC), R10.1, R13.1, R20.1, RTRY_SW1.2, SW1.3, SW2.3, pot1.3, pot2.3, pot3.3, pot4.3, pot5.3, pot6.3; also elsewhere on the board
GND: C7.1, C8.1, C9.1, C17.1, MUX1.12 (GND), MUX1.15 (~E), R9.2, R12.2, R20.2, RTRY_SW1.1, SW1.1, SW2.1, pot1.1, pot2.1, pot3.1, pot4.1, pot5.1, pot6.1, tgl_sw_3p-1.2 (B); also elsewhere on the board
I0: MUX1.9 (I0), pot1.2
I1: MUX1.8 (I1), pot2.2
I2: MUX1.7 (I2), pot3.2
I3: MUX1.6 (I3), pot4.2
I4: MUX1.5 (I4), pot5.2
I5: MUX1.4 (I5), pot6.2
I6: MUX1.3 (I6), R8.1
I7: MUX1.2 (I7), R11.1
I8: MUX1.23 (I8), tgl_sw_3p-1.1 (A)
I9: MUX1.22 (I9), tgl_sw_3p-1.3 (C)
unnamed: C8.2, R8.2, SW1.C
unnamed: C9.2, R11.2, SW2.C
unnamed: C17.2, R19.2, RTRY_SW1.C
unnamed: R9.1, R10.2, SW1.2
unnamed: R12.1, R13.2, SW2.2
PWR_BTN: R19.1; also elsewhere on the board
S0: MUX1.10 (S0); also elsewhere on the board
S1: MUX1.11 (S1); also elsewhere on the board
S2: MUX1.14 (S2); also elsewhere on the board
S3: MUX1.13 (S3); also elsewhere on the board
sig_1: MUX1.1 (COM); also elsewhere on the board

Notes on the sheet:
4067

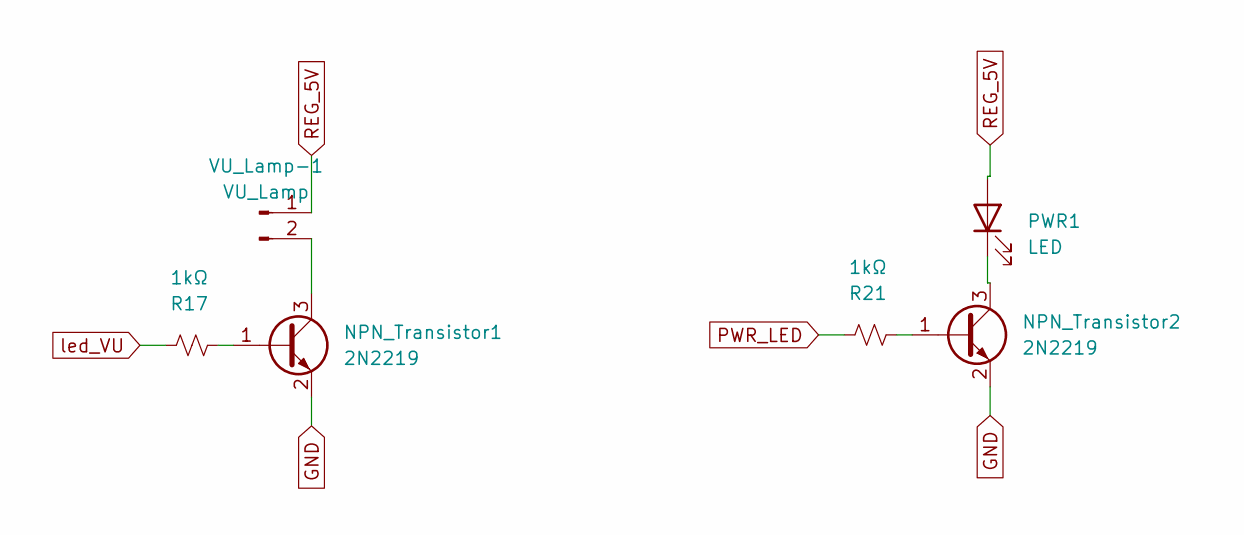
[picture p93: schematic VU_lamp_1.kicad_sch]

Parts:
NPN_Transistor1, NPN_Transistor2: 2N2219; SOT-23; LCSC Part Number C2150
PWR1: LED; PinSocket_1x02_P2.54mm_Vertical
R17, R21: 1kΩ; R_0402_1005Metric; Manufacturer_Part_Number 0402WGF3300TCE; LCSC Part Number C11702
VU_Lamp-1: VU_Lamp; PinSocket_1x02_P2.54mm_Vertical

Connections:
GND: NPN_Transistor1.2 (E), NPN_Transistor2.2 (E); also elsewhere on the board
unnamed: NPN_Transistor1.1 (B), R17.1
unnamed: NPN_Transistor1.3 (C), VU_Lamp-1.2
unnamed: NPN_Transistor2.1 (B), R21.1
unnamed: NPN_Transistor2.3 (C), PWR1.1 (K)
PWR_LED: R21.2; also elsewhere on the board
REG_5V: PWR1.2 (A), VU_Lamp-1.1; also elsewhere on the board
led_VU: R17.2; also elsewhere on the board
