eSpark-Backup/patrizio-moi-pcb-fixes/Design_Files/24 - SSL EQ Rack - 6-June-2025/SSL-EQ-Rack.kicad_pcb

## KiCad design Client-Files/06 - TubeTech CL1B - 3-July-2025/TubeTech_CL1.kicad_pcb (continued)

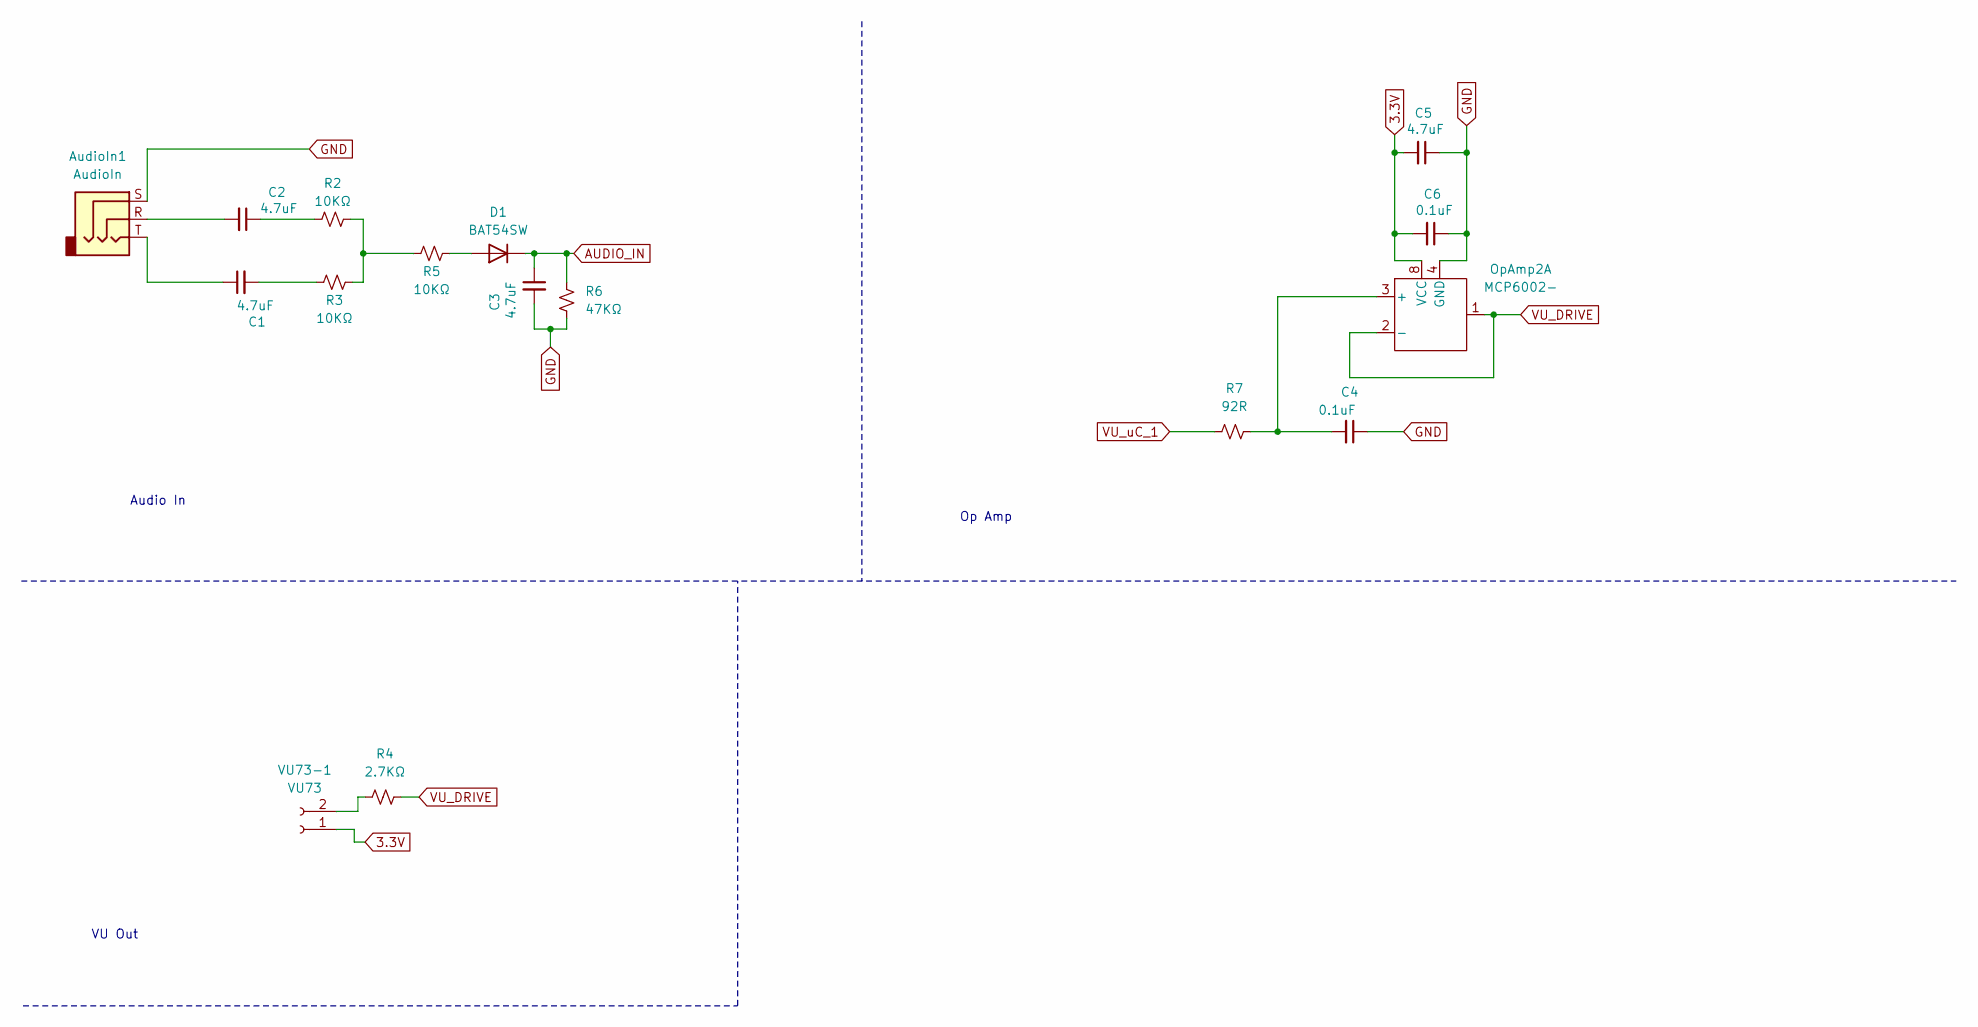
[picture p94: schematic VU73.kicad_sch]

Parts:
AudioIn1: AudioIn; Jack_3.5mm_PJ320D_Horizontal; LCSC Part Number C22459515
C1, C2, C3, C5: 4.7uF; C_0402_1005Metric; LCSC Part Number C23733
C4: 0.1uF; C_0402_1005Metric
C6: 0.1uF; C_0402_1005Metric; LCSC Part Number C1525
D1: BAT54SW; D_SOD-323; LCSC Part Number C27636114
OpAmp2: MCP6002-; SOIC-8_3.9x4.9mm_P1.27mm; LCSC Part Number C7377
R2, R3, R5: 10KΩ; R_0402_1005Metric; LCSC Part Number C25744
R4: 2.7KΩ; R_0603_1608Metric; LCSC Part Number C13167
R6: 47KΩ; R_0402_1005Metric; LCSC Part Number C25792
R7: 92R; R_0402_1005Metric
VU73-1: VU73; PinSocket_1x02_P2.54mm_Vertical

Connections:
3.3V: C5.2, C6.2, OpAmp2.8 (VCC), VU73-1.1; also elsewhere on the board
AUDIO_IN: C3.1, D1.1 (K), R6.2; also elsewhere on the board
GND: AudioIn1.S, C3.2, C4.1, C5.1, C6.1, OpAmp2.4 (GND), R6.1; also elsewhere on the board
unnamed: AudioIn1.R, C2.2
unnamed: AudioIn1.T, C1.1
unnamed: C1.2, R3.2
unnamed: C2.1, R2.2
unnamed: D1.2 (A), R5.1
unnamed: C4.2, OpAmp2.3 (+), R7.1
unnamed: R2.1, R3.1, R5.2
unnamed: R4.2, VU73-1.2
VU_DRIVE: OpAmp2.1, OpAmp2.2 (-), R4.1
VU_uC_1: R7.2; also elsewhere on the board

Notes on the sheet:
VU Out
Op Amp
Audio In

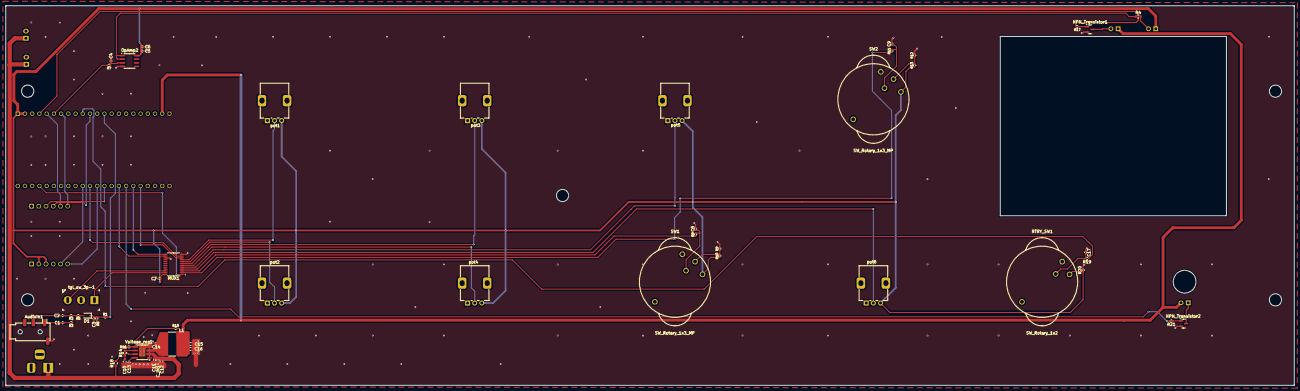
[picture p95: board TubeTech_CL1.kicad_pcb from above]

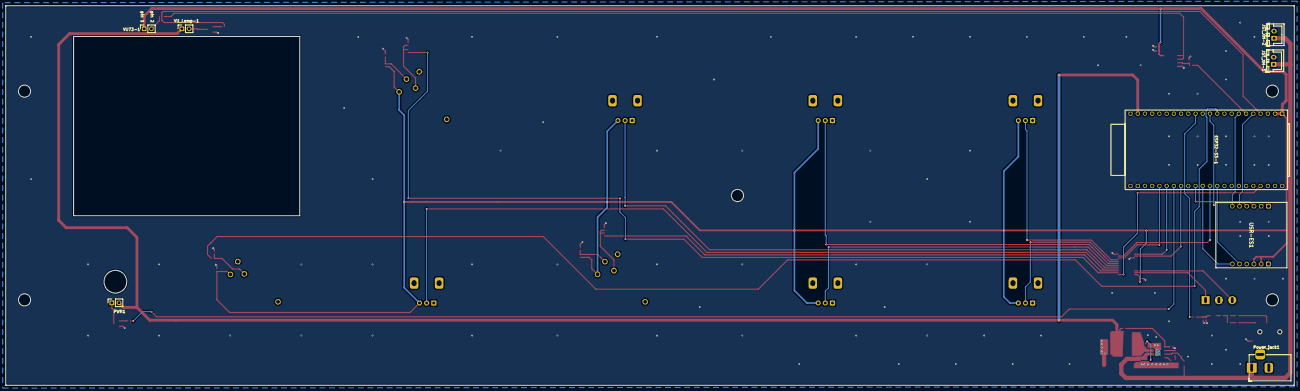
[picture p96: board TubeTech_CL1.kicad_pcb from below]

Board: 2 copper layers, 452.9 x 133.4 mm, 65 parts (8 on the bottom side), 56 nets.
