eSpark-Backup/patrizio-moi-pcb-fixes/(commit log)

2025-07-31 Client Files pushed
    [10 - Manley VS-MU-2.dxf, 10 - Manley VS-MU.dxf, 14 - Drawmer DS-201.dxf, 16 - Fairchild 670 -2.dxf, 16 - Fairchild 670.dxf, 17 - Summit EQP 200B.dxf, 19 - SSL FXG384.dxf, 20 - Teletronix LA3A.dxf]
2025-08-01 #1 Placement in progress
    [Manley-VS-MU.kicad_pcb]
2025-08-04 Design_files folder added
    [10 - Manley VS-MU-2.dxf, 10 - Manley VS-MU.dxf, Maley-edge.dxf, Manley-VS-MU.kicad_pcb, Manley-VS-MU.kicad_sch, Manley-VS-MU.step, S10 for PCB Adeel.DXF, VU42.kicad_sch]
2025-08-04 #1 Routing in progress
    [Manley-VS-MU.kicad_pcb, client.kicad_pcb]
2025-08-05 #1 Completed
    [10 - Manley VS-MU-2.dxf, 10 - Manley VS-MU.dxf, Maley-edge.dxf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]
2025-08-06 #3 Completed Deliverables generated
    [14 - Drawmer DS-201.dxf, 4067.kicad_sch, Drawmer-DS-201.kicad_pcb, Drawmer-DS-201.kicad_sch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]
2025-08-06 #4 in progress
    [4067.kicad_sch, LEDs.kicad_sch, SSL-EQ-Rack.kicad_pcb, SSL-EQ-Rack.kicad_sch, SSL24.dxf, Voltage_Regulator.kicad_sch, power.kicad_sch]
2025-08-07 #4 Completed
    [SSL-EQ-Rack-B_Cu.gbr, SSL-EQ-Rack-B_Mask.gbr, SSL-EQ-Rack-B_Paste.gbr, SSL-EQ-Rack-B_Silkscreen.gbr, SSL-EQ-Rack-Edge_Cuts.gbr, SSL-EQ-Rack-F_Cu.gbr, SSL-EQ-Rack-F_Mask.gbr, SSL-EQ-Rack-F_Paste.gbr]
